26037-arch/physical_computing_project/docs/PHYSICS_V4.md

# V4 물리 검토와 Rev D 수정

기준은 `ab8c454`의 Rev C다. 주 구동계(측면4+D헤드, 6 mm 강재 막대, 24/30 mm 이송)는 유지하고, 운전 알고리즘·스위치 받침·접점 입력과 키 맞춤 공정을 보완했다. 출력물 종류/수량은33종93개로 같다.
**설계·코드 검증과 실물 하중 합격은 다르다. 서보의 끼임 힘을 물리적으로 제한하는 장치는 아직 검증하지 못했으므로 무인 운전이 가능한 완성품이라고 판단하지 않는다.**

## 발견한 문제와 반영한 해결

| 문제 | 근거 | 반영 |
|---|---|---|
| R/L 뒤집기가 중앙층을 보장하지 않음 | 모터는 R/L 바깥층의 핀만 구동한다. 중앙층·코어를 같은 각도로 묶는 연결이 없다. 마찰은 마모·윤활·가속에 따라 변한다 | **자동 뒤집기 폐지**. 상단을 고정한5면 알고리즘으로 섞기/풀이. 저수준 flip도 펄스0 |
| 해제된 접점만으로 두 헤드 후퇴를 판단 | 직렬 NO는 한쪽만 열려도 HIGH. 게다가 결합 스위치 해제는 완전 후퇴를 뜻하지 않음 | **모듈6개×결합/후퇴2개=12개**의 독립 끝 센서. 74HC165×2로3개 MCU핀에서 읽음. 짝의 모든 목표 끝 ON·반대 끝 OFF여야 진행 |
| 스위치 몸체가 이송 경로에 위치 | 기존 전진 스위치는 중간 캐리지와300.523 mm³ 겹쳤다. 단순히24 mm 뒤에 추가한 후퇴 스위치도 서보 크래들/링크와 겹침 | **P13/P29 바깥 받침**으로 모든 몸체를 x41에 배치. 몸체 안쪽 x34.6은 링크 최대x33보다 밖이다. 8 mm 이상 돌출한 긴 레버 끝만 캐리지에 접촉 |
| 순간 서보 끝각 지령의 접근 충격 | MG996R 실제 속도·하중이 미지정이며 이전400ms 표시는 힘/속도 제한이 아니었음 | **1도/4ms 지령**, 전체720ms. JS도 같은 각도 진행·시간 사용. 정적 과부하 제한은 별개 |
| 잠금 사각 유격이 탄성 변형보다 큼 | 6 mm 막대/6.4 소켓은 한 방향3.960°, 강재 막대의0.10N·m 탄성 비틀림은0.092° | 실제 막대와 이형 필름으로 **맞춤층 공정** 추가. 내부8mm 코어 키 틈도 충전. 경화·맞춤·전체 강성 실측은 필수 |
| 예전 간섭 검사로 물리 안정성을 과대 판단 가능 | 끝 자세·이산 BRep는 중간 접촉, 힘, 마찰, 적층 강도·크리프를 증명하지 않음 | 스위치/캐리지/크랭크/링크의13개 실제 중간 자세 검사 추가. 해석 계산과 실물 시험 결과를 별도 기록 |

## 5면 운전은 풀이 능력을 잃지 않는가

흰색 U를 아래로 장착한 orient=1을 유지한다. 논리 U는 물리D 헤드이고, 논리D는 헤드가 없는 상단이다. D회전을 제외한15개 수만 사용한다.
크로스는15수 IDA*와 그 집합의 쌍 거리표, F2L은 기존 U/측면 트리거, OLL/PLL은 D 없는 동등 수열을 사용한다. 기존 공식 중 D가 들어간 경우를 F2L을 보존하는 마지막층 그래프에서 변환했다.
일반6면으로 섞인 상태도 풀 수 있다. 로봇이 직접 만드는 섞기만 D를 제외한다. `M F D R` 같은 수동 명령은 앞부분도 실행하지 않고 전체 거부한다.
LOCK은 장착 중 계속 유지한다. F/FLIP은 실제/가상 모두 오류를 반환하며 모터 펄스를 내지 않는다.

`check_five_face_solver.js` 전수 결과:

- 크로스 **190,080상태**, D 없이 모두 도달, 최장 **10수**. 안전 탐색 한계14 이내.
- 마지막층 **62,208상태** 모두 해결. OLL216방향 상태·PLL288순열 상태, 최대 단계25수.
- 일반6면20수로 섞은 **1,000개 시드** 모두 해결, 최대75수, D회전0.
- 실제 C++와 JS를300시드로 교차 비교해 수열·탐색 노드 수3,300줄 일치.

## 새 센서 부품과 정확한 위치

추가 구매는 스위치6개(총12개), **74HC165 두 개**, 10kΩ12개와100nF2개다. 사진의74HC595는 출력용이므로 대체할 수 없다.
첫 페이지의 B18/B21과 개정 제작 설명서에 반영했다. 기존 직렬 센서 배선으로 새 펌웨어를 사용하면 안 된다.

| 모듈 | 몸체 중심 (국소 mm) | 장공 X / Z |
|---|---|---|
| F/R/B/L/D 결합 | (41,−47.75,137.1) | X37.75/44.25, Z137.1 |
| F/R/B/L/D 완전 후퇴 | (41,−47.75,180.9) | 같은 X, Z180.9 |
| LOCK 결합 | (41,24,194.1) | 같은 X, Z194.1 |
| LOCK 완전 후퇴 | (41,24,243.9) | 같은 X, Z243.9 |

긴 레버는 몸체 안쪽에서8 mm 이상 나와 캐리지 x≈28에 닿아야 한다. 앞/뒤 스위치는 접근 방향을 향하도록 긴 축 X 기준180° 반전한다. 실제 레버의 길이·작동점·오버트래블은 구매 도면과 대조한다. 스위치 몸체를 기계 스토퍼로 사용하지 않는다.
P13은 레일/프로파일 체결 기준을 유지한 채 바깥 탭을 추가했다. P29는 기존 M04 체결 두 점을 유지하고 바깥 플랜지를 추가했다. 새 파일로 출력해야 한다.

가까운74HC165 D0..D5=결합 F/B/R/L/D/LOCK, 먼 칩 D0..D5=후퇴 같은 순서다. 각 입력10kΩ→5V, NO→GND. 가까운 Q7→D12, 먼 Q7→가까운 DS, 두 CP→D13, 두 PL→A0, CE→GND. 먼 DS 및 D6/D7→5V. 칩당100nF. A1은 여유다.
시리얼 `I`는 실제 접점의 `SENS order=FBRLDK en=...... rt=...... frame=1`을 출력한다. 캐시된 장착 상태와 독립적으로12개를 하나씩 시험한다.
Q7을 상승 클록 **전에** 읽는다. 미사용 입력 네 개가 HIGH인지도 확인해 프레임 오류를 거부한다.
전진/후퇴를 명령한 뒤 접점을 확인하고, 매 회전 준비 전후에 전체 끝 상태를 재확인한다. 실패 후에도 캐시된 장착 상태만 믿지 않고 실제 접점을 다시 읽는다.

공개 부품 핀 명칭 근거: [Wokwi 74HC165 문서 원문](https://github.com/wokwi/wokwi-docs/blob/main/docs/parts/wokwi-74hc165.md). GPIO 클록 파형·접점 채터링·실제 배선은 보드에서 추가 확인한다.

## 강성·중력·관성 계산

`check_robot_v4_physics.py`는 mm를 SI로 바꿔 계산하고 `physics_checks.json`에 가정과 결과를 저장한다. 유한요소해석이나 재료 시험을 수행한 결과가 아니다. **0.10N·m는 시험 기준이며 드라이버가 자동으로 보장하는 토크 제한이 아니다.**

| 항목 | 계산 결과 / 의미 |
|---|---|
| 두 핀 균등 분담 | T/(2r)=2.618N/핀 (r19.1mm) |
| 한 핀에 전부 집중 | T/r=5.236N |
| Ø3 강철핀, 노출9.8mm 보수적 외팔보 | 최대 굽힘19.36MPa, 끝변위0.00207mm (E200GPa 가정) |
| 원통 결합2mm의 평균 접촉압력 | 한 핀 집중 시0.873MPa. 모서리 응력·적층 박리·충격은 포함하지 않음 |
| 6mm 강재 막대230mm 비틀림 | J≈0.1406a⁴, G79GPa일 때0.0915°. 알루미늄 G26GPa라면0.278° |
| 180mm 자유 구간의 강재 굽힘 | 끝 모멘트0.10N·m에서0.075mm, 가이드/고정부 변형 제외 |
| 기존 사각 소켓 한 방향 놀이 | asin(6.4/(6√2))−45°=3.960° |
| 맞춤층 총 평면 간극0.02~0.04mm | 소켓 놀이 최대0.383° + 강재 탄성0.092° = **0.475°**. 고정부·내부 키·경화재 변형은 추가됨 |
| Ø3/Ø3.4 핀 소켓 자체 놀이 | 한 방향 약0.600°. 반복 오차0.5°를 이 간극만으로 보장할 수 없음 |

100% 솔리드 CAD 큐브 체적155,612mm³에 PETG1.27g/cm³와 금속부속30g을 가정하면 큐브 질량은약0.228kg, 중력2.23N이다. 실제 충전율/재료/부속 질량을 측정해 대체한다.
기존 스텝 램프의 관성 추정은 한 층에약0.00025N·m다(시작 충격·스텝 리플·모터 회전자 제외). 정상 저속 운전에서는 관성보다 마찰과 간섭이 지배할 가능성이 크다. 따라서 걸림을 속도나 전류 증가로 해결하면 안 된다.

## 맞춤층은 어떻게 적용하는가

B22는 본체를 무조건 접착하라는 지시가 아니다. J02 시험편에서 실제 강재 막대를 원형으로 삼아 틈만 채우는 공정을 먼저 검증한다. 미경화 재료의 재질 호환성, 저수축·경화·압축 특성을 공급자 자료로 확인한다.
막대 네 평면에 이형 필름을 대고 전체 맞은편 치수가 실제 막대보다0.02~0.04mm 큰지 측정한다. 주름·겹침을 하중면에 두지 않는다. 이형 처리하지 않은 막대를 충전재에 넣으면 분리되지 않을 수 있다.
P03의6.4 소켓 벽에만 소량을 넣고 수동으로4mm 삽입해 정렬·완전 경화한다. 바닥/M3자리/가이드를 막지 않는다. 제거 후 미끄럼과30mm 왕복을 확인한다. 내부8.3 포켓/8mm 키도 나사·구면 트랙을 보호하며 틈을 채운다. 일반 센터4개와 움직이는 접촉면은 접착하지 않는다.
사각 형상과 M3 나사가 하중·축방향 이탈을 잡고, 맞춤층이 빈틈을 줄인다. 제조 공정 추가만으로 실제0.5° 미만을 달성했다고 주장하지 않는다. 전체 코어에50mm 레버×2N을 양방향으로 가해 합격을 확인해야 한다. 불합격이면 금속 정밀 키 인서트 등 재설계가 필요하다.

## 남은 물리적 한계: 사점에서의 삽입 힘

슬라이더 위치 z=axis−r cosθ−√(L²−r²sin²θ), 따라서
F≈τ / |dz/dθ|이다. 1N·m 서보를 가정하면 θ5°에서약718N,10°에서361N이 되는 이상 강체 값이다. 실제값은 서보·링크·전원·마찰·변형에 제한되지만, **사점에서 힘이 작아진다는 뜻은 아니다.**
720ms의 완만한 지령, 끝 센서, 타임아웃은 진입 충격과 잘못된 후속 회전을 줄인다. 접점은 힘 센서가 아니므로 핀이 비스듬히 걸렸을 때의 최대 정적 힘은 보장하지 못한다.
검증된 직렬 탄성 링크나 축방향 힘 제한기 없이 무인 운전용으로 확정하지 않는다. 이번 작업에서는 실측 없이 힘 제한 부품을 검증 완료로 꾸미거나 출력물 강도 인증을 만들지 않았다.

그 밖에 A4988 전류/실제 토크, 탈조·축 미끄러짐(엔코더 없음), 벨트 장력·크리프·피로·발열과 실제 레버 수명은 실물 시험 항목이다. 0.20/0.40N·m에서는 한 핀 평균 접촉압력이1.75/3.49MPa로 올라가므로0.10N·m 계산을 그 하중에 그대로 적용하지 않는다.

## 재현과 검증 범위

```sh
node tools/gen_robot_contract.js --check
node tools/check_robot_contract.js
node tools/gen_tables.js
node tools/check_five_face_solver.js
node tools/host_check.js 1 300
node tools/host_mechanism_check.js
node tools/test_sim_v4.js
python tools/check_robot_v4_physics.py
python tools/check_robot_v4.py
python tools/check_robot_v4_kit.py
python tools/check_robot_v4_meshes.py
python tools/check_robot_v4_manual.py
```

- 실제 C++ 기구 비교:648오류 시나리오·4,860명령 +4,096접점 조합(추가 프레임 오류 포함). 한쪽만 후퇴/양 끝 동시 닫힘·오류 복구·금지 수열의 전체 거부·실제 S42→V 실행 확인.
- 웹:1배/4배 총360수, 섞기→풀이, 장착/배출, 오류 복구, 금지D/FLIP. 40,987프레임, 뒤집기0.
- CAD: 본체 이산 검사와 키트의 스위치 몸체/크랭크/링크/캐리지13자세를 함께 검사한다. 실제 레버는 구매 도면 대조 대상이며 유연 접촉을 BRep 강체 간섭으로 승인하지 않는다.
- Arduino UNO R3/R4 WiFi 컴파일 결과는 `SETUP.md`에 기록한다. RAM 여유와 실측 스택 여유를 구분한다.
- Wokwi 시나리오는 생성했지만 현재 세션에는 CLI/토큰·실물 보드가 없어 전기 시뮬레이션과 실제 운전을 실행하지 않았다.
