26037-arch/physical_computing_project/docs/PIPELINE.md

# 개발 파이프라인

> 한 줄 요약: **공식표·거리표는 PC(Node)에서 생성 → 같은 알고리즘을 JS와 C++로 → Arduino CLI 컴파일 → Wokwi에서 보드 출력과 JS 출력을 글자 단위로 교차검증 → Fusion 360 API로 부품 생성·STL → 같은 STL을 JS 3D 시뮬레이터에 임베드.**

```
tools/algs.js (OLL 57 · PLL 21, 사람 표기)      sim/cube.js (큐브 모델, 18수, 표기 변환)
          │                                              │
          └────────────► node tools/gen_tables.js ◄──────┘
                         ├─ 공식 → 겉면 6면 수열 변환(wide/슬라이스/회전 제거)
                         ├─ 역연산으로 OLL/PLL 인식 키 생성, 216/288 전 경우 커버리지 검증
                         └─ 크로스 쌍 BFS 거리표, F2L 트리거 매크로 거리표 생성 (+ F2L 전수 해결 가능성 검사)
                 ┌─────────────────┴──────────────────┐
     firmware/main/tables.h (PROGMEM ≈10.8 KB)  sim/tables.js
                 │                                     │
   firmware/main/{cube,solver,motors}.cpp + main.ino   sim/solver.js (같은 IDA*·같은 순서)
                 │                                     │
                 ├──── node tools/host_check.js ───────┤  (g++ 로 펌웨어 풀이기 PC 빌드 → JS 와 시드별 출력 비교)
   scripts/build.ps1 (arduino-cli, Uno)                node tools/test_solver.js (300회 회귀)
   arduino-cli compile --fqbn arduino:renesas_uno:unor4wifi --output-dir build/r4 firmware/main (실물)
                                                       node tools/gen_wokwi_test.js <seed>
                 │                                     │  → tests/solve_seed<seed>.test.yaml
                 └──────────► scripts/simulate.ps1 -Scenario tests/solve_seed1.test.yaml
                              (V4 Rev D: 최상위 diagram.json / V5: v5/scripts/simulate.ps1 -Scenario tests/… (v5 기준), v5/diagram.json; 기구 줄 flips/spins 도 비교)
                              보드 시리얼 출력 == JS 풀이 출력 ⇒ 통과

tools/robot_v5_params.py (치수 P) ──► tools/check_robot_v5.py (2D 운동학·힘 평형) ──► models/robot_v5/kinematic_checks.json
                                   └──► tools/build_robot_v5.py (CadQuery) ──► models/robot_v5/print/*.stl|step, robot_assembly.step/glb, parameters.json
                                        tools/check_robot_v5_cad.py (3D 간섭) ──► mechanical_checks.json
                                        node tools/embed_models_v5.js ─► v5/sim/models.js (출력 7종 STL + 매개변수)
                                        fusion/scripts/import_robot_v5.py ──(Fusion MCP script)──► models/robot_v5/CubeRobotV5.f3d
                                                                                   │
                                            v5/sim/index.html + v5/sim/app.js (Three.js 3D 시뮬레이터: 시중 큐브 + 20° 컵 + 후드 + 리프터, v5/sim/mechanism.js 동작 목록 재생; 최상위 sim/ 은 V4 Rev D)
  (이력: V1 fusion/scripts/cube_robot_parts.py, V2/V3/V4 tools/build_robot_v*.py, models/robot_v2~v4)
```

## 두 버전
V4 Rev D 는 최상위(`firmware/main`, `sim/`, `tests/`, `scripts/`), V5 는 `v5/` 아래 같은 구조다. 아래 표의 경로 앞에 `v5/` 를 붙이면 V5 명령이 된다 (`node v5/tools/gen_wokwi_test.js 1`, `v5/scripts/simulate.ps1 -Scenario tests/solve_seed1.test.yaml` (시나리오 경로는 v5 기준)).

## 단계별 명령

| 단계 | 명령 | 결과물 |
|---|---|---|
| 1. 표 생성 | `node tools/gen_tables.js` | `firmware/main/tables.h`, `sim/tables.js` (커버리지 검증 포함, 실패 시 종료코드 1) |
| 2. 풀이기 회귀 | `node tools/test_solver.js 300 1` | 300 섞기 전부 풀림 + 수/노드/시간 통계 |
| 2'. 펌웨어 == JS (호스트) | `node tools/host_check.js 1 300` | g++ 로 `cube.cpp`·`solver.cpp` 를 PC 빌드해 300 시드의 단계·수열·노드 수가 JS 와 글자 단위로 같은지 확인 (Wokwi 없이 수 초) |
| 3. 컴파일(시뮬) | `powershell -ExecutionPolicy Bypass -File scripts/build.ps1` | `build/main.ino.hex` (Uno) |
| 3'. 컴파일(실물) | `arduino-cli compile --fqbn arduino:renesas_uno:unor4wifi --output-dir build/r4 firmware/main` | R4 WiFi 바이너리 |
| 4. 교차검증 시나리오 | `node tools/gen_wokwi_test.js 1` | `tests/solve_seed1.test.yaml` |
| 5. 시뮬레이션 | `powershell -ExecutionPolicy Bypass -File scripts/simulate.ps1 -Scenario tests/solve_seed1.test.yaml -TimeoutMs 180000` | `Scenario completed successfully` |
| 5'. 버튼 시나리오 | `... -Scenario tests/buttons.test.yaml -TimeoutMs 180000` | 무작위 시드로 섞고 풀어 `SOLVED ok=1` |
| 5''. V4 기구 절차 | `node tools/gen_mechanism_test.js` → `... -Scenario tests/mechanism_v4.test.yaml -TimeoutMs 150000` | 실제 모드: LOAD 장착 → `M F R U D`(지지 전환·막대·뒤집기, 시나리오가 결합 스위치를 눌러 줌) → 결합 실패 중단 → 배출 |
| 6. 3D 부품 (V4) | `.venv-cad\Scripts\python.exe tools/build_robot_v4.py` → `check_robot_v4.py` → `render_robot_v4.py` (CadQuery 2.7, Python 3.12 venv) | `models/robot_v4/**` STL·STEP·GLB, `parameters.json`, `mechanical_checks.json` |
| 6'. 3D 부품 (V2, 이력) | `python tools/build_robot_v2.py` → `check_robot_v2.py` → `render_robot_v2.py` | `models/robot_v2/**` |
| 6'. 3D 부품 (V1) | Claude Code 에서 `fusion_exec` 로 `fusion/scripts/cube_robot_parts.py` 실행 | `models/center_coupler.stl`, `center_cap.stl`, `motor_mount.stl` |
| 7. STL 임베드 | `node tools/embed_models_v4.js` | `sim/models.js` (V4 출력 부품 STL + `parameters.json` 의 `print_offsets`/`purchased`) |
| 8. 시뮬레이터 | `node tools/serve.js` → http://localhost:8765/sim/ (또는 `sim/index.html` 더블클릭) | 3D 시연 |
| 9. 업로드 | `powershell -ExecutionPolicy Bypass -File scripts/upload.ps1 -Port COMx -Fqbn arduino:renesas_uno:unor4wifi` | 실물 보드 |

## 에이전트 도구 사용

| 도구 | 쓰임 |
|---|---|
| Arduino CLI | Uno / UNO R4 WiFi 두 보드 컴파일, 플래시·RAM 사용량 확인 |
| Wokwi (CLI + MCP) | A4988·스테퍼 1 + 서보 2 회로 시뮬레이션, `write-serial`/`wait-serial`/`set-control` 시나리오로 자동 검증 (풀이 교차검증 + 실제 모드 기구 절차) |
| Fusion 360 (MCP `fusion_exec`) | Python API 로 부품 3종 생성, 치수 검사, STL 내보내기 (`CubeRobotParts` 문서로 저장) |
| Codex 플러그인 | AVR 핫패스 최적화(solver.cpp), 3D 부품 설계 검토(`docs/DESIGN_REVIEW.md`), 시뮬레이터·보고서 리뷰 |

## 자동 생성 파일 (직접 수정하지 않음)

- `firmware/main/tables.h`, `sim/tables.js` ← `tools/gen_tables.js`
- `sim/models.js` ← `tools/embed_models.js` (입력: `models/robot_v2/head/*.stl`, `models/robot_v2/parameters.json`)
- `tests/solve_seed*.test.yaml` ← `tools/gen_wokwi_test.js` (풀이 + 뒤집기/결합 횟수), `tests/mechanism_v4.test.yaml` ← `tools/gen_mechanism_test.js`

핀 배치를 바꾸면 `diagram.json` 과 `firmware/main/motors.h`(STEP/DIR), `mechanism.h`(서보·결합 스위치), `main.ino`(버튼·부저), `docs/HARDWARE_V4.md` 4절을 함께 바꾼다. 기구 절차는 `sim/mechanism.js` 와 `firmware/main/mechanism.cpp` 를 함께 바꾼다.
