26037-arch/physical_computing_project/docs/HARDWARE_V4.md

# 하드웨어 V4 Rev D — 상단 고정 5면 운전·승강 잠금 막대·개별 끝 센서

2026-10-24 · 상태: **CAD 시제품 + 펌웨어·시뮬레이터 구현, 실물 출력·조립·부하 시험 전**.
V3(고정 중앙축·수동 잠금·매 수 `H` 승인)를 대체한다. 이 문서는 펌웨어(`firmware/main/mechanism.*`), 시뮬레이터(`sim/mechanism.js`, `sim/app.js`), CAD(`tools/build_robot_v4.py`)가 공유하는 **치수·좌표·절차의 기준**이다. 세 곳의 숫자가 다르면 이 문서를 고치고 세 곳을 맞춘다.

## 0. 장치 목록 — 기능과 추가한 이유 (현재 기능을 위한 가장 단순한 구성)

큐브 둘레에 **같은 측면 모듈 4개**(F R B L), 아래에 **D 회전 모듈 1개**(측면 모듈과 같되 축이 비어 있고 모터가 옆으로 비킴)와 그 축 속을 지나는 **잠금 막대 1개**. 위는 비어 있다. 이송 모듈6개는 같은 서보 크랭크를 쓰며4개 신호로 제어한다. 각 모듈의 결합/완전 후퇴 끝을 독립 스위치로 확인한다. 흰색 U를 아래로 두고 논리D인 물리 상단은 고정한다.

| 장치 | 수량 | 기능 | 왜 필요한가 (없으면 무엇이 안 되나) |
|---|---|---|---|
| NEMA17 + A4988 (측면 F R B L) | 4 | 면 90°/180° 회전. 정지 중에는 유지 토크로 잡은 층을 고정 | F·B·R·L 수를 돌린다 |
| NEMA17 + A4988 (아래 D, 옆으로 60 mm 비킴, GT2 40T:40T 벨트) | 1 | **아래 면(D) 회전** (사용자 요구: 아래 회전축 유지) | 논리U 층을 아래에서 돌린다. 논리D인 상단은 고정한다. 모터가 축 위에 있으면 잠금 막대가 지나갈 수 없어 옆으로 비키고 벨트 1:1 로 돈다 |
| **중공 회전축** (OD 17 / ID 12.5, 6003 베어링 2) | 1 | D 구동판·핀을 돌리면서 가운데로 잠금 막대를 통과시킨다 | 막대가 아래에서 큐브 중심까지 올라오는 길 |
| 2핀 구동판 + 강철 핀 Ø3 (끝 원뿔 90°) | 5 (측면 **적도 띠 판** 4 + D 판 1) | 엣지 2개의 소켓(90° 카운터싱크 Ø7)에 핀을 꽂아 층을 민다 (측면은 적도 엣지, D 는 DF·DB 엣지). 원뿔 끝과 카운터싱크가 3 mm 까지의 어긋남을 스스로 맞춘다 | 핀으로 층을 돌린다(V2 그대로). 4핀 대신 2핀: D 를 돌릴 때 측면 핀이 D 층 엣지에 박혀 있으면 안 되고, D 구동판 가운데 구멍(Ø22)으로 막대가 지나가야 한다. 측면 판은 **16×50 적도 띠**: D 층 코너가 y축 둘레 반경 38.65 로 쓸고 지나가므로 50×50 판(면에서 5~11 mm)이면 측면 쌍을 결합한 채 D 를 돌릴 수 없다 (2026-10-24 CAD 검사에서 45° 자세 코너당 590 mm³ 겹침 확인) |
| **잠금 막대** (강철 **6×6**, 승강 30 mm) | 1 | 아래에서 중공축을 지나 큐브 **가운데 위치**(U/D 센터 칸 → 센터 판의 사각 소켓)까지 올라와 **코어를 고정** — V3 의 고정 중앙축 역할. 장착 중 올라가 있고, **큐브 배출 때 내려간다** | 측면 한 면을 돌릴 때 큐브 전체가 따라 도는 것을 막는다(V3 가 축으로 해결한 문제). 내려갈 수 있어 장착·배출이 가능하다 |
| 서보 MG996R + 크랭크 + 링크 36 | 6 (신호 4) | 이송 유닛 결합/후퇴. F/B 서보 2개 한 신호, R/L 2개 한 신호, D 1, 막대 1 (크랭크 r12 → 24 mm, 막대는 r15 → 30 mm) | V2/V3 의 수동 M5 나사(24 mm 에 30바퀴)를 자동화. 서보 지령 각도와 별개로 양 끝 센서를 확인한다. 사점 부근 삽입 힘은 커질 수 있으며 별도 실물 시험이 필요하다 |
| 결합/후퇴 마이크로스위치 | 12 (74HC165 두 개) | 각 모듈의 양 끝을 독립 확인 | 핀/막대가 소켓에 안 들어가면 스위치가 안 눌린다 → **회전을 실행하지 않고 중단** |
| MGN12 레일 180 + MGN12H 블록 | 5 | 캐리지 직선 안내 | 24 mm 이송의 흔들림 없는 안내 (V2 그대로). 막대는 출력 가이드 블록으로 안내 |
| 608 ×2 + F8-16M + 커플링 5→8 + Ø8 축 | 4세트 | 측면 스핀들 지지 | V2 그대로 |
| 도넛 큐브 (출력, 코어 1·센터 4·**파인 센터 2**·엣지 12·코너 8) | 1 | U/D 센터는 두께 3 판이 8 mm 안에 있고(도넛 구멍), 판 바깥면에 **6.4 사각 소켓 깊이 5**(막대 끝 아래 **축방향 여유 1 mm**), 판 줄기는 **사각**이라 코어와 함께만 돈다 | 막대가 들어갈 자리와 코어를 잡을 소켓. 나머지는 V2 출력 큐브 그대로 |
| 버튼 1개 (A2) | 1 | **짧게** = START (모델이 풀린 상태면 섞기, 아니면 풀기), **1.2 s 이상** = LOAD 단계(장착/배출) | 핀 18개 중 17개를 모터·서보·스위치·LCD 가 쓴다. 저항 사다리(버튼 3개를 A0 하나에)는 Wokwi 가 아날로그 저항망을 재현하지 못해 검증할 수 없어 버튼 하나로 줄였다 |
| LCD1602 I2C, 부저 | 1, 1 | 단계·상태 표시, 완료/오류 알림 | 기존과 같음 |

**없앤 것과 이유**: 위(U) 헤드 — 위가 열려야 큐브를 넣고 뺄 수 있고, 흰색 U가 아래인 자세를 유지해 아래 D헤드로 논리U를 돌린다. 고정 중앙축·인덱스 휠·잠금핀(V3) — 승강 잠금 막대와 결합 스위치가 대신한다. 승강 벨트·원점 스위치(초안) — 큐브는 손으로 D 핀 위에 올려놓는다. 스텝모터 DIR 핀 5개 — 한 번에 한 모터만 움직이므로 DIR 1개를 공유한다.

## 1. 무엇이 바뀌었나 (V3 → V4)

| V3 | V4 | 이유 |
|---|---|---|
| 회전 헤드 6개 (U 포함) | **측면 헤드 4개 + 아래 D 헤드 1개**, 위는 비어 있음 | 위가 열려야 큐브를 넣고 뺄 수 있다. U 면은 처음부터 아래에 놓고, 상단 D는5면 알고리즘에서 제외한다 |
| 큐브를 관통하는 고정 Ø6 중앙축 (F↔B) | **승강 잠금 막대 6×6** (아래 → 큐브 중심). 장착 중 올라가 코어를 잡고, 배출 때 내려감 | 축의 "큐브 전체 회전 방지" 기능은 유지하면서 장착·배출이 가능 |
| F/B 중공축 + 벨트 | **D 만 중공축 + 벨트** (막대 통과), F/B 는 직결 | 막대가 아래에서만 들어온다 |
| 수동 M5 이송 | 서보 6개·명령 유닛 4개 모두 **서보 크랭크** 이송 | 한 방향 이송 지령720ms + 끝 센서 확인 |
| 수동 잠금핀 | 스텝모터 유지 토크 + 잠금 막대 + 결합 스위치 확인 | 자동 운전; 결합이 확인되지 않으면 회전을 **실행하지 않는다** |
| 4핀 구동판 | **2핀 구동판** (측면: 적도 엣지, **16×50 띠**; D: DF·DB, 50×50) | D 회전 중 측면 핀도 판도 D 층을 막지 않게 — 측면 쌍은 결합한 채 D 를 돌린다 |

## 2. 좌표계와 치수 (CAD = 시뮬레이터)

### 물리 검토 Rev D — 상단 고정 운전 (Rev C 뒤집기 절차보다 우선)

형상·행정·프레임은 Rev C를 유지한다. R/L 헤드가 코어/중앙층을 직접 구동하지
않으므로 마찰에 의존한 자동 뒤집기를 폐지한다. 흰색 U를 아래로 장착한
orient=1을 유지하고 논리 D(물리 상단)를 움직이지 않는 15수로 섞고 푼다.
LOCK은 장착 중 계속 결합하며, F/FLIP과 수동 D 명령은 실행 전에 거부한다.
크로스·OLL/PLL 생성표와 JS/C++ 풀이기를 같은 허용 수 집합으로 갱신한다.
각 모듈의 결합/완전 후퇴 스위치를 분리한다(6×2=12개). 입력은74HC165 두 개로
읽고 D12=DATA, D13=CLOCK, A0=/LOAD를 쓴다. A1은 비워 둔다. 기존 직렬
스위치 배선과 혼용하지 않는다. P13에 후퇴 스위치 장공을 추가하고 P29를
두 스위치용으로 연장한다. 서보 사점 과부하 한계는 물리 검토 문서를 따른다.

### 소프트웨어 공통 계약

Rev C의 주 구동계를 유지하고 P13/P29 스위치 받침을 보완한다. 제어 핀·서보 각도/720 ms 이송·모터 펄스와
초기 미장착 상태·논리/물리 면 매핑은 `config/robot_v4.json` 한 곳에서 관리한다.
`tools/gen_robot_contract.js`는 이 설정과 CAD `parameters.json`으로 C++/JS 계약을
생성한다. 웹 재생 배속은 표시만 바꾸며 실제 보드의 속도 설정을 바꾸지 않는다.
Rev D에서는 뒤집기를 사용하지 않는다. 센서 실패 시 해당
수를 실행하지 않고 완료된 수까지의 큐브 상태를 보존한다. 최신 검증은
`docs/PHYSICS_V4.md`를 따른다. `CONSISTENCY_V4.md`는 Rev C 이력이다.

### 통합 제작 Rev C (이전 Rev A/B보다 우선)

원격 `83ade39`의 측면16×50 띠 판/P30·전용 허브, 6×6 잠금 막대,
6.4 사각 소켓(깊이5), 원뿔 끝 Ø3×16 핀과 Ø7 카운터싱크를 유지한다.
잠금 결합 끝 world y=-22.5, 실제 삽입4/바닥 여유1.0, 가이드6.3/캐리지6.1,
J02는6.2/6.3/6.4, J03 두께9.8이다. D는 기존50×50 P07 한 개를 쓴다.
여기에 Rev B의 공통3점 P14 프로파일 직결, P13 턱/장공/위치 결정 포켓,
P23/P29 뒤쪽 인서트와 짧은 나사를 결합한다. 레일은 z4.5..184.5다.
측면 띠 판은 국소 |x|≤8로 D층 상단(-9.7)과 명목1.7 여유를 둔다.
크랭크/링크/서보축과 행정24/30 mm, 제어 절차는 유지한다.
최종 출력은33종93개, 첫 장 번호63개다. M3 인서트69/M4 인서트14,
F17/F18 수량0, F11 32세트/F25 5세트다. 핀은 90° 원뿔 끝(Ø1,높이1)을
갖는 가공 구매품이며 일반 평끝 핀과 혼용하지 않는다.
U/D 센터의 F03은 M3×10 두 개다. 머리 받침면은 중심에서18.5,
인서트 입구11이므로7.5 mm를 통과한 뒤2.5 mm 물린다. M3×14는 안쪽
막힌 파일럿 끝5.5를 지나므로 사용하지 않는다. 일반 센터는 M3×16을 유지한다.
6 mm 막대의 상대 비틀림 강성은 같은 재질/길이의8 mm 대비(6/8)^4≈0.316이다.
원뿔 입구의 포획 범위는 최종 반복 정밀도나 마찰 상태의 자동 정렬을 보증하지 않는다.
변경별 장단점과 채택 이유는 `docs/BUILD_V4_MERGE_REVIEW.md`를 따른다.

### 조립 단순화 Rev B 이력 (Rev C 변경은 위 절 적용)

Rev A의 큐브·축 배치, 모터/서보 수, 서보 축, 24/30 mm 행정과 링크36은 유지한다.
다음은 조립 기준면과 고정부만 바꾼다. 펌웨어의 행정·서보 각도는 그대로다.

- P14 공통 서보 크래들5개는 2060에 직접 3점 체결한다. 위쪽은
  국소(x,z)=(±20,239), 6T 플랜지에 M5×12 두 개, 아래쪽은(-20,171),
  3T 발+P13 6T를 관통하는 M5×16 한 개다. 모든 나사는 Y 방향이다.
  전산봉20개·간격관20개와 패널의 Ø3.6 구멍20개를 제거한다.
- P14 아래 발의 위치 결정 돌기는 x=-28..-12, y=-51.8..-51,
  z=179..183다. P13에는 폭16.4/높이4.4/깊이1.0 포켓을 둔다.
  위치를 손으로 맞추고 돌기가 들어간 상태에서 3점 체결한다. 돌기는 기준만
  제공하며, 하중은 밀착면과 볼트가 받는다. P25 잠금 서보는 기존 M04 체결 유지.
- P13의 레일 좌우 턱은 안쪽 x=±6.2, 돌출1.5(y=-51..-49.5),
  z10..175이다. 레일 폭12 대비 양쪽0.2, MGN 블록 날개 대비0.5 여유.
  레일 앞끝 z4.5/뒤끝184.5에 맞춰 멈춤 턱을 둔다. 기존 z5..185에서는
  서보 몸체 앞끝184.95와 0.05 겹치므로 레일만0.5 앞당겨0.45 여유를 만든다.
  블록/캐리지/축 위치와 행정은 유지한다. 레일 체결공은 중심
  z15부터25피치7개, 폭3.4/전체길이14의 Z방향 장공으로 바꾼다.
  최초 홀 오프셋10 또는15인 레일은 장공 안에서 맞추며, 그 밖은 구매도면 대조.
- 레일의 M3 체결은2060 중앙 T슬롯(x=0)의 M3 T너트7개/레일로 받는다.
  P13 뒤에 일반 육각너트를 가둬 조립 후 접근할 수 없게 만들지 않는다.
  구매2060은 넓은 면 슬롯 x=-20/0/+20을 모두 갖춰야 한다. 레일을 놓기 전
  중앙 슬롯에 T너트를 배치하고 위에서 체결한다. 나사 길이는 실제 레일의
  카운터보어 받침면~밑면+P13 6T+너트 물림으로 정하며 머리는 레일 안에 둔다.
- P23의 기존 네 X 관통공을 뒤쪽 M4 인서트 OD5.6×L4 자리로 바꾼다.
  M04 뒤에서 M4×12+와셔 네 개로 조립한다(6T 금속판+와셔 약1,
  인서트 유효 물림 약4). P29의 두 공도 M3 OD4.6×L4 인서트로
  바꾸고 M3×12+와셔 두 개를 쓴다. 긴 관통 나사와 반대편 너트를 없앤다.
  인서트 입구는 모두 국소 x=-30, 나사 끝 여유는 실측한다.
  인서트 뒤 나사 끝 도피공은 P23 Ø4.3(막힌 끝 x=-21), P29 Ø3.4(x=-19)다.
  나사 끝이 인서트를 지나도 출력물의 작은 파일럿 홀에 박히지 않게 한다.
  P29 가로 팔의 Y두께는6→8로 늘려 M3 인서트 주변 최소 벽을0.7→1.7로 확보한다.
- M3 인서트 총69, M4 인서트 총14. 출력은 기존과 같은32종93개다.
  프레임 크기와 2060 절단 길이, 핀/소켓/사각 잠금 공차는 유지한다.
- P14/P25와 캡의 X 맞댐 면은18.3, 크래들 끝은18.15로0.15 여유를 둔다.
  크래들 아래와 캡의 P13 공간을 제거하고 레일 끝 주위에 폭12.6/높이8.6
  통과 공간을 둔다. 고정부끼리의 기존 명목 중첩을 제거한다.

이 변경은 길이 맞춤·눈대중 정렬을 줄이는 제작 개선이다. 인서트 뽑힘,
출력물 크리프, 프레임 변형과 반복 뒤집기는 실물 시험으로 확인한다.

### 2026-10-24 제작 보강 Rev A (본 절의 이전 치수보다 우선)

행정 24/30 mm, 서보 축, 링크 36 mm, 큐브·핀 위치는 유지한다. 이송 명령과
펌웨어 상수는 바뀌지 않는다. `docs/BUILD_V4.md`와 새 PDF가 제작 순서를 정한다.

- 레일 지지대-2060 체결: 국소 x=±20, z=25/120의 Ø5.4 네 구멍.
- 서보 마운트: MG996R 몸체를 고정 크래들+분리 캡으로 포획. 몸체 공간은
  x=-24.95..18.3, y=-54..-34, z=184.65..225.95. 구매품 실측을 우선한다.
  관통 M3 구멍은 X 방향 (y,z)=(-30,181)/(-44,231). 4개 M3 봉은 x=-20/12,
  y=-55.5/-32.5에서 프레임까지 이어지고 마운트 뒤 z234부터 길이36/69.5
  간격관이 위치를 정한다. 캡 앞쪽 귀는 후퇴 캐리지 보스를 피한다.
- 크랭크 중심에 Ø16 디스크, 중심 Ø3.2, y=±5의 Ø2.2 두 구멍 추가.
  실제 25T 금속 원형 혼에 M2 두 개로 체결한다. 출력물 구멍을 스플라인으로 쓰지 않는다.
- D 허브의 원통부 OD32, 17.15 보어. M4 인서트 자리의 반경 범위12..17.
  D 하우징의 캐리지 체결 관통공은 x=±24,z=38.5/48.5, Y 방향 Ø3.4.
- 측면 뒤 추력 베어링8×16×5(z54..59)+금속 분할 링8×16×7(z59..66),
  D 뒤 추력 베어링17×30×5(z60..65)+금속 분할 링17×28×8(z65..73).
- 잠금 가이드는 사각8.3 보어/길이22, x=-30까지의 체결 팔과
  X 방향 Ø4.4 네 구멍(y=±9,z180/190)으로 금속 지지판에 고정한다.
- 공통 프레임: 바닥621×621×18, 측판450 높이, 내부 평면x/z=±298.5,
  바닥 위 y=-332. 측면2060 길이268, D2060 길이301.5. 프로파일 앞끝은
  국소z2, 뒤끝270/303.5다(사각 앞끝의 R/D 충돌을 피함).
  금속 잠금 지지판은 D 국소 x=-36..-30,y=-77..47,z=172..298.
  도면·절단 파일은 `models/robot_v4/assembly_kit/`에 있다.
- 잠금 막대는 **6×6**(2.2·2.5절, 이 Rev A 초안의 8×8·결합 끝 −23.8 안을 대체).
  결합 끝 y=−22.5, 후퇴 끝 −52.5, 소켓 6.4×깊이 5 라 바닥·M3 머리까지 축방향
  여유 1.0. 이송 30 과 서보축은 바뀌지 않는다. 중공축 내경은 12.5 로 확대해
  사각 막대의 명목 대각 여유는 (12.5−6√2)/2 = 2.0 이다. 가이드 6.3, 클램프 6.1.
- 측면 구동판은 16×50 적도 띠 `drive_plate_strip`(P30, 4개)이고 D 만 50×50
  `drive_plate_2pin`(P07, 1개)이다. 핀은 끝 90° 원뿔, 소켓은 Ø7 카운터싱크·깊이 6,
  삽입 4.8 (2.2·2.3절). J03 핀 깊이 지그는 9.8 T, J02 사각 시험편은 6.2/6.3/6.4.
- 코어의 U/D 사각 포켓 안쪽 y절대값7..11.05에 Ø4.6 인서트 자리를 추가한다.
  M3×14로 파인 센터를 고정한다. 기존 외측 자리는 사각 포켓이 제거한다.
- D 하우징은 앞/뒤 인서트 자리 Ø4.6 깊이4.1을 추가한다. 총 M3 인서트67,
  M4 인서트10이다. 새 추가 P29·P30과 J01~J03을 합친 출력은33종93개다.

시뮬레이터는 direct/hollow 접미사가 있는 실제 STL을 읽고 새 캡·잠금 가이드와
막대 끝·서보 축을 반영한다. 프레임은 STEP를 기준으로 검토하며 시뮬레이터의
운동 절차나 펌웨어의 서보 각도·행정 상수는 바뀌지 않는다.

명목 기하 검사는 실물 강도·반복 오차를 보증하지 않는다. 특히 마찰에 의존한
뒤집기, 센서가 실제 핀 삽입을 대신 확인하는 가정은 실물 검증 전이다.

월드 좌표: 큐브 중심 원점, **+y 위(U), +x 오른쪽(R), +z 앞(F)**. 단위 mm.
각 모듈은 자기 **국소 좌표 (x, y, z)**로 생성되고, 국소 +z 가 면 바깥 법선, 국소 z=0 이 큐브 면 평면이다 (V2 `head_parts()` 규약 그대로).

### 2.1 면 좌표계 `FACES_V4`

| 면 | 법선 n | 국소 x 방향 (xDir) | 국소 y = n × x | 레일(국소 −y)이 향하는 쪽 |
|---|---|---|---|---|
| F | (0, 0, 1) | (0, 1, 0) 위 | (−1, 0, 0) | **+x** |
| R | (1, 0, 0) | (0, 1, 0) 위 | (0, 0, 1) | **−z** |
| B | (0, 0, −1) | (0, 1, 0) 위 | (1, 0, 0) | **−x** |
| L | (−1, 0, 0) | (0, 1, 0) 위 | (0, 0, −1) | **+z** |
| D | (0, −1, 0) | (1, 0, 0) | (0, 0, 1) | **−z** (비킨 모터는 국소 +x = 월드 +x) |
| 잠금 막대 | (0, −1, 0) | (1, 0, 0) | (0, 0, 1) | D 모듈 아래, 막대 축 = y 축 |

네 측면 헤드는 국소 x 가 월드 +y(위)라서 **핀 2개는 국소 (0, ±19.1)** = 적도 엣지(FR/FL, RF/RB, BR/BL, LF/LB). D 헤드의 핀 (0, ±19.1) 은 월드 z ±19.1 = DF·DB 엣지. 레일 지지판(국소 y −51~−57, x ±30, z 0~190)은 바람개비로 돌아가 서로 만나지 않는다 (F: x 51~57 / z ≥ 28.5, R: z −51~−57 / x ≥ 28.5, B: x −51~−57 / z ≤ −28.5, L: z 51~57 / x ≤ −28.5, D: z −51~−57 / y ≤ −28.5, x ±30 — B 지지판과 x 가 겹치지 않는다). 위(+y)는 큐브 기둥(x, z ±28.5)이 비어 있어 손으로 큐브를 넣고 뺀다.

### 2.2 큐브 (`cube_mm`=57, 조각 18.8, 피치 19.1, 간극 0.30 — V2 그대로)

| 항목 | 값 |
|---|---|
| 엣지 소켓 | Ø3.4 **깊이 6.0**, 입구 **90° 카운터싱크 Ø7.0 (깊이 1.8)** (`socket_countersink_mm`), 노출면 2곳. V2(깊이 4.2, 싱크 Ø4.4×0.6)보다 깊고 넓다: 뒤집기 뒤 잡히지 않은 층의 어긋남을 핀 원뿔이 받아 들어가며 맞춘다 |
| F/R/B/L 센터 | V2 `cube_center` 그대로 (M3 나사·스프링, 자유 회전) |
| **U/D 센터 `center_recessed`** | 캡 대신 **판 두께 3** (면에서 2 mm 안쪽: 면 평면 −28.5 기준 z −26.5~−23.5). 판 바깥면에 **사각 소켓 6.4×6.4 깊이 5** (`lock_socket_mm`, `lock_socket_depth_mm`): 판 3 mm 를 지나 목(Ø8.8) 안으로 2 mm 더 들어간다 (목 측벽 1.2, 소켓 모서리 r 4.53 이 목 r 4.4 를 0.13 넘지만 하중은 평면이 받는다). 소켓 바닥 y = −21.5 아래에 M3 원통머리 자리 **Ø6×3** (y −21.5~−18.5, 목 벽 1.4) 과 관통공 Ø3.4. 줄기는 **사각 8×8** 로 코어의 사각 구멍에 끼워져 코어에 대해 돌지 않는다 (M3 로 체결) |
| **소켓 칸 (도넛 구멍)** | 센터 칸 자리 = 엣지 4개의 측벽으로 둘러싸인 사각 구멍 19.4 × 19.4, 깊이 2 (`recess_depth_mm`) |
| **잠금 막대** | **6 × 6** (`lock_bar_mm`) 강재, 결합 시 끝이 y = **−22.5** (칸 2 + 소켓 4 = 6 삽입, 평면 결합 3 = 소켓 4 − 모따기 1). **소켓 바닥(−21.5)·나사 머리까지 축방향 여유 1.0** (`lock_axial_clearance_mm`) → 크랭크 사점 위치와 출력 공차가 겹쳐도 막대가 큐브를 밀어 올리지 않는다. 엣지 벽까지 여유 (19.4−6)/2 = **6.7** → 측면 회전을 막지 않는다 |
| 코어 | V2 `cube_core` + U/D 사각 구멍 |

U/D 센터가 코어에 고정돼 있어도 층 회전은 가능하다: 엣지·코너의 발은 센터 판 밑 구면 트랙(회전 대칭)을 미끄러진다. 막대가 판 소켓을 잡으면 **코어가 프레임에 고정**되어 측면 회전의 반력을 받는다.

### 2.3 측면 모듈 (F R B L, 4개 동일) — V2 직결 모듈 바탕

| 부품 | 국소 위치 (z 는 면 평면 기준) | 변경 |
|---|---|---|
| `drive_plate_strip` | **적도 띠** 판 16(국소 x)×50(국소 y)×6, z 5~11, 중앙 Ø13 구멍(센터 나사 접근); 패드 보스 2개 8×4 (0, ±14.5) z 0.8~5 + 실리콘 패드 0.8 (적도 엣지 위) | 핀 구멍 **2개** (0, ±19.1). 국소 x = 월드 위이므로 판은 월드 \|y\| ≤ 8 안에 있고, D 층(y ≤ −9.7, 쓸림 반경 38.65)이 **측면 쌍을 결합한 채** 돈다. 볼트 M3 4개 (±3.5, ±9), 머리 자리 Ø5.8 |
| 강철 핀 Ø3×16 ×2 (`pin_length_mm`) | z **−4.8~11.2**, 끝 **90° 원뿔 Ø3→Ø1, 높이 1** (`pin_tip_mm`, `pin_tip_h_mm`) | 삽입 **4.8** (`pin_engagement_mm`): 원뿔 1 + 원통이 카운터싱크 아래 Ø3.4 구멍과 **2.0 mm** 결합, 바닥 여유 1.2. 판이 잡는 길이 6 (z 5~11) |
| `shaft_hub` | 플랜지 **16×32**×5 (z 11~16) + Ø24 (16~28), 히트셋 포켓 Ø4.6 4개 (±3.5, ±9) | 플랜지를 띠 폭으로 줄이고 볼트를 띠 패턴으로 옮김. 플랜지 앞면 z 11(월드 39.5)은 쓸림 반경 38.65 밖이지만 폭도 \|y\| ≤ 8 로 맞춘다 |
| 608 ×2, F8-16M, 하우징, 캡, Ø8 축, 커플링, NEMA17 | V2 그대로 (추력 28~33, 하우징 35~52, 모터 104~144) | 변경 없음 |
| `carriage` | 32~152, MGN12H 블록 | 너트 포켓 대신 **크랭크 링크 핀 보스** (x 22, y −44, z 147) |
| `rail_support` | y −54 (두께 6), z 0~190, 앞쪽 x 양끝 모서리 1.6 mm 모따기 | 뒤 끝에 **서보 마운트** (축 중심 x 22, y −44, **z 195**, 축 방향 국소 x) |
| 서보 크랭크 r **12**, 링크 **36** | θ=0° (−z, 큐브 쪽) → z 147 = **결합(0)**; θ=180° → z 171 = **후퇴 24** (양 끝 사점) | 195−12−36 = 147, 195+12−36 = 171 |
| 끝 스위치 | P13 바깥 돌출부 x41, z137.1/180.9 | 긴 레버 끝만 전진/후퇴 캐리지에 닿음, 몸체는 전체 궤적 밖 |

### 2.4 D 모듈 — V3 중공 모듈 바탕 (`build_robot_v3.module_design(hollow=True)`)

| 부품 | 값 |
|---|---|
| 중공 회전축 | OD **17** / ID **12** (`hollow_id_mm`), 길이 82. 6003 베어링(17×35×10) 2, 추력 베어링 앞뒤 |
| 구동판·핀 | `drive_plate_2pin` 50×50×6 (D 전용 1개, 중앙 Ø22 로 막대 통과, 모서리 패드 4). D 판은 측면 회전 전에 항상 후퇴하므로 띠로 줄일 필요가 없다 |
| 모터 | NEMA17 국소 x = **+60** 으로 비킴, 40T:40T GT2 벨트 1:1, 200-2GT-6 (V3 그대로) |
| 이송·스위치 | 측면과 같은 서보 크랭크 r12 / 링크 36 / 24 mm, 개별 결합/후퇴 스위치2개 |

### 2.5 잠금 막대 유닛 (D 모듈 아래, y 축)

| 부품 | 값 |
|---|---|
| 막대 | 강재 **6×6**, 길이 ≈ 230 (끝 모따기 1). 결합 끝 y = **−22.5**, 후퇴 끝 y = **−52.5** (`lock_stroke_mm` = 30) |
| 안내 | 출력 가이드 블록(사각 구멍 6.3) + 캐리지(클램프 구멍 6.1, 고정 나사), D 모듈 레일 지지판 뒤쪽 프레임에 고정 |
| 서보 크랭크 r **15**, 링크 36 | θ=0° 결합(위), 180° 후퇴(아래), 개별 결합/후퇴 스위치2개 |
| 뒤집기 여유 | 큐브 외곽 반경 28.5·√2 = 40.31 < 52.5 → **12.2** |

### 2.6 여유 계산 (명목)

| 항목 | 값 |
|---|---|
| 후퇴한 F/B(또는 R/L) 핀 끝 | 28.5 + 24 − 4.8 = **47.7** → 뒤집기 여유 7.4 |
| 후퇴한 D 핀 끝 | 47.7 → 7.4 |
| **핀 포착 여유 (면내)** | 카운터싱크 r 3.5 − 핀 끝 r 0.5 = **3.0** → 측면 소켓(y축에서 지렛대 28.5) **±6.0°**, D 소켓(지렛대 19.1) **±9.0°**. 막대 사각 유격 0.4/6 = ±3.8° 는 측면 소켓을 1.9 mm 옮기므로 안에 든다 |
| **막대 끝 ↔ 센터 판 소켓 바닥·M3 머리** | 소켓 깊이 5 − 삽입 4 = **1.0** (축방향; 사점 크랭크라 0 이면 공차가 그대로 밀어 올리는 힘이 된다) |
| 막대 ↔ 엣지 벽 | **6.7** |
| 막대 ↔ 중공축 안 | (12 − 6·√2)/2 = **1.76** (대각; 8×8 이던 때 0.34) |
| **D 층 회전 ↔ 결합된 측면 띠 판** | D 층 윗면 y = −9.7, 띠 판·허브 플랜지 \|y\| ≤ 8 → **1.7** (쓸림 반경 38.65 는 판 안쪽면 33.5 보다 크므로 폭으로만 피한다) |
| D 층 회전 ↔ 측면 허브 Ø24 (z ≥ 16) | 44.5 − 38.65 = 5.85 |

CAD 조정: V2 구면 유지 트랙을 보존하려고 센터 함몰 8→2 mm, 판 범위 −20.5~−17.5→−26.5~−23.5 mm, 막대 결합/후퇴 끝 −17.5/−47.5→−23.5/−53.5 mm로 조정했다. 원안은 엣지·코너 16쌍과 최대 115.178917 mm³ 겹쳤다. V2 목 반경 4.4와 트랙 여유 구면 반경 23.8을 연결하는 함몰 한계는 약 2.11 mm여서 2 mm를 채택하며, 판은 Ø18.8 회전 대칭 외곽, 사각 줄기와 원형 목 사이 전이는 트랙 안쪽에 둔다. R/D 지지판 앞모서리의 13.5 mm³ 겹침은 5개 공통 지지판의 앞쪽 x 양끝 1.6 mm 모따기로 없앤다(이론 접촉 한계 1.5 mm + 여유 0.1 mm). 행정 24/30 mm와 서보 축·크랭크·링크 치수는 유지한다.

2026-10-24 핀 자동 정렬: V2 핀은 끝이 평평하고 소켓 싱크가 Ø4.4×0.6 이라 반경 0.5 mm(측면 ±1.0°)밖에 받지 못했다. 뒤집기 뒤에는 M 슬라이스 지연과 막대 유격(±3.8°)으로 소켓이 1.9 mm 까지 옮겨 있을 수 있어 핀이 들어가지 못한다. 핀 끝을 90° 원뿔(Ø3→Ø1, 높이 1)로, 소켓 입구를 90° 카운터싱크 Ø7(깊이 1.8)로 바꿔 면내 포착 3.0 mm 를 만들고, 원통 결합 2 mm 를 지키려고 소켓을 6.0 깊이로, 삽입을 4.8 로 늘렸다. 후퇴 핀 끝은 47.7 이라 뒤집기 여유는 9.2→7.4 mm 다. 소켓 검사편도 같은 카운터싱크·깊이로 바꿨다.

2026-10-24 막대 축방향 여유: 8×8 막대·8.4 소켓에서는 막대 끝(−23.5)이 소켓 바닥 = M3 머리 윗면에 **여유 0** 으로 닿는 설계였다. 판 두께 3 은 트랙 구면(r 23.8)이 허용하는 최대라 판을 두껍게 할 수 없고, 8.4 소켓(모서리 r 5.94)은 목(r 4.4) 밖이라 소켓을 목 안으로 연장할 수도 없었다. 막대를 **6×6**, 소켓을 **6.4 × 깊이 5** 로 바꿔 소켓이 목 안으로 2 mm 들어가게 하고, 끝을 −22.5 에 세워 바닥(−21.5)과 머리(Ø6 자리, −21.5 아래)에 **1.0 mm** 여유를 둔다. 평면 결합은 2→3 mm, 중공축 대각 여유는 0.34→1.76 mm 로 늘고, 뒤집기 여유는 13.2→12.2 mm 로 준다. 가이드·클램프 구멍은 막대 치수를 따른다.

2026-10-24 추가 조정: 3.2절의 D 수는 측면 쌍(FB 또는 RL)을 결합한 채 `ENGAGE LOCK → ENGAGE D` 만 하는데, 50×50 측면 판은 D 층 코너(쓸림 반경 38.65)와 15~75° 전 구간에서 겹쳤다(45° 에서 코너당 589.96 mm³, 4면 모두). 측면 판을 적도 띠 `drive_plate_strip`(16×50, 패드 2, 볼트 (±3.5, ±9))로, 허브 플랜지를 16×32 로 바꿔 D 층 위 1.7 mm 여유를 만들고, 검사기에 **층 회전 ↔ 모듈** 항목(F·R·D 회전을 펌웨어 자세 그대로)을 추가했다. 측면 핀이 E 슬라이스(적도 엣지)를 계속 잡으므로 D 회전 중 코어 정렬을 막대 유격(8/8.4)에만 맡기지 않는다.

## 3. Rev D 운전 절차 (C++/JS 공통)

초기에는 미장착·모든 유닛 후퇴다. LOAD 한 번으로 D 받침을 결합하고,
흰색 U가 아래인 실제 큐브를 놓은 뒤 LOAD로 LOCK·FB를 결합한다.
orient=1을 유지하며 논리 U→물리D, F→B, B→F, R→R, L→L이다.
논리D는 물리 상단이므로 수동 수열에 있으면 실행 전에 전체 거부한다.
풀이기는 크로스15수 IDA*, F2L 매크로, D 없는 OLL/PLL 표를 사용한다.
일반6면으로 섞인 큐브 상태도 처리하되 로봇 자체 섞기는 D를 제외한다.

```
물리 F/B: 새 FB 결합 확인 → D 후퇴 끝 확인 → RL 후퇴 끝 확인 → LOCK 확인 → 회전
물리 R/L: 새 RL 결합 확인 → D 후퇴 끝 확인 → FB 후퇴 끝 확인 → LOCK 확인 → 회전
물리 D: LOCK 확인 → D 결합 확인 → 회전 (측면 쌍은 유지)
```

각 명령 유닛의 두 헤드는 각각 목표 끝 스위치가 닫히고 반대 끝이 열려야 한다.
회전 준비 전후에 전체 끝 상태를 다시 확인한다. 양쪽 중 한 헤드라도 중간 위치이거나
양 끝 동시 눌림이면 회전하지 않는다. 실패한 결합은 서보를 후퇴시키고, 이후 명령에서도
캐시된 상태만 믿지 않고 접점을 읽는다. 실패한 수는 큐브 모델에 적용하지 않는다.
센서 오류 후 복구 동작도 실제 끝 상태를 확인해야 한다.

LOCK은 장착 운전 동안 유지한다. 배출은 D 결합 확인 → LOCK·FB·RL 후퇴 확인 순서다.
`F/FLIP`은 `ERR flip disabled: core not coupled`로 거부하며 저수준 모터 함수도 펄스를 내지 않는다.
가상 모드 Q1에서도 고정 상단 규칙은 같고 구동/접점 대기만 생략한다.

## 4. 핀 배치 (UNO R3/R4 공통, A1 여유)

| 핀 | 신호 | 비고 |
|---|---|---|
| D2 D3 D4 D5 | STEP F, R, B, L | A4988 ×4 |
| D6 | STEP D | 아래 회전, 벨트1:1 |
| D7 | DIR 공용 | 한 번에 한 모터만 회전 |
| D8 / D9 | SERVO FB / RL | 각각2개 같은 신호 |
| D10 / D11 | SERVO D / LOCK | |
| D12 / D13 / A0 | 74HC165 DATA / CLOCK / PL | 2칩 직렬 연결 |
| A1 | 미사용 | 이전 LOCK 센서 배선 제거 |
| A2 / A3 | 버튼 / 부저 | 버튼 내부 풀업 |
| A4 / A5 | LCD I2C | |

74HC165 가까운 칩 D0..D5는 F/B/R/L/D/LOCK 결합,
먼 칩 D0..D5는 같은 순서의 완전 후퇴 스위치다. 각각10kΩ 외부 풀업과 NO→GND를 쓴다.
먼 Q7→가까운 DS, 가까운 Q7→D12, 두 CP→D13, 두 PL→A0, 두 CE→GND다.
먼 DS와 미사용 D6/D7은5V, 각 칩 VCC-GND에는100nF를 둔다.
P13 두 장공은 x37.75/44.25,z137.1/180.9, P29는 x37.75/44.25,z194.1/243.9다.
모든 몸체 중심 x41이며, 머리/링크 최대x33보다 바깥이다.
긴 레버가 안쪽으로8 mm 이상 나와 캐리지에만 닿아야 한다. 반대 끝 접점은 X축 기준180도 뒤집어 접근 방향을 향한다.

A4988 ENABLE은 LOW로 유지한다. 서보6개는 별도5~6V 전원에서 급전하고 GND를 공통으로 한다.
스위치12개·74HC165 두 개의 새 배선 없이 Rev D 펌웨어를 기존 직렬 회로에 연결하지 않는다.

## 5. 시간 추정 (명목, 실측 아님)

| 동작 | 값 |
|---|---|
| 90° 회전 | 50 스텝, 짧은 램프12→9.5 ms, DIR/STEP·정착250 ms 포함 **787.655 ms** |
| 180° 회전 | 100 스텝, 12→8 ms 램프, 정착 포함 **1210.305 ms** |
| 서보 이송 | 1도/4 ms 지령, 전체720 ms + 센서 확인. 충격 완화이며 힘 제한 아님 |
| 뒤집기 | 사용하지 않음, 펄스0 |
| 로봇 시드1 풀이 | 56수, flips=0, regrips=40 (새5면 섞기 기준) |

## 6. 파일

- `tools/build_robot_v4.py`, `check_robot_v4.py`, `render_robot_v4.py` → `models/robot_v4/` (출력 STL/STEP, `robot_assembly.step`, `parameters.json`, `mechanical_checks.json`)
- `node tools/embed_models_v4.js` 는 `models/robot_v4/parameters.json` 과 `models/robot_v4/print/*.stl` 을 `sim/models.js` 에 넣는다
- `firmware/main/mechanism.h/.cpp` (절차·센서·서보), `motors.h/.cpp` (STEP 5 + DIR 공용, 뒤집기), `main.ino` (버튼 짧게/길게, `L`/`E`/`F`/`T` 명령)
- `sim/mechanism.js` (펌웨어와 같은 절차 → 동작 목록), `sim/app.js` (V4 3D), `tools/gen_mechanism_test.js` (Wokwi 실제 모드 시나리오), `tools/gen_wokwi_test.js` (풀이 교차검증 + 뒤집기·결합 횟수)

## 7. CAD 결과 (build_robot_v4.py)

2026-10-24 · CadQuery 2.7.0으로 생성한 CAD 시제품이다. 출력·조립·하중 시험은 아직 수행하지 않았다. 아래 검사는 STEP 솔리드의 이산 자세 표본 검사이며, 연속 궤적·마찰·변형은 후속 검증 대상이다.

`tools/build_robot_v4.py`는 V2 큐브 유지 트랙·직결 헤드와 V3 중공 모듈의 모터·벨트를 재사용한다. 결과는 [models/robot_v4](../models/robot_v4/)에 저장한다. [조립 STEP](../models/robot_v4/robot_assembly.step)과 [GLB](../models/robot_v4/robot_assembly.glb)는 큐브 장착, F/B·D·막대 결합, R/L 24 mm 후퇴 자세이다. 인덱스 휠·잠금핀·승강 벨트는 포함하지 않는다.

출력 부품은 `build_robot_v4.py` 기준 **29종, 89개(소켓 검사편 1개 포함)**이고, 제작 킷(`build_robot_v4_kit.py`: P29 스위치 받침, J01~J03 지그)을 합치면 **33종 93개**다. 모든 출력용 STEP이 유효한 단일 솔리드임을 생성기 assert와 검사기에서 확인했다. [manufacturing.json](../models/robot_v4/manufacturing.json)에 부품별 수량·체적·크기와 구매품 외형 수량을 기록했다. 주요 구매품은 NEMA17 5개, MG996R 6개, 결합/후퇴 스위치 12개, Ø3×16 핀 10개, MGN12/MGN12H 5세트, 608 8개, 6003 2개, 중공축 1개, 6×6×230 강재 막대 1개이다. 구매품 모델은 외형·맞춤 검토용이다.

2절의 CAD 조정을 적용했다. 센터 함몰은 2 mm, 막대(6×6) 끝은 결합 −22.5 / 후퇴 −52.5 mm이며, 지지판 앞모서리는 1.6 mm 모따기이다. U/D 센터는 Ø18.8 판 외곽과 V2 구면 트랙을 유지하는 원형 목에서 8×8 사각 줄기로 이어진다. 6.4 사각 소켓은 깊이 5 로 목 안까지 들어가고, M3 관통공 Ø3.4와 나사 머리 자리 Ø6×깊이 3은 소켓 바닥(−21.5) 아래에 있어 막대 끝과 1.0 mm 축방향 여유를 둔다. D 하우징은 6003 외경 35에 맞춘 Ø35.15 좌대(z 35~45, 48~58), 축 통과공 Ø18.2와 44 mm 폭의 캡을 사용한다. 막대 서보 축은 D 국소 [22, 24, 255]로 두어 D 이송 서보를 피하며, 막대 캐리지 핀 위치 204/234와 행정 30 mm를 유지한다.

측면 구동판은 2.3절의 **적도 띠 `drive_plate_strip`**(16×50×6, 4개)이고 D 구동판만 50×50 `drive_plate_2pin`(1개)이다. 측면 `shaft_hub`는 플랜지 16×32 와 볼트 (±3.5, ±9) 패턴으로 바뀌었고 D 의 `shaft_hub_hollow`는 V3 허브 그대로다. 띠 판의 패드는 적도 엣지 위 2개(`strip_pad_0/1_direct`, 8×4×0.8), D 판은 모서리 4개다.

[mechanical_checks.json](../models/robot_v4/mechanical_checks.json)의 최종 결과는 **`passed: true`, `failure_count: 0`**, 검사기 종료코드 0이다. 겹침 판정 기준은 **0.02 mm³ 초과**이다.

| 검사 | 표본·수치 | 결과 |
|---|---|---|
| 큐브 조립 | 고유 위치 27개, 조각 쌍 351개 | 겹침 0쌍 |
| 층 회전 | X/Y/Z 양쪽 층, 15° 간격 15~90°, 총 36자세 | 겹침 0쌍 |
| **층 회전 ↔ 모듈** (3.2절 자세 그대로) | F 회전(F/B 결합), R 회전(R/L 결합), D 회전(F/B+D 결합, R/L+D 결합), 막대 결합, 15° 간격 15~75°, 총 20자세. 회전 면의 모듈은 층과 함께 돌므로 제외 | 겹침 0쌍 (50×50 측면 판이던 때는 D 회전 4면 모두 코너당 최대 589.96 mm³) |
| 결합 막대 ↔ 큐브 전체 | U/D 센터 소켓 포함 | 겹침 0쌍 |
| 막대 ↔ D 엣지 | 구면 발을 포함한 실제 최소 거리 2.963476 mm; 외측 칸 벽 기준 명목 6.7 mm | 양의 여유 |
| 막대 ↔ 중공축 | D 이송 0/24 mm, 최소 거리 각각 1.757359 / 1.757359 mm (명목 대각 1.757) | 겹침 0쌍 |
| **핀 포착 (면내)** | 명목 3.0 mm. 큐브를 x 로 옮기고 핀 끝을 면 아래 0.1 mm 에 둔 표본 — F: 2.6 mm → 겹침 0쌍 / 3.3 mm → 겹침 2쌍; D: 2.6 mm → 겹침 0쌍 / 3.3 mm → 겹침 2쌍 | 여유 확인 (카운터싱크 안에서만 들어간다) |
| **막대 끝 ↔ 소켓 바닥 (축방향)** | 명목 1.0 mm. 막대를 0.95 mm 더 올리면 겹침 0.0 mm³, 1.05 mm 올리면 겹침 0.817453 mm³ (소켓 바닥 아래 M3 원통머리 Ø5.5×3 외형 포함 — 평면 끝 4×4 의 실제 멈춤면) | 여유 확인 (바닥 위치 일치) |
| 이전 뒤집기 형상 검사(운전 불가) | X축 0~180°, 15° 간격 13자세; F/B·D·막대 후퇴 | 겹침 0쌍 |
| 모듈 간·모듈 ↔ 큐브 | FB 결합 / RL 결합 / 모두 후퇴 3자세 | 겹침 0쌍 |
| 고정 지지부 | 레일 지지판 5개 상호, 막대 유닛 결합/후퇴 | 겹침 0쌍 |
| 크랭크 끝 위치 | θ 0°/180°: 헤드 147/171, 막대 204/234 mm | 최대 오차 0 mm (허용 0.01) |

층 회전에서 사각 줄기로 코어에 결합한 U/D 센터는 고정하고 엣지·코너를 회전시킨다. 모듈 자세 검사는 결합 FB/RL과 함께 D도 결합한 지지 전환 자세를 포함한다. 이전 뒤집기 형상 검사도 보존했지만, 코어 구동을 보장하지 못하므로 Rev D에서는 이 동작을 실행하지 않는다. 키트 검사에는 새 스위치 몸체와 실제 크랭크/링크/캐리지13자세를 포함한90개 그룹이 추가된다.

다음 표는 [parameters.json](../models/robot_v4/parameters.json)의 **전체 `print_offsets`**와 출력 수량이다. 값은 mm이며 소수점 5자리까지 표시했다. 큐브 부품은 V2 큐브 템플릿 좌표, 헤드 부품은 면 국소 좌표, 막대 유닛은 D 국소 좌표이다. STL은 회전 없이 XY 중심·바닥 z=0으로 평행 이동했으므로, `[x중심, y중심, z최소]`를 더하면 원래 조립 좌표가 된다. STEP은 원래 좌표를 유지한다.

| 출력 부품 | 수량 | print_offsets [x중심, y중심, z최소] |
|---|---:|---|
| cube_core | 1 | [0, 0, -17.04553] |
| cube_center | 4 | [0, 0, -28.5] |
| cube_edge | 12 | [0, 16.6, -28.5] |
| cube_corner | 8 | [16.6, 16.6, -28.5] |
| socket_coupon | 1 | [0, 0, 0] |
| center_recessed | 2 | [0, 0, -26.5] |
| shaft_hub | 4 | [0, 0, 11] |
| bearing_housing_direct | 4 | [0, -7.5, 35] |
| carriage_direct | 4 | [0, -12.5, 32] |
| rail_support | 5 | [10.5, -53.25, -0] |
| bearing_front_cap_direct | 4 | [0, 0, 33] |
| bearing_rear_cap_direct | 4 | [0, 0, 52] |
| drive_plate_strip | 4 | [0, 0, 0.8] |
| drive_plate_2pin | 1 | [0, 0, 0.8] |
| servo_mount | 5 | [0, -41.5, 166] |
| servo_clamp | 5 | [20.3, -41.5, 177] |
| crank | 5 | [26, -44, 180] |
| link | 5 | [31, -44, 143] |
| shaft_hub_hollow | 1 | [0, 0, 11] |
| bearing_housing_hollow | 1 | [0, -5, 35] |
| carriage_hollow | 1 | [28, -12.5, 32] |
| bearing_front_cap_hollow | 1 | [0, 0, 33] |
| bearing_rear_cap_hollow | 1 | [0, 0, 58] |
| lock_guide | 1 | [-8, 0, 174] |
| lock_carriage | 1 | [10, 10, 199] |
| lock_servo_mount | 1 | [-5.925, 26.5, 237] |
| lock_servo_clamp | 1 | [20.3, 26.5, 237] |
| lock_crank | 1 | [26, 24, 237] |
| lock_link | 1 | [31, 24, 200] |

조립도와 잠금 막대 단면은 실제 STEP 솔리드를 matplotlib로 렌더링했다. 단면도는 큐브와 D 축 일부를 잘라 사각 소켓에 들어간 막대를 보여 준다.

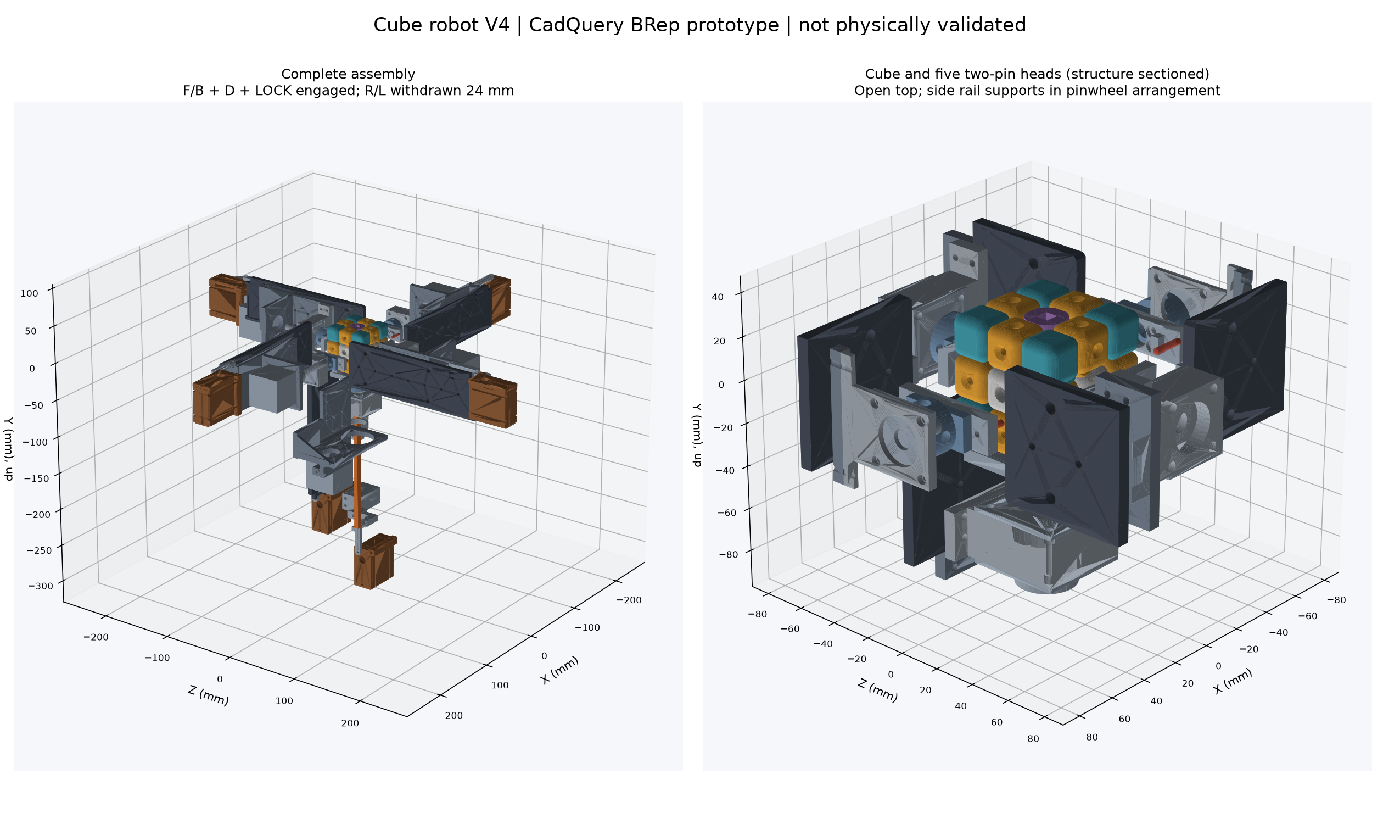
[picture p7: docs/images/robot_v4_assembly.png]
V4 전체 조립과 큐브 주변 확대


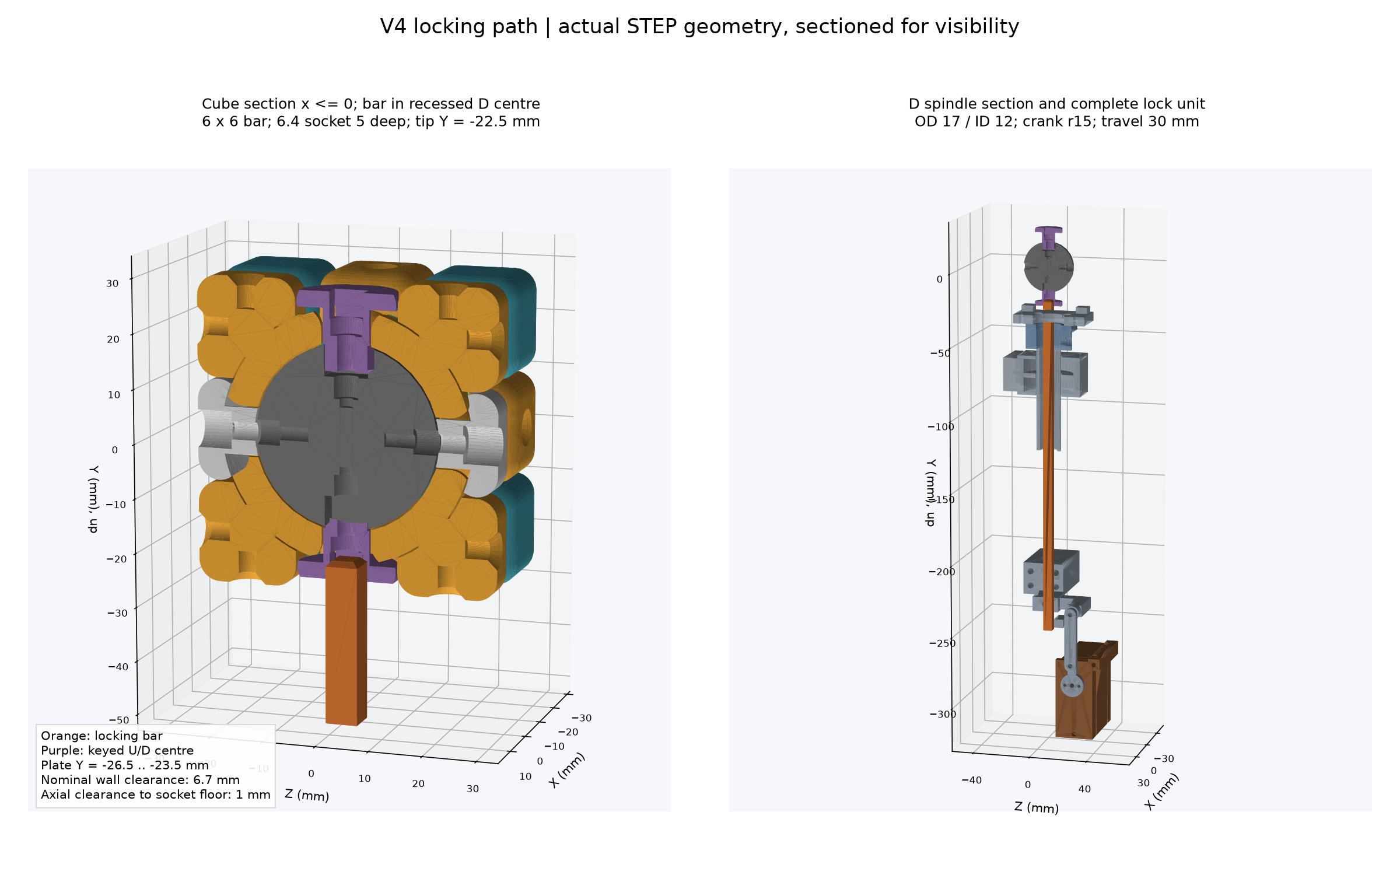
[picture p8: docs/images/robot_v4_lock_bar.png]
V4 센터 소켓과 잠금 막대 단면


재생성 명령(PowerShell, 저장소 루트):

```powershell
& .\.venv-cad\Scripts\python.exe tools/build_robot_v4.py --stl-tolerance 0.1 --stl-angular 0.3
& .\.venv-cad\Scripts\python.exe tools/check_robot_v4.py
& .\.venv-cad\Scripts\python.exe tools/render_robot_v4.py
node tools/embed_models_v4.js
```

의존성은 `tools/requirements-robot-v4.txt`에 기록했다. 기본 build(0.05 mm / 0.12)도 실행한 뒤, 임베드 용량 제한에 맞춰 위 0.1 mm / 0.3으로 재생성했다. `tools/embed_models_v4.js`는 전체 STL이 6 MB를 넘으면 이 허용오차로 자동 재생성·재검사하고, 그래도 크면 지시된 헤드 부품만 넣는다. 이번 결과는 **29종 전체를 포함**, `sim/models.js` **3,116,222바이트(약 3.12 MB)**이며 헤드 전용 축소는 사용하지 않았다. `app.js` 는 측면 헤드에 `drive_plate_strip`, D 헤드에 `drive_plate_2pin` 을 쓴다. 기존 `tools/embed_models.js`는 변경하지 않았다.
