26037-arch/physical_computing_project/docs/images/robot_v3_hollow_head.png

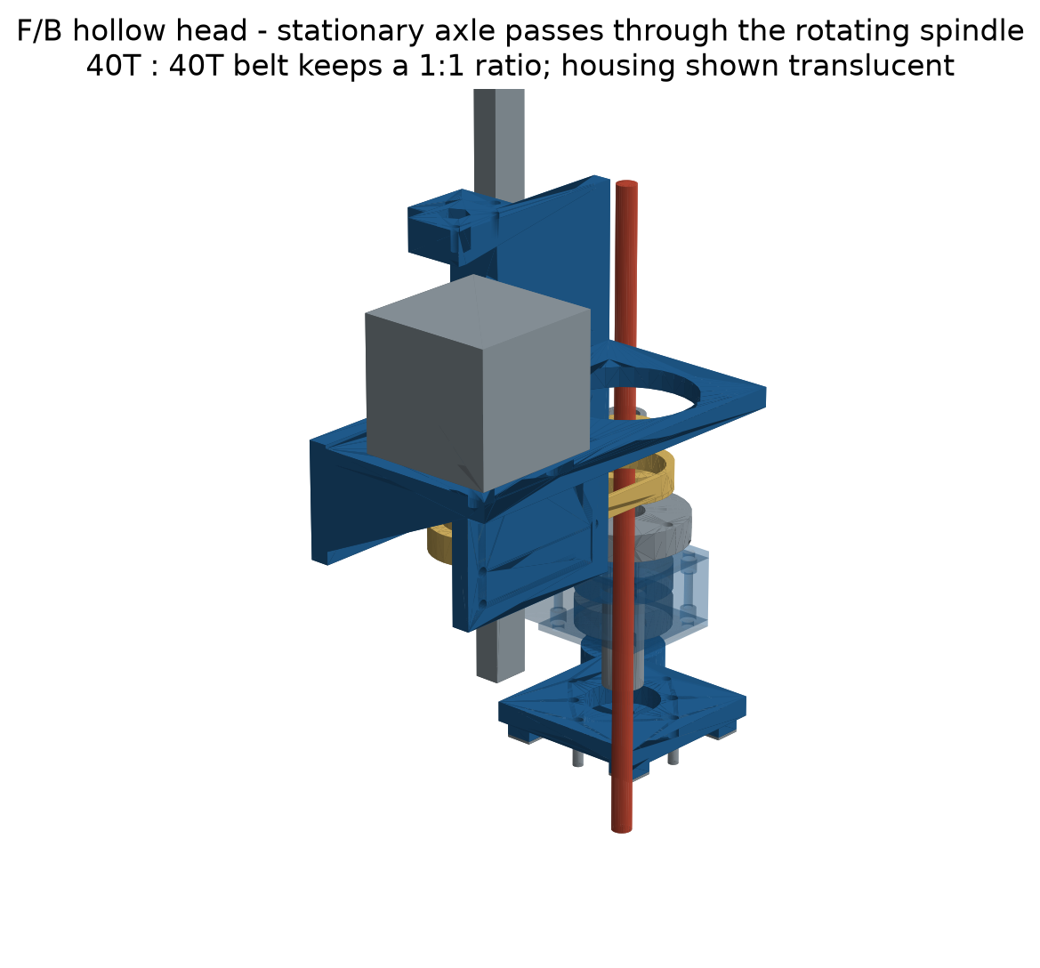
docs/images/robot_v3_hollow_head.png
