26037-arch/physical_computing_project/docs/images/sim_executing.jpg

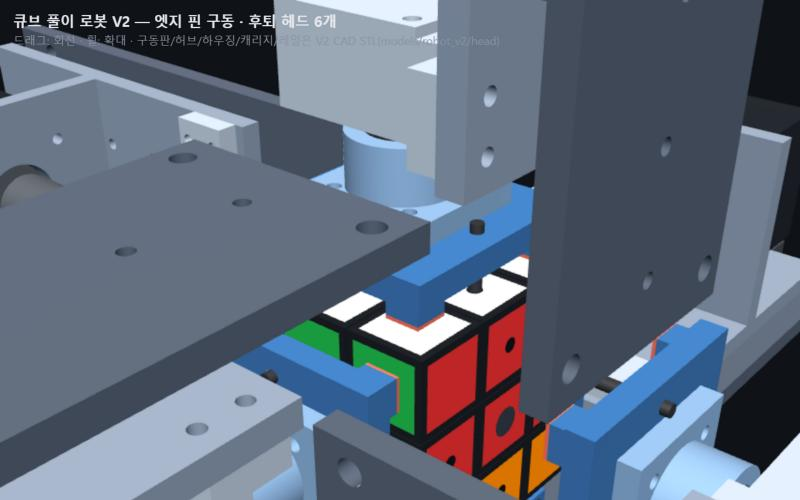
docs/images/sim_executing.jpg
