26037-arch/physical_computing_project/docs/images/sim_robot.jpg

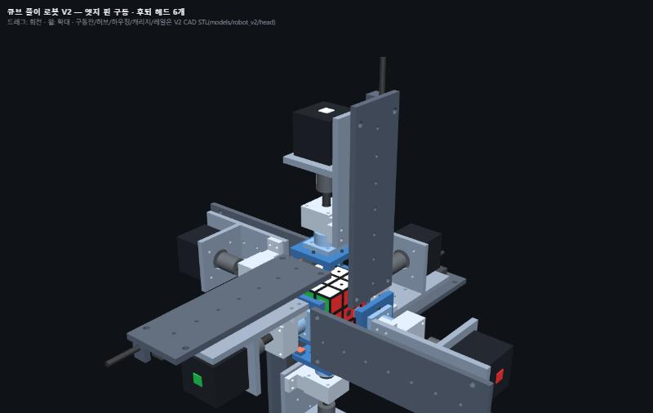
docs/images/sim_robot.jpg
