26037-arch/physical_computing_project/models/robot_v4/assembly_kit/parts_BOM.csv

ID | 품명 | 수량 | 조달 | 파일/설명
P01 | 큐브 코어 | 1 | 3D 출력 | cube_core.stl
P02 | 일반 센터 | 4 | 3D 출력 | cube_center.stl
P03 | U/D 파인 센터 | 2 | 3D 출력 | center_recessed.stl
P04 | 엣지 | 12 | 3D 출력 | cube_edge.stl
P05 | 코너 | 8 | 3D 출력 | cube_corner.stl
P06 | 핀 공차 시험편 | 1 | 3D 출력 | socket_coupon.stl
P07 | D 2핀 구동판 50×50 | 1 | 3D 출력 | drive_plate_2pin.stl
P08 | 측면 허브 | 4 | 3D 출력 | shaft_hub.stl
P09 | 측면 베어링 집 | 4 | 3D 출력 | bearing_housing_direct.stl
P10 | 측면 앞 캡 | 4 | 3D 출력 | bearing_front_cap_direct.stl
P11 | 측면 뒤 캡 | 4 | 3D 출력 | bearing_rear_cap_direct.stl
P12 | 측면 캐리지 | 4 | 3D 출력 | carriage_direct.stl
P13 | 공통 레일 지지대 | 5 | 3D 출력 | rail_support.stl
P14 | 공통 서보 크래들 | 5 | 3D 출력 | servo_mount.stl
P15 | 공통 서보 고정 캡 | 5 | 3D 출력 | servo_clamp.stl
P16 | r12 크랭크 | 5 | 3D 출력 | crank.stl
P17 | 36 mm 링크 | 5 | 3D 출력 | link.stl
P18 | D 중공 허브 | 1 | 3D 출력 | shaft_hub_hollow.stl
P19 | D 베어링 집 | 1 | 3D 출력 | bearing_housing_hollow.stl
P20 | D 앞 캡 | 1 | 3D 출력 | bearing_front_cap_hollow.stl
P21 | D 뒤 캡 | 1 | 3D 출력 | bearing_rear_cap_hollow.stl
P22 | D 캐리지 | 1 | 3D 출력 | carriage_hollow.stl
P23 | 막대 가이드 | 1 | 3D 출력 | lock_guide.stl
P24 | 막대 캐리지 | 1 | 3D 출력 | lock_carriage.stl
P25 | 막대 서보 크래들 | 1 | 3D 출력 | lock_servo_mount.stl
P26 | 막대 서보 고정 캡 | 1 | 3D 출력 | lock_servo_clamp.stl
P27 | r15 크랭크 | 1 | 3D 출력 | lock_crank.stl
P28 | 막대 36 mm 링크 | 1 | 3D 출력 | lock_link.stl
P29 | 막대 스위치 받침 | 1 | 3D 출력 | lock_switch_bracket.stl
P30 | 측면 적도 띠 구동판 16×50 | 4 | 3D 출력 | drive_plate_strip.stl
J01 | 57 mm 정렬 블록 | 1 | 3D 출력 | alignment_cube.stl
J02 | 사각축 공차 시험편 | 1 | 3D 출력 | square_fit_coupon.stl
J03 | 9.8 mm 핀 깊이 지그 | 1 | 3D 출력 | pin_depth_gauge.stl
B01 | NEMA17 1.8° 모터 | 5 | 구매 | 몸체42.3×42.3×40 이하, 축Ø5/돌출20, 홀 피치31. 5개 동일 규격.
B02 | MG996R 서보 + 금속 25T 원형 혼 | 6 | 구매 | 몸체42.9×19.7×40.7 외형 기준. 실측·180° 실제 이동 확인. 사진의 소형 서보로 대체하지 않음.
B03 | A4988 모듈 + 방열판 | 5 | 구매 | 사진의 스텝모터 드라이버와 별개. VMOT 12V, VDD5V, 모터 정격 전류에 맞는 제품.
B04 | Arduino UNO R3 또는 R4 WiFi | 1 | 구매 | 사진에서 보드 자체의 포함 여부를 확인할 수 없어 구매로 분류. 이미 보유하면 재사용.
B05 | MGN12 180 + MGN12H 블록 | 5세트 | 구매 | 블록20×20 M3 장착 홀, 설치 총높이13. 첫 홀 오프셋10 또는15/피치25를 도면과 대조; P13 장공으로 수용.
B06 | 강철 다월핀 Ø3×16, 끝 90° 원뿔 | 10 | 구매 | 2개/헤드. 실제 지름을 먼저 측정. 앞 돌출9.8(원뿔 끝 Ø1 포함), 판 두께6, 뒤 돌출0.2. 90° 원뿔(Ø3→Ø1, 높이1) 가공 완료품10개를 동일 규격으로 구매한다. 없으면 업체에 가공을 의뢰하고 지그 없는 손 연삭으로 끝 길이를 맞추지 않는다.
B07 | 정밀 강재축 Ø8×67 | 4 | 구매 | 베어링 맞춤부 h6 권장. 허브·커플링 세트스크류 접점 평면 가공, 베어링 자리는 가공하지 않음.
B08 | 중공 정밀축 OD17 / ID12.5 ×82 | 1 | 구매 | OD17 h6, 내경12.5(+0.05/0) 시작 요구. 동심도·곧음≤0.05 목표. 제작업체 도면 확인.
B09 | 강재 사각 막대6×6×230 | 1 | 구매 | 실측6.00±0.03 목표, 휨≤0.10/230 목표. 선단1 mm 모따기. 결합 끝 y=-22.5로 고정(소켓 바닥 -21.5까지 축방향 여유1.0).
B10 | 608 베어링 8×22×7 | 8 | 구매 | 측면 2개/헤드. 실드/실링 제품의 실제 회전 저항 확인.
B11 | 6003 베어링17×35×10 | 2 | 구매 | D 전용. 6001과 혼용하지 않음.
B12 | F8-16M 추력 베어링8×16×5 | 8 | 구매 | 측면 앞/뒤 1개씩. 축방향 반력용이며 608을 과도하게 예압하지 않음.
B13 | D 추력 유닛17×30×총5 | 2세트 | 구매 | AXK1730 2T + AS1730 1T 2장 + 1T 정밀 시임의 적층 예. 실제 공급 도면·총두께를 확인. 51103 9T는 그대로 맞지 않음.
B14 | 분할 축 고정 링 Ø8 / OD≤16 / 7T | 4 | 구매 | 금속 클램프 링, 축방향 조절 가능. 세트스크류 단독 링보다 분할형 권장.
B15 | 분할 축 고정 링 Ø17 / OD≤28 / 8T | 1 | 구매 | D 뒤 추력 베어링-풀리 사이. 지정 두께 초과품은 재설계 필요.
B16 | 5→8 클램프 커플링 Ø≤19×25 | 4 | 구매 | 양쪽 삽입 길이 및 축끝 사이 1 mm 여유 확인.
B17 | GT2 40T 풀리2 + 200-2GT-6 벨트1 | 1세트 | 구매 | 모터 보어5, 종동 보어17. 풀리OD≤28, 전체길이≤18, 허브OD≤20. 종동17 보어는 가공품 가능.
B18 | 레버 마이크로스위치 | 12 | 구매 | 몸체12.8×6.5×5.8, 홀 피치6.5, 안쪽으로8 mm 이상 나오는 긴 레버. COM-NO 사용, 장공으로 작동 위치 조절. 스위치의 실제 레버는 CAD 외형에 없음.
B19 | 12V 모터 전원 + 6V 서보 전원 | 각1 | 구매 | 초기 후보12V 10A/6V 10A. 모터·서보 정격과 동시 피크 전류/발열 측정 후 확정. 인증된 외장 DC 전원 사용.
B21 | 74HC165 입력 회로 | 2칩 | 구매 | 5V 74HC165 두 개, 10kΩ 풀업12개, 100nF 바이패스2개, 만능기판. 사진의 74HC595는 출력용으로 대체 불가.
B22 | 키 맞춤용 저수축 충전 에폭시·이형 필름 | 1세트 | 구매 | 실제 강재 막대를 원형으로 삼는 맞춤층. 10~20 µm 이형 필름, 재료 호환성·수축·경화 조건을 제조사 자료와 시험편으로 확인. 미경화 충전이나 접착력만으로 고정하지 않음.
B20 | 나사·너트·인서트·전원 부속 | 1묶음 | 구매 | 별도 체결표 F01~F25 참조. Rev B에서 F17/F18은 삭제. 핀·스프링·실리콘 패드·스위치 배선도 누락하지 않음.
K01 | LCD1602 + I2C 모듈 | 1 | 사진 키트 | 사진의 LCD1602 with IIC. 전압5V·주소를 확인.
K02 | TACT 버튼 | 1 | 사진 키트 | 사진의 택트 스위치. 눌림으로 연결되는 접점을 테스터로 확인.
K03 | 부저 | 1 | 사진 키트 | 사진의 부저. 능동/수동과 전류를 확인; 핀 정격을 넘으면 트랜지스터 구동 필요.
K04 | 점퍼선 | 필요량 | 사진 키트 | 사진의 점퍼와 F-M 케이블. 신호선에 사용; 모터·서보 주전원 배선은 별도 구매.
M01 | 합판 패널 | 5 | 구매 후 가공 | 바닥621×621×18, F/B 597×450×12, R/L 621×450×12. 각2개, DXF 1:1.
M02 | 2060 알루미늄 프로파일 | 5 | 구매 후 가공 | 측면268 mm 4개 + D301.5 mm 1개. 앞끝 국소z=2, 뒤끝270/303.5. 단면 슬롯·코어 도면 확인.
M03 | 금속 L앵글40×40×40, 3T | 16 | 구매 후 가공 | 수직 모서리8 + 바닥8. 홀 중심은 면당20, Ø4.5. 각 앵글은 두 면 체결.
M04 | 알루미늄 잠금 지지판6T | 1 | 구매 후 가공 | 124×126×6, DXF. D2060 측면 슬롯에 M5 두 개로 체결. 가이드·서보·스위치 받침을 여기에 고정.
