26037-arch/physical_computing_project/models/robot_v5/robot_assembly.step

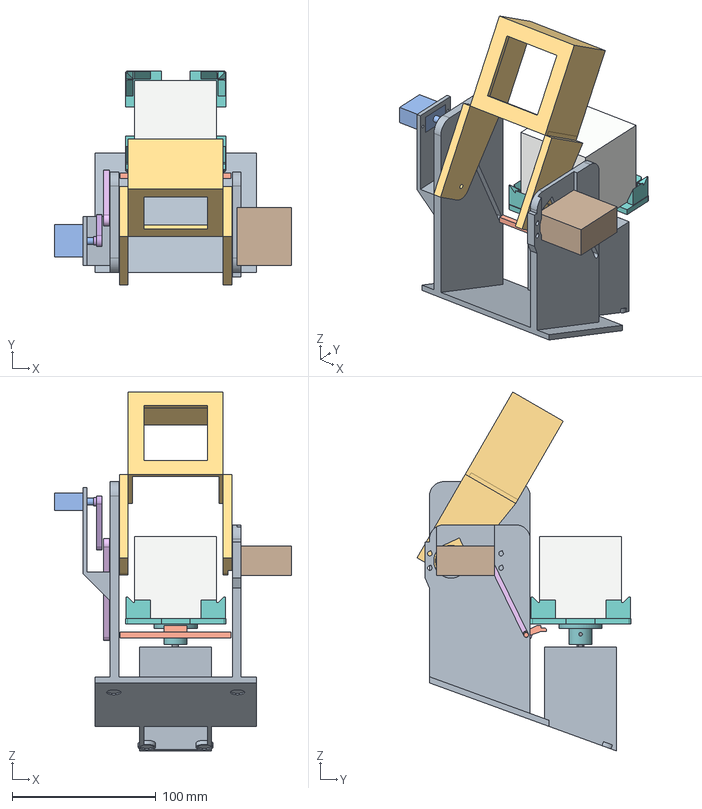
[picture p16: CAD file, 2026-10-24]
models/robot_v5/robot_assembly.step
164.7 x 148.6 x 249.4 mm
base
cube_holder
hub
hood
lifter
crank
link
nema17
mg996r
sg90
