26037-arch/physical_computing_project/models/robot_v5/robot_assembly_close.step

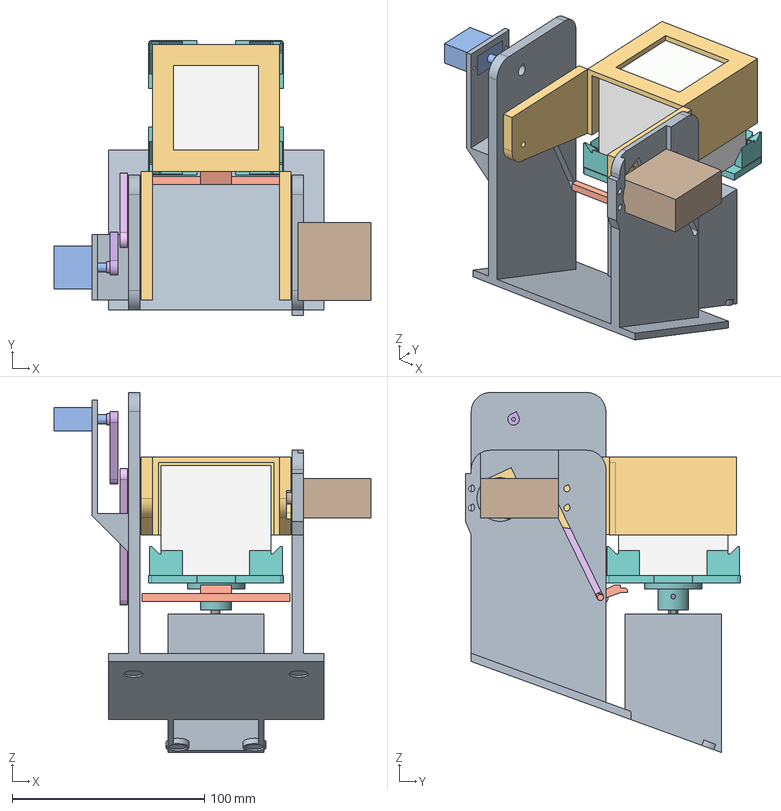
[picture p17: CAD file, 2026-10-24]
models/robot_v5/robot_assembly_close.step
164.7 x 143.0 x 187.1 mm
base
cube_holder
hub
hood
lifter
crank
link
nema17
mg996r
sg90
