26037-arch/physical_computing_project/models/robot_v5/robot_assembly_flip.step

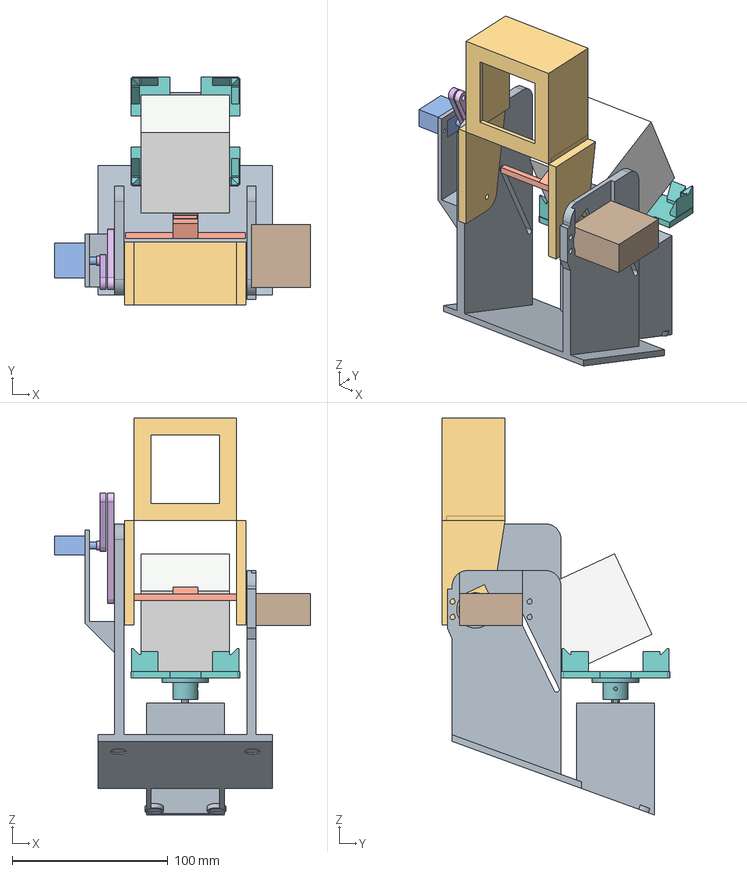
[picture p18: CAD file, 2026-10-24]
models/robot_v5/robot_assembly_flip.step
164.7 x 146.5 x 255.1 mm
base
cube_holder
hub
hood
lifter
crank
link
nema17
mg996r
sg90
