26037-arch/physical_computing_project/models/center_coupler.stl

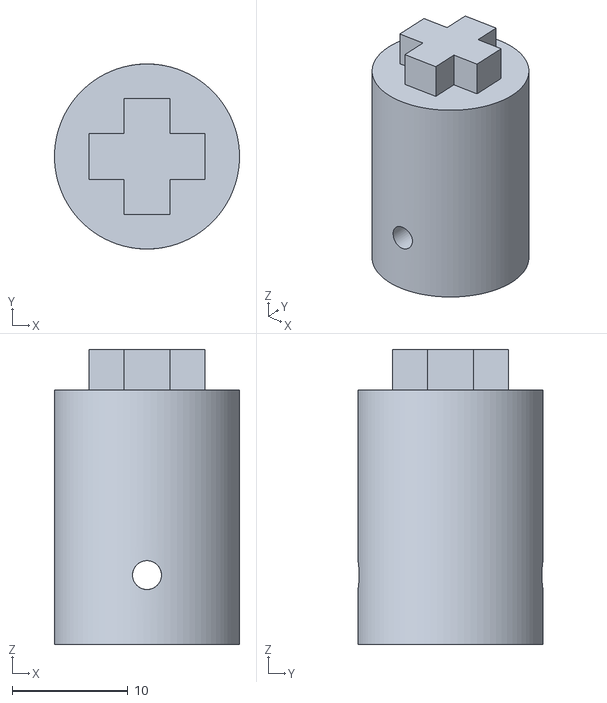
[picture p19: CAD file, 2026-10-23]
models/center_coupler.stl
16.0 x 16.0 x 25.5
