26037-arch/physical_computing_project/models/robot_v5/print/cube_holder.step

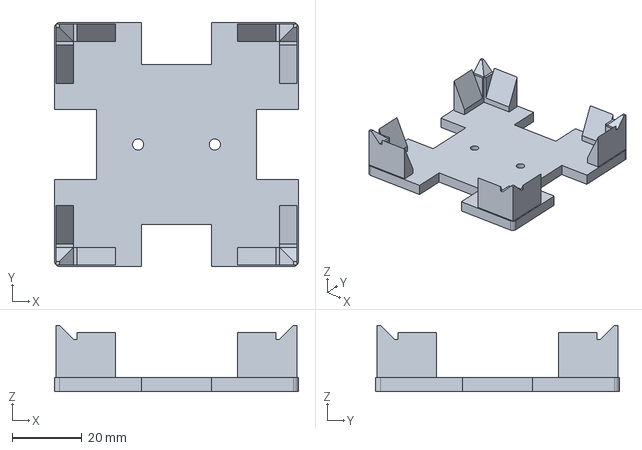
[picture p20: CAD file, 2026-10-24]
models/robot_v5/print/cube_holder.step
70.0 x 70.0 x 19.0 mm
