26037-arch/physical_computing_project/models/motor_mount.stl

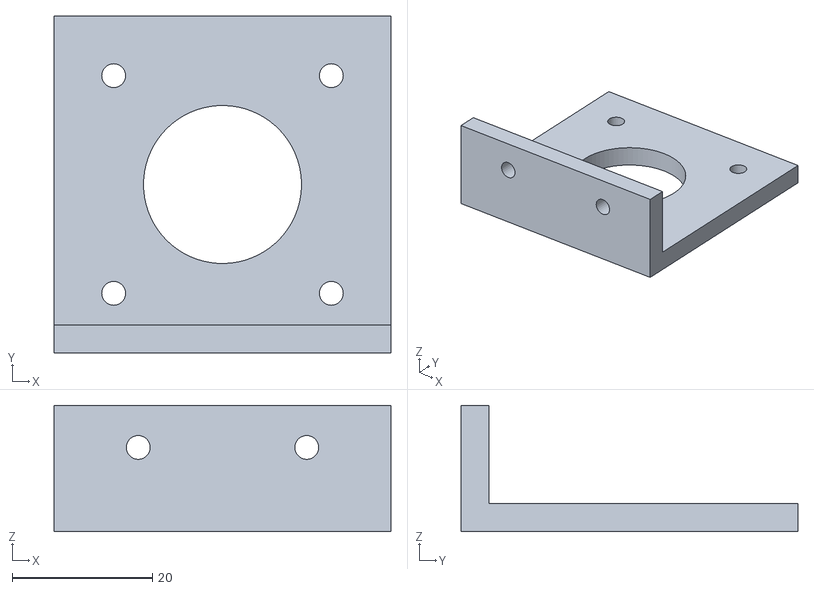
[picture p21: CAD file, 2026-10-23]
models/motor_mount.stl
48.0 x 48.0 x 18.0
