26037-arch/physical_computing_project/models/robot_v5/print/base.step

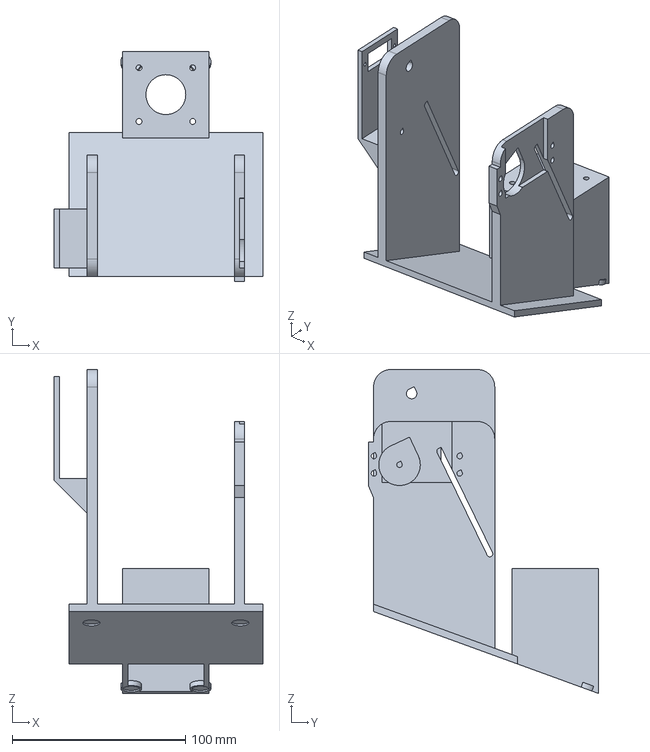
[picture p22: CAD file, 2026-10-24]
models/robot_v5/print/base.step
120.5 x 133.0 x 187.1 mm
