26037-arch/physical_computing_project/models/center_cap.stl

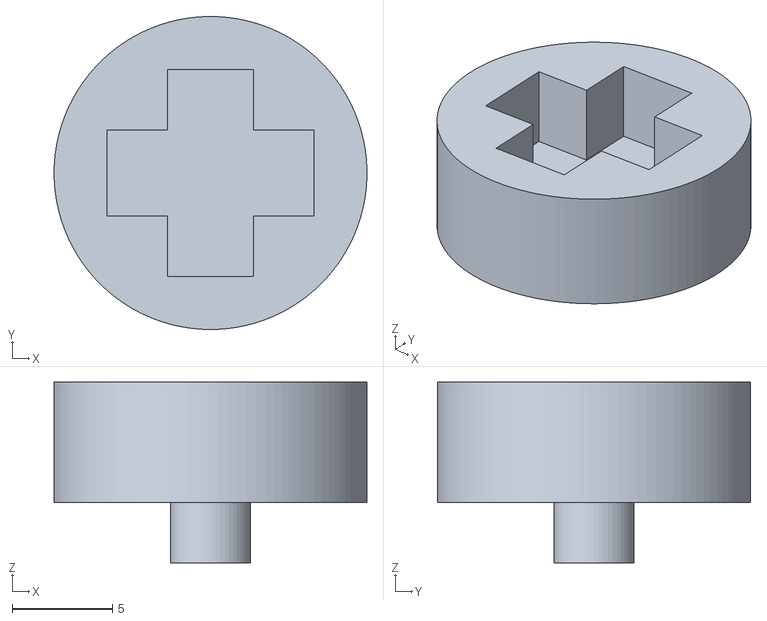
[picture p23: CAD file, 2026-10-23]
models/center_cap.stl
15.6 x 15.6 x 9.00
