26037-arch/physical_computing_project/models/robot_v5/print/lifter.step

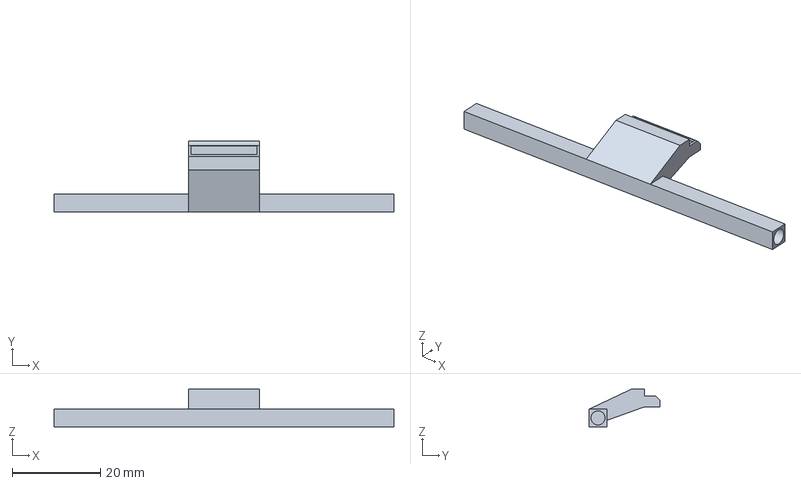
[picture p24: CAD file, 2026-10-24]
models/robot_v5/print/lifter.step
77.0 x 16.0 x 8.50 mm
