26037-arch/physical_computing_project/models/robot_v5/print/link.step

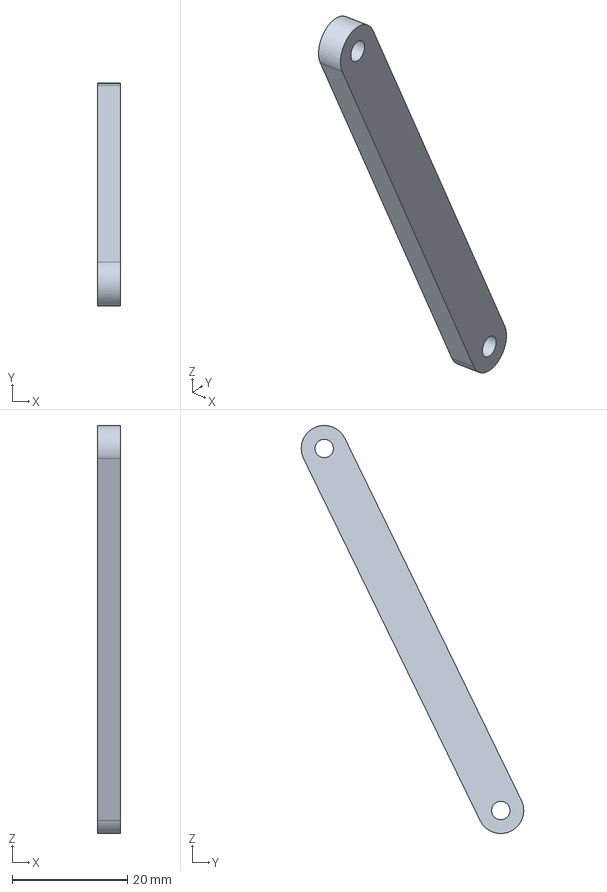
[picture p25: CAD file, 2026-10-24]
models/robot_v5/print/link.step
4.00 x 38.7 x 70.9 mm
