26037-arch/physical_computing_project/models/robot_v5/print/hub.step

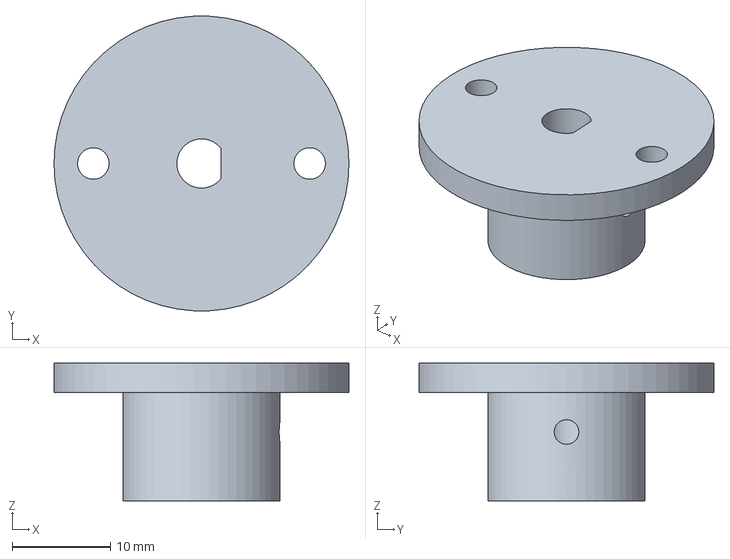
[picture p26: CAD file, 2026-10-24]
models/robot_v5/print/hub.step
30.0 x 30.0 x 14.0 mm
