26037-arch/physical_computing_project/models/robot_v5/print/hood.step

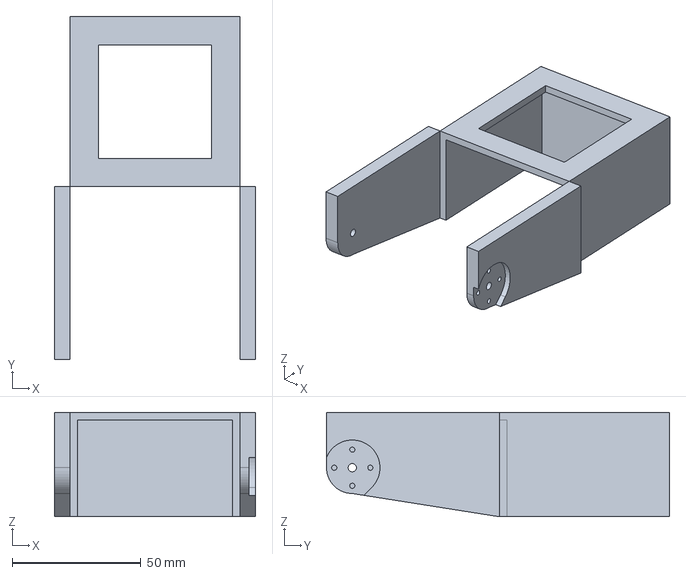
[picture p27: CAD file, 2026-10-24]
models/robot_v5/print/hood.step
78.0 x 133.0 x 40.5 mm
