26037-arch/physical_computing_project/models/robot_v5/print/crank.step

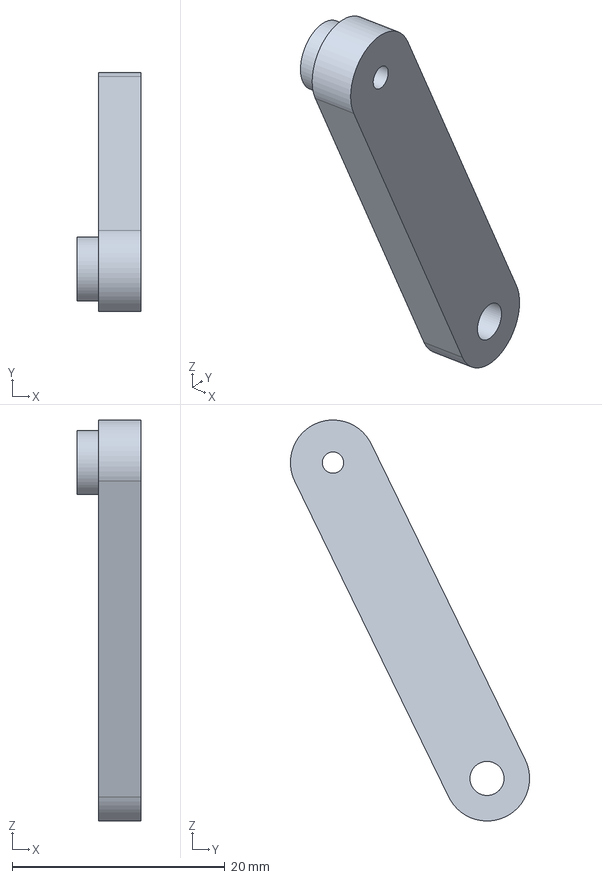
[picture p28: CAD file, 2026-10-24]
models/robot_v5/print/crank.step
6.00 x 22.5 x 37.7 mm
