26037-arch/physical_computing_project/models/robot_v4/robot_assembly.step

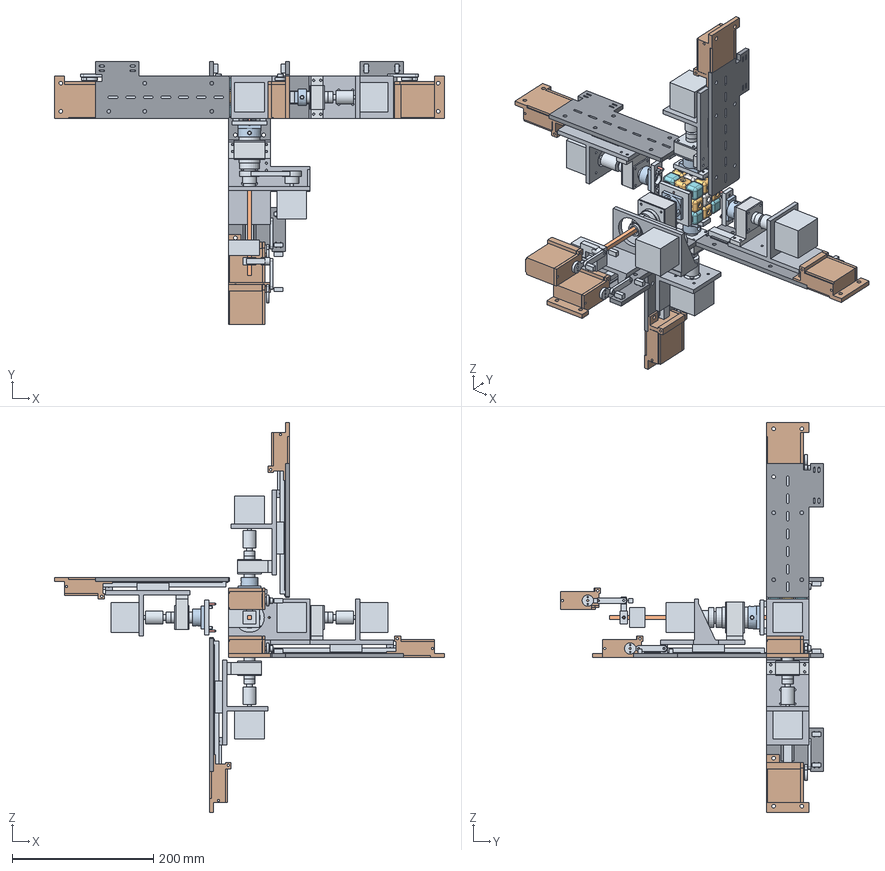
[picture p31: CAD file, 2026-10-24, an earlier design]
models/robot_v4/robot_assembly.step
553.0 x 373.5 x 553.0 mm
cube__core
cube__corner_00
cube__corner_01
cube__corner_02
cube__corner_03
cube__corner_04
cube__corner_05
cube__corner_06
cube__corner_07
cube__edge_00
cube__edge_01
cube__edge_02
cube__edge_03
cube__edge_04
cube__edge_05
cube__edge_06
cube__edge_07
cube__edge_08
cube__edge_09
cube__edge_10
cube__edge_11
cube__center_00
cube__center_01
cube__center_02
cube__center_03
cube__center_04
cube__center_05
F__shaft_hub
F__bearing_housing
F__carriage
F__rail_support
F__bearing_front_cap
F__bearing_rear_cap
F__drive_plate_strip
F__servo_mount
F__servo_clamp
F__crank
F__link
F__spindle_8mm
F__bearing_608_0
F__bearing_608_1
F__thrust_F8_16M
F__coupling_5x8
F__motor_NEMA17
F__motor_shaft
F__rail_MGN12
F__block_MGN12H
F__pin_0
F__pin_1
F__strip_pad_0
F__strip_pad_1
F__servo_MG996R
F__servo_output
F__engage_switch
F__retract_switch
F__rear_thrust_F8_16M
F__shaft_collar_8
R__shaft_hub
R__bearing_housing
R__carriage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
