26037-arch/physical_computing_project/models/robot_v2/robot_assembly.step

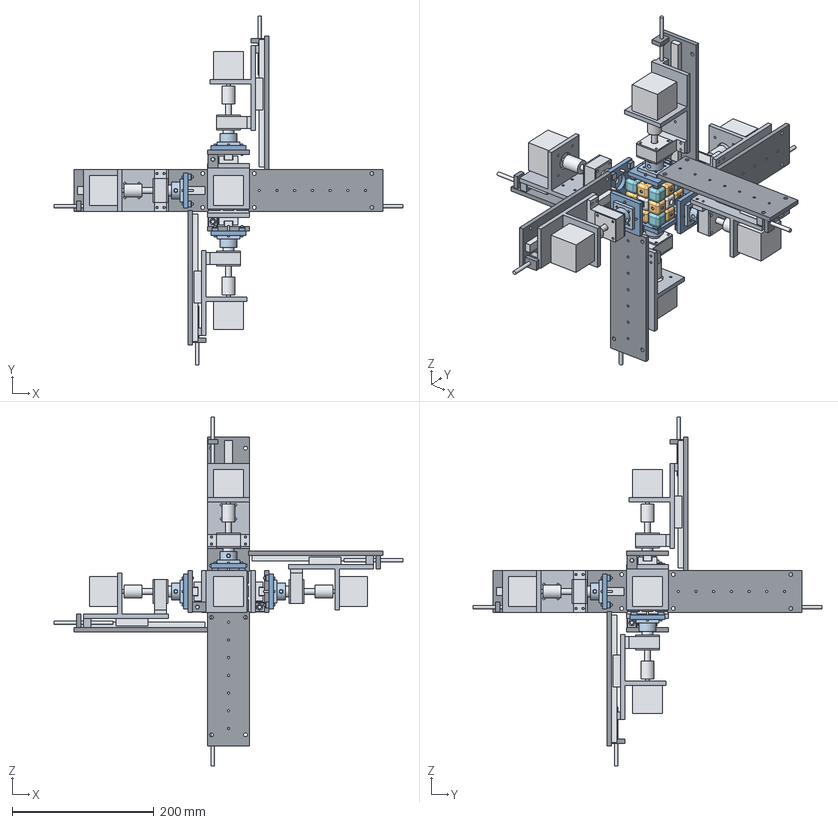
[picture p32: CAD file, 2026-10-23, an earlier design]
models/robot_v2/robot_assembly.step
493.0 x 493.0 x 493.0 mm
core
corner_00
corner_01
corner_02
corner_03
corner_04
corner_05
corner_06
corner_07
edge_00
edge_01
edge_02
edge_03
edge_04
edge_05
edge_06
edge_07
edge_08
edge_09
edge_10
edge_11
center_00
center_01
center_02
center_03
center_04
center_05
drive_plate x 6
shaft_hub x 6
bearing_housing x 6
carriage x 6
rail_support x 6
bearing_front_cap x 6
bearing_rear_cap x 6
spindle_8mm x 6
pin_0 x 6
pin_1 x 6
pin_2 x 6
pin_3 x 6
axial_pad_0 x 6
axial_pad_1 x 6
axial_pad_2 x 6
axial_pad_3 x 6
bearing_608_0 x 6
bearing_608_1 x 6
thrust_F8_16M x 6
coupling_5x8 x 6
motor_NEMA17 x 6
motor_shaft x 6
rail_MGN12 x 6
block_MGN12H x 6
feed_screw_M5 x 6
