26037-arch/physical_computing_project/models/robot_v2/cube/cube_corner.step

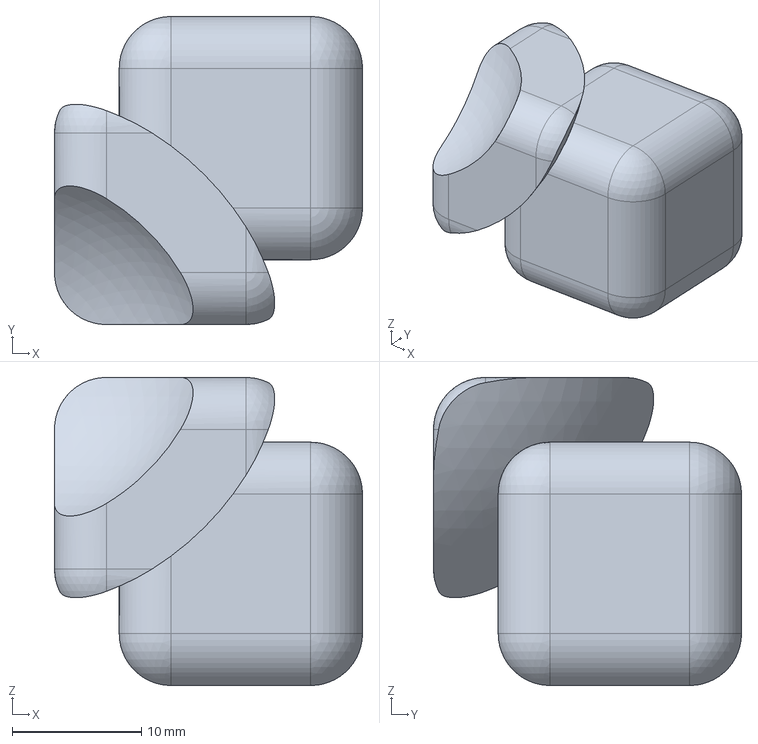
[picture p33: CAD file, 2026-10-23, an earlier design]
models/robot_v2/cube/cube_corner.step
23.8 x 23.8 x 23.8 mm
