26037-arch/physical_computing_project/(list of files, cad)

Other CAD files:
models/CubeRobotParts.f3d
models/robot_v2/cube/cube_center.step
models/robot_v2/cube/cube_center.stl
models/robot_v2/cube/cube_core.step
models/robot_v2/cube/cube_core.stl
models/robot_v2/cube/cube_corner.stl
models/robot_v2/cube/cube_edge.step
models/robot_v2/cube/cube_edge.stl
models/robot_v2/cube/socket_coupon.step
models/robot_v2/cube/socket_coupon.stl
models/robot_v2/head/bearing_front_cap.step
models/robot_v2/head/bearing_front_cap.stl
models/robot_v2/head/bearing_housing.step
models/robot_v2/head/bearing_housing.stl
models/robot_v2/head/bearing_rear_cap.step
models/robot_v2/head/bearing_rear_cap.stl
models/robot_v2/head/carriage.step
models/robot_v2/head/carriage.stl
models/robot_v2/head/drive_plate.step
models/robot_v2/head/drive_plate.stl
models/robot_v2/head/rail_support.step
models/robot_v2/head/rail_support.stl
models/robot_v2/head/shaft_hub.step
models/robot_v2/head/shaft_hub.stl
models/robot_v2/one_face_module.step
models/robot_v2/printable_cube.step
models/robot_v3/cube_with_fixed_axle.step
models/robot_v3/module_direct.step
models/robot_v3/module_hollow.step
models/robot_v3/print/axle_coupon.step
models/robot_v3/print/axle_coupon.stl
models/robot_v3/print/bearing_front_cap_direct.step
models/robot_v3/print/bearing_front_cap_direct.stl
models/robot_v3/print/bearing_front_cap_hollow.step
models/robot_v3/print/bearing_front_cap_hollow.stl
models/robot_v3/print/bearing_housing_direct.step
models/robot_v3/print/bearing_housing_direct.stl
models/robot_v3/print/bearing_housing_hollow.step
models/robot_v3/print/bearing_housing_hollow.stl
models/robot_v3/print/bearing_rear_cap_direct.step
models/robot_v3/print/bearing_rear_cap_direct.stl
models/robot_v3/print/bearing_rear_cap_hollow.step
models/robot_v3/print/bearing_rear_cap_hollow.stl
models/robot_v3/print/carriage_direct.step
models/robot_v3/print/carriage_direct.stl
models/robot_v3/print/carriage_hollow.step
models/robot_v3/print/carriage_hollow.stl
models/robot_v3/print/center_axle.step
models/robot_v3/print/center_axle.stl
models/robot_v3/print/center_standard.step
models/robot_v3/print/center_standard.stl
models/robot_v3/print/core_left.step
models/robot_v3/print/core_left.stl
models/robot_v3/print/core_right.step
models/robot_v3/print/core_right.stl
models/robot_v3/print/cube_corner.step
models/robot_v3/print/cube_corner.stl
models/robot_v3/print/cube_edge.step
models/robot_v3/print/cube_edge.stl
models/robot_v3/print/drive_plate.step
models/robot_v3/print/drive_plate.stl
models/robot_v3/print/index_pin_bracket_direct.step
models/robot_v3/print/index_pin_bracket_direct.stl
models/robot_v3/print/index_pin_bracket_hollow.step
models/robot_v3/print/index_pin_bracket_hollow.stl
models/robot_v3/print/nut_cover.step
models/robot_v3/print/nut_cover.stl
models/robot_v3/print/rail_support.step
models/robot_v3/print/rail_support.stl
models/robot_v3/print/shaft_hub_direct.step
models/robot_v3/print/shaft_hub_direct.stl
models/robot_v3/print/shaft_hub_hollow.step
models/robot_v3/print/shaft_hub_hollow.stl
models/robot_v3/print/socket_coupon.step
models/robot_v3/print/socket_coupon.stl
models/robot_v3/purchase_and_cut/SHF6_envelope_B.step
models/robot_v3/purchase_and_cut/SHF6_envelope_F.step
models/robot_v3/purchase_and_cut/SHF8_envelope_B.step
models/robot_v3/purchase_and_cut/SHF8_envelope_F.step
models/robot_v3/purchase_and_cut/core_flat_shim_0_1.step
models/robot_v3/purchase_and_cut/corner_bracket_0_-1_-1_-180.step
models/robot_v3/purchase_and_cut/corner_bracket_0_-1_-1_180.step
models/robot_v3/purchase_and_cut/corner_bracket_0_-1_1_-180.step
models/robot_v3/purchase_and_cut/corner_bracket_0_-1_1_180.step
models/robot_v3/purchase_and_cut/corner_bracket_0_1_-1_-180.step
models/robot_v3/purchase_and_cut/corner_bracket_0_1_-1_180.step
models/robot_v3/purchase_and_cut/corner_bracket_0_1_1_-180.step
models/robot_v3/purchase_and_cut/corner_bracket_0_1_1_180.step
models/robot_v3/purchase_and_cut/corner_bracket_1_-1_-1_-180.step
models/robot_v3/purchase_and_cut/corner_bracket_1_-1_-1_180.step
models/robot_v3/purchase_and_cut/corner_bracket_1_-1_1_-180.step
models/robot_v3/purchase_and_cut/corner_bracket_1_-1_1_180.step
models/robot_v3/purchase_and_cut/corner_bracket_1_1_-1_-180.step
models/robot_v3/purchase_and_cut/corner_bracket_1_1_-1_180.step
models/robot_v3/purchase_and_cut/corner_bracket_1_1_1_-180.step
models/robot_v3/purchase_and_cut/corner_bracket_1_1_1_180.step
models/robot_v3/purchase_and_cut/corner_bracket_2_-1_-1_-180.step
models/robot_v3/purchase_and_cut/corner_bracket_2_-1_-1_180.step
models/robot_v3/purchase_and_cut/corner_bracket_2_-1_1_-180.step
models/robot_v3/purchase_and_cut/corner_bracket_2_-1_1_180.step
models/robot_v3/purchase_and_cut/corner_bracket_2_1_-1_-180.step
models/robot_v3/purchase_and_cut/corner_bracket_2_1_-1_180.step
models/robot_v3/purchase_and_cut/corner_bracket_2_1_1_-180.step
models/robot_v3/purchase_and_cut/corner_bracket_2_1_1_180.step
models/robot_v3/purchase_and_cut/fixed_axle_D6_L620.step
models/robot_v3/purchase_and_cut/fixed_axle_D8_L620.step
models/robot_v3/purchase_and_cut/index_wheel_bore12.step
models/robot_v3/purchase_and_cut/index_wheel_bore8.step
models/robot_v3/purchase_and_cut/panel_B.dxf
models/robot_v3/purchase_and_cut/panel_B.step
models/robot_v3/purchase_and_cut/panel_D.dxf
models/robot_v3/purchase_and_cut/panel_D.step
models/robot_v3/purchase_and_cut/panel_F.dxf
models/robot_v3/purchase_and_cut/panel_F.step
models/robot_v3/purchase_and_cut/panel_L.dxf
models/robot_v3/purchase_and_cut/panel_L.step
models/robot_v3/purchase_and_cut/panel_R.dxf
models/robot_v3/purchase_and_cut/panel_R.step
models/robot_v3/purchase_and_cut/panel_U.dxf
models/robot_v3/purchase_and_cut/panel_U.step
models/robot_v3/purchase_and_cut/profile_B.step
models/robot_v3/purchase_and_cut/profile_D.step
models/robot_v3/purchase_and_cut/profile_F.step
models/robot_v3/purchase_and_cut/profile_L.step
models/robot_v3/purchase_and_cut/profile_R.step
models/robot_v3/purchase_and_cut/profile_U.step
models/robot_v3/purchase_and_cut/profile_end_plate.dxf
models/robot_v3/purchase_and_cut/profile_end_plate_B.step
models/robot_v3/purchase_and_cut/profile_end_plate_D.step
models/robot_v3/purchase_and_cut/profile_end_plate_F.step
models/robot_v3/purchase_and_cut/profile_end_plate_L.step
models/robot_v3/purchase_and_cut/profile_end_plate_R.step
models/robot_v3/purchase_and_cut/profile_end_plate_U.step
models/robot_v3/purchase_and_cut/shaft_bridge.dxf
models/robot_v3/purchase_and_cut/shaft_bridge_B.step
models/robot_v3/purchase_and_cut/shaft_bridge_F.step
models/robot_v4/assembly_kit/cut/base_angle_B_-200.step
models/robot_v4/assembly_kit/cut/base_angle_B_200.step
models/robot_v4/assembly_kit/cut/base_angle_F_-200.step
models/robot_v4/assembly_kit/cut/base_angle_F_200.step
models/robot_v4/assembly_kit/cut/base_angle_L_-200.step
models/robot_v4/assembly_kit/cut/base_angle_L_200.step
models/robot_v4/assembly_kit/cut/base_angle_R_-200.step
models/robot_v4/assembly_kit/cut/base_angle_R_200.step
models/robot_v4/assembly_kit/cut/corner_-1_-1_-250.step
models/robot_v4/assembly_kit/cut/corner_-1_-1_60.step
models/robot_v4/assembly_kit/cut/corner_-1_1_-250.step
models/robot_v4/assembly_kit/cut/corner_-1_1_60.step
models/robot_v4/assembly_kit/cut/corner_1_-1_-250.step
models/robot_v4/assembly_kit/cut/corner_1_-1_60.step
models/robot_v4/assembly_kit/cut/corner_1_1_-250.step
models/robot_v4/assembly_kit/cut/corner_1_1_60.step
models/robot_v4/assembly_kit/cut/lock_spine.dxf
models/robot_v4/assembly_kit/cut/lock_spine.step
models/robot_v4/assembly_kit/cut/panel_B.dxf
models/robot_v4/assembly_kit/cut/panel_B.step
models/robot_v4/assembly_kit/cut/panel_F.dxf
models/robot_v4/assembly_kit/cut/panel_F.step
models/robot_v4/assembly_kit/cut/panel_L.dxf
models/robot_v4/assembly_kit/cut/panel_L.step
models/robot_v4/assembly_kit/cut/panel_R.dxf
models/robot_v4/assembly_kit/cut/panel_R.step
models/robot_v4/assembly_kit/cut/panel_base.dxf
models/robot_v4/assembly_kit/cut/panel_base.step
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
