26037-arch/physical_computing_project/docs/BUILD_V4_MERGE_REVIEW.md

# V4 커밋 비교와 Rev C 병합 판단

현재 제작 기준은 **Rev C**다. 원격 `83ade39`의 구동부 수정과
`a7f8bcd`의 조립 단순화를 함께 적용한다. 두 부모의 기능을 유지하고 CAD,
시뮬레이터, 부품표, 조립 PDF와 배포 ZIP을 같은 기준으로 다시 생성한다.

## 비교한 커밋

| 커밋 | 장점 | 한계·이번 처리 |
|---|---|---|
| `b37de3e` V4 Draft | 측면4헤드+D중공헤드+승강 잠금, 위로 큐브 장착, 서보 크랭크24/30 mm | 제작 프레임·체결 세부가 부족하다. 운동 구조의 원형으로 유지한다. |
| `e8af35a` / `5136470` | F2L 트리거 매크로 탐색과 CAD/시뮬레이터 좌표 정리 | 기계 조립 문제를 해결하는 변경은 아니다. 최신 풀이기와 기구 제어를 그대로 유지한다. |
| `29bf89c` / `d8c21f4` Rev A | 공통 프레임, 금속 앵글·지지판, 서보 크래들, 축 양방향 지지, 번호별 제작 PDF | 전산봉20본/간격관20본의 길이 맞춤이 필요하다. 기존 검사는 회전 층과 결합된 주변 헤드 사이 검사가 부족했다. |
| `4f5b1be` / `83ade39` 원격 최신 | 측면 띠 판·좁은 허브로 D층 회전 공간 확보,6 mm 막대·깊은 소켓, 원뿔 핀/카운터싱크, 실제 운전 자세의 층 회전 검사 추가 | 작은 막대의 강성·사각 유격, 핀 가공 규격의 부담이 생긴다. 조립 고정부는 전산봉 방식을 사용한다. |
| `a7f8bcd` Rev B | 공통3점 프로파일 직결, 레일 턱/장공, 위치 결정 돌기, 짧은 인서트 나사. 길이 맞춤40본과 패널 홀20개 제거 | 기존50×50 측면 판/8 mm 막대를 계승한다. 주변 헤드와 D층 회전의 동시 간섭은 기존 검사 범위에서 빠져 있었다. |
| Rev C 통합판 | 최신 구동부와 Rev B 고정부를 결합한다. 서보축·행정·제어 절차와 프레임 크기를 유지한다. | 실물 강도·마찰·반복 정밀도는 별도 시험이 필요하다. 이전8 mm 부품과 혼용하지 않는다. |

`claude/keen-edison-r8wmi4`의 끝은 `e8af35a`이며 원격 master의 조상이다.
그 브랜치에만 있는 새 커밋은 없어 별도 중복 병합하지 않는다.

## 구조별 장단점과 채택 이유

| 항목 | 이점 | 비용·주의점 | 판단 |
|---|---|---|---|
| 측면 P30 16×50 띠 판과 전용 허브 | D층을 돌릴 때 결합된 측면 판을 피한다. 띠 높이±8과 D층 상단−9.7 사이 명목 여유1.7 mm | 패드가 측면당4→2개로 줄고 판이 좁아져 접촉압력·국부 휨을 확인해야 한다. | 채택. D 전용 P07 50×50은 유지한다. |
| 6×6 막대/6.4 소켓 | 소켓 깊이5, 실제 삽입4, 바닥·M3머리 여유1 mm. 중공축 안 대각 여유0.59→2.01 mm | 같은 재질·길이에서 비틀림 강성은8 mm 막대의31.6%, 같은 토크의 탄성 비틀림은약3.16배다. 사각 결합의 한 방향 명목 각도 여유도약2.94→3.96°로 증가한다. | 공간 확보를 위해 채택. 강성이나 정밀도가 개선된 것으로 표현하지 않는다. |
| 원뿔 끝 핀+Ø7 입구 | 진입 초기 기하 포획 범위가 면내3 mm다. 작게 어긋난 위치에서 입구를 찾기 쉽게 한다. | Ø3→Ø1/높이1의 가공 핀10개가 필요하다. 원통 결합부가2 mm이고 마찰·코어 구속 때문에 자동 정렬이 보장되지는 않는다. | 가공 완료 구매품을 우선한다. 지그 없는 수공 연삭을 조립 단계에 넣지 않는다. |
| P14 프로파일3점 직결 | 전산봉20/간격관20의 절단·평행도 맞춤 제거. 해당 연결 낱개 수120→45. 공통 받침5개 사용 | 넓은 면 슬롯−20/0/+20을 갖춘2060과 맞는 T너트가 필요하다. PETG 크리프·체결면 들뜸을 실물 확인해야 한다. | Rev B 유지. 핀·서보축 위치를 바꾸지 않는다. |
| P13 턱·장공·포켓 | 레일을 기준 턱에 놓고 받침 돌기를 포켓에 넣어 위치를 잡는다. 첫 홀 오프셋10/15 차이를 장공으로 수용한다. | 출력 버·수축이 턱/포켓을 막을 수 있다. 억지 끼움 대신 실제 간극을 확인한다. | Rev B 유지. 레일만0.5 mm 앞당겨 몸체와0.45 명목 여유 확보. |
| 중앙 슬롯 M3 T너트 | 레일을 위에서 조이며 뒤쪽 일반 너트를 잡을 필요가 없다. | 끝삽입 너트는 프로파일 끝을 패널로 막기 전에 넣어야 한다. | Rev B 유지. PDF에 삽입 순서를 기록한다. |
| P23/P29 인서트+짧은 나사 | M4×60/M3×80과 반대편 너트를 없애고 금속판 뒤에서 조립한다. | 인서트 열삽입·뽑힘 품질이 중요하다. P29 팔은8T로 보강한다. | Rev B 유지. 도피공으로 나사 끝의 플라스틱 간섭을 피한다. |

각도 유격은 `a(cosθ+sinθ)=소켓 폭`의 명목 계산이다. 원뿔 입구의 포획 폭은
진입 가능성이고, 최종 각도 반복 오차와 같은 값이 아니다. <0.5°는 실측 목표다.

## 병합 시 유지한 경계

- 구동부는 원격의 P30/좁은 허브·6 mm 막대·원뿔 핀을 쓴다. P07은D에만1개,
  P30은측면에4개다. 소켓 깊이6, 핀 삽입4.8, J03 두께9.8을 함께 적용한다.
- 코어와 U/D 센터 사이의8×8 키는 잠금 막대와 다른 부위다. 그 키를6 mm로
  줄이지 않는다. 막대 가이드6.3, 막대 캐리지6.1, J02 6.2/6.3/6.4는 새 막대용이다.
- 깊어진 머리 자리에 맞춰 U/D 센터 나사는 M3×10을 채택한다.
  머리 받침면18.5에서 인서트 입구11까지7.5를 지나2.5 mm 물린다.
  기존 M3×14는 막힌 파일럿 끝5.5를 지나므로 사용하지 않는다. 회전 반력은
  8×8 키가 받고 나사는 센터를 축방향으로 유지한다. 일반 센터 M3×16은 그대로다.
- 서보 받침과 레일 지지대는 Rev B의 실제 맞댐 면·키·M5 세 체결점을 유지한다.
  측면과 D가 같은 P14를 쓰며 잠금 서보 P25는 M04 체결을 유지한다.
- 풀이기/기구 제어 JS와 C++ 및 행정 상수는 원격 최신과 동일하다. 화면에서는
  최신 구동부를 유지하고 Rev B 출력 오프셋과 레일 위치만 결합한다.
- STEP/STL·내장 모델·PNG·PDF·CSV·ZIP은 소스 충돌 선택으로 끝내지 않고
  통합 CAD에서 다시 생성한다. 같은 파일명의 이전 판을 섞지 않는다.

## 제작 파일과 검증

현재 부품은33종93개(시험편/지그 포함), 첫 장 번호61개다. P01~P28 및P30은
본체89개, P29는1개, J01~J03은3개다. M3 인서트69/M4 인서트14이며
F17/F18은수량0, F11은32세트, F25는5세트다. 패드 수는 측면8개+D4개=12개다.

전체 검사에서는 기존 큐브36회전·뒤집기13자세·모듈3자세에 더해
F/R/D층 회전20자세를 결합된 주변 헤드와 비교한다. 새 원뿔 핀 포획 샘플과
잠금 막대/실제 M3머리 외형의 축방향 여유도 검사한다. 고정부는47개 검사 그룹에
맞댐 면·M5머리/와셔·MGN 블록·인서트 뒤 나사 끝과 U/D 센터 나사를 포함한다.

`models/robot_v4/assembly_kit/merge_comparison_checks.json`에는 구형50×50 측면
판과 새 띠 판을 같은 D층 코너45° 자세에 대입한 비교를 기록한다. 이 표본에서
구형 판은589.96 mm³가 겹쳤고 통합판은0이었다. 이는 한 자세의 비교이며
전체 동작에 대한 보증은 아니다. 전체 결과는
`mechanical_checks.json`, `kit_checks.json`, `mesh_checks.json`, `pdf_checks.json`을
확인한다. 배포 ZIP은 SHA256 목록으로 실제 포함 파일의 일치를 검증한다.

최종 검사 결과: 본체 실패0(큐브36/뒤집기13/주변 헤드와 층 회전20/핀 포획4/
모듈3자세), 고정부47그룹 실패0, 출력33종93개 메시 통과다. U/D M3×10은
양쪽 모두 간섭0이며, 기존 M3×14는 코어와각10.308 mm³가 겹쳐 배제했다.
시뮬레이터에 내장한29개 STL과 파라미터는 최종 CAD와 바이트가 일치한다.
PDF는41쪽·첫 장61개 번호이며 글꼴/텍스트 경계와 부품표를 함께 검사한다.

실물 시험은 아직 하지 않았다. 한 모듈부터 출력해 무부하 이송20회, 핀/막대
재진입, 같은 토크에서 코어의 각변위,6면 회전, 왕복 뒤집기20회를 순서대로
시험한다. 뒤집기에서 가운데 층이 마찰로 따라오는 가정은 계속 남아 있다.
실물에서 미끄러짐·층 지연·인서트 들뜸이 생기면 자동 풀이 운전을 승인하지 않는다.

## 기준 커밋 링크

- [원격 통합83ade39](https://github.com/26037-arch/physical_computing_project/commit/83ade39d35a54d3a644a2fec932033650a53e135)
- [구동부 변경4f5b1be](https://github.com/26037-arch/physical_computing_project/commit/4f5b1be)
- [조립 단순화a7f8bcd](https://github.com/26037-arch/physical_computing_project/commit/a7f8bcda80fd8b64063d54728814765ee6178da7)
- [이전 통합d8c21f4](https://github.com/26037-arch/physical_computing_project/commit/d8c21f49c8be001da35f6dc10457c168cfa5b99a)
