26037-arch/physical_computing_project/docs/BUILD_V5.md

# V5 하루 제작 설명서 — 기울어진 컵 + 후드 + 리프터 큐브 로봇

기준: `docs/HARDWARE_V5.md`(치수·절차 계약), `models/robot_v5/`(STL·STEP·검사 결과), 2026-10-24.
이 문서는 **아침에 출력을 걸고 저녁에 시연 리허설까지** 가는 순서다. 상세 치수는 설명서에 베끼지 않고 CAD 파일을 기준으로 한다.

## 0. 준비물

### 키트에서 꺼내는 것
| 번호 | 품목 | 수량 | 비고 |
|---|---|---|---|
| K01 | Arduino UNO (R3 또는 R4 WiFi) | 1 | 펌웨어는 둘 다 컴파일된다 (R3 는 플래시 96 %) |
| K02 | LCD1602 + I2C 모듈 | 1 | 주소 0x27 |
| K03 | 택트 스위치 | 1 | 버튼 하나로 섞기/풀기(짧게)·장착(길게) |
| K04 | 부저 | 1 | |
| K05 | **SG90(또는 MG90S) 9 g 서보** | 1 | 리프터. 토크 요구 0.33 kg·cm |
| K06 | 점퍼선, 브레드보드 | — | 신호선만. 모터·서보 전원은 브레드보드를 거치지 않는다 |
| K07 | **시중 3×3 큐브 56~57.5 mm** | 1 | 윤활된 스피드큐브가 좋다 (층 회전 토크 ≤ 0.3 N·m) |

### 사는 것 (3종)
| 번호 | 품목 | 수량 | 규격 |
|---|---|---|---|
| B01 | NEMA17 스텝모터 | 1 | 42×42×40 이하, 축 Ø5 D컷, 1.8°, 0.4 N·m 급 (1.5 A) |
| B02 | A4988 드라이버 + 방열판 | 1 | VMOT 12 V, Vref 0.6 A 로 설정 |
| B03 | MG996R 서보 + 원형 금속/플라스틱 혼(Ø21, 25T) | 1 | 후드. 180° 이동 확인 |
| B04 | 12 V 2 A 어댑터 + DC 잭, 5 V 2 A USB 어댑터 | 각 1 | 모터 / 서보 전원 (보드는 USB) |
| B05 | 100 µF 전해 커패시터 | 1 | A4988 VMOT–GND |

### 나사·소모품 (나사 21개 + 고무발·패드)
| 용도 | 규격 | 수량 |
|---|---|---|
| 모터 → 베이스 윗판 | M3×8 | 4 |
| 허브 → 홀더 판 밑 | M3×8 (히트셋 인서트 2 또는 셀프탭) | 2 |
| 홀더 멈춤나사 | M3×6 (무두 또는 접시) | 1 |
| MG996R → 오른쪽 타워 | M3×16 + 너트 | 4 |
| 혼 → 후드 허브 | M2×8 (서보 동봉) | 4 |
| 후드 피벗 (왼쪽) | M3×25 + 너트 | 1 |
| 리프터 슬롯 핀 | M3×20 + 너트 (몸통만 슬롯을 지남) | 2 |
| 링크 → 크랭크 | M3×12 + 너트 | 1 |
| SG90 → 왼쪽 타워 | M2×8 (동봉) | 2 |
| 고무발 | Ø10 접착식 | 4 |
| 선반 패드 | 실리콘 시트 0.5 mm (또는 자전거 튜브 조각) 16×4 | 1 |

공구: 육각 2/2.5 mm, 십자 드라이버, 캘리퍼스, 니퍼, 납땜(선택), 멀티미터.

## 1. 아침 — 출력 (프린터 1대 기준 8~12 h, 2대면 반나절)

| 파일 (`models/robot_v5/print/`) | 수량 | 베드에 놓는 면 | 설정 |
|---|---|---|---|
| `base.stl` | 1 | 뒤 데크 바닥(월드 수평면) | PETG/PLA, 0.2 mm, 벽 3줄, 충전 20 %, 서포트 없음 |
| `hood.stl` | 1 | 지붕 (뒤집어서) | 팔은 수직으로 선다 |
| `cube_holder.stl` | 1 | 판 아랫면 (기둥이 위) | 기둥 모따기는 오버행 45° 이내 |
| `hub.stl` | 1 | 플랜지 면 | D 구멍은 그대로 출력 |
| `lifter.stl` | 1 | 크로스바 쪽 평면 | |
| `crank.stl`, `link.stl` | 각 1 | 넓은 면 | |

출력 순서: `cube_holder`·`hub` → `lifter`·`crank`·`link` → `hood` → `base`. 홀더가 먼저 나오면 큐브를 끼워 **기둥 여유(1.0 mm)**와 큐브 손회전을 바로 확인한다.
질량 합계와 예상 시간은 `models/robot_v5/manufacturing.json`(HARDWARE_V5.md 8절)을 따른다.

## 2. 출력 중 — 배선과 펌웨어 (1 h)

```
UNO D2 ─ A4988 STEP        UNO D8 ─ MG996R 신호 (후드)
UNO D7 ─ A4988 DIR         UNO D9 ─ SG90 신호 (리프터)
UNO D6 ─ A4988 ENABLE      UNO A2 ─ 버튼 ─ GND (내부 풀업)
A4988 RESET ─ SLEEP        UNO A3 ─ 부저 ─ GND
A4988 VDD ─ 5 V, GND ─ GND UNO A4/A5 ─ LCD SDA/SCL, LCD VCC 5 V
A4988 VMOT ─ 12 V (+100 µF) 서보 V+ ─ 5 V USB 어댑터 (+), GND 공통
A4988 1A/1B/2A/2B ─ NEMA17 한 코일씩 (저항 2 옴 안팎인 두 선이 한 코일)
```
1. 모터 없이 먼저 보드만 USB 로 연결 → `powershell -ExecutionPolicy Bypass -File v5/scripts/build.ps1` → `v5/scripts/upload.ps1 -Port COMx`.
2. 시리얼 115200: `Q 1` → `S 1` → `V` 가 `SOLVED ok=1` 로 끝나면 풀이기는 정상 (가상 모드).
3. A4988 Vref: 전원을 넣고 모터 없이 전위차계 중심에서 GND 까지 **0.48 V**(= 0.6 A × 0.8, A4988 Rs 0.1 옴 기준) 로 맞춘다.
4. 모터 연결 후 `Q 0` → `Y 1`: 컵 모터가 위에서 봐서 시계로 90° 돌면 정상, 반대면 `motors.h` 의 `CW_LEVEL` 을 뒤집는다. (아직 장착 전이라 `ERR not loaded` 가 나오면 `L` 두 번으로 가상 장착하거나 `Q 1`.)
5. 서보 두 개는 연결하자마자 후드 75°, 리프터 0° 로 간다. **혼을 끼우기 전**에 이 자세를 기준으로 혼 각을 맞춘다 (후드: 혼이 힌지 아래쪽 15° 방향, 리프터: 크랭크가 슬롯 아래 사점).

## 3. 조립 (30 분)

1. **모터 → 베이스**: 베이스 윗판 Ø23 구멍에 모터 보스를 넣고 M3×8 ×4. 케이블은 뒤 데크 쪽으로.
2. **허브 → 홀더 → 축**: 허브 플랜지를 홀더 판 밑 중앙에 M3×8 ×2 로 붙인다(노치 방향과 무관). 허브 D 구멍을 축 D컷에 맞춰 끝까지 끼운다(판 아랫면 z −4 가 모터 앞면 위 21 mm). 멈춤나사 M3×6 을 D 평면에 조인다. 홀더의 **노치 하나가 정확히 뒤(타워 쪽)를 향하게** 축을 돌려 두고, 그 상태에서 전원을 켠다(스텝모터는 전원이 켜진 뒤 그 자리를 기준으로 90° 단위로만 돈다).
3. **후드 서보**: MG996R 을 오른쪽 타워 바깥 포켓에 M3×16 ×4. 서보 출력축이 타워 Ø8 구멍 중앙(힌지)에 온다.
4. **후드 걸기**: 후드는 뒷벽이 없는 ㄷ자(앞벽 + 옆벽 2 + 지붕 테두리)다. 원형 혼을 후드 오른쪽 허브 포켓에 M2 ×4 로 먼저 체결 → 후드를 타워 사이로 넣어 혼을 서보 스플라인에 끼운다 (서보가 75° 인 상태에서 후드가 60° 열린 자세가 되도록 스플라인 위치를 고른다) → 왼쪽은 M3×25 를 타워 밖에서 허브까지 넣고 너트.
5. **리프터**: 리프터를 타워 사이 아래에서 넣어 크로스바(폭 77, 타워 안쪽에 딱 들어감) 양끝 구멍과 타워 슬롯을 맞추고 M3×20 ×2 를 밖에서 끼워 너트(느슨하게, 슬라이더가 손으로 가볍게 오르내려야 한다). 선반 윗면에 실리콘 패드를 붙인다.
6. **리프터 서보**: SG90 을 왼쪽 타워 바깥 위쪽 포켓(힌지 위·뒤, 국소 (−83, 81))에 M2 ×2. 크랭크를 혼에 끼우고(서보 0° = 크랭크가 슬롯 쪽 사점, 슬라이더 최하), 링크(70)를 크랭크 끝과 왼쪽 슬롯 볼트에 M3×12 로 연결. 서보 180° 에서 슬라이더가 최상(66 mm)에 닿는다.
7. 고무발 4개. 전체를 책상에 놓으면 홀더 바닥이 뒤로 20° 기운다.

## 4. 조정 (1 h) — 시리얼 명령으로 숫자를 찾고 `mechanism.h` 기본값에 적는다

| 순서 | 명령 | 맞추는 것 | 합격 |
|---|---|---|---|
| 1 | `L` | 후드 LOAD(135°): 후드가 뒤로 젖혀 위가 비는가 | 큐브를 위에서 넣을 수 있다. 큐브를 **풀린 상태로, 흰색 아래·초록 앞**으로 넣는다 |
| 2 | `L` | 후드 OPEN(75°): 큐브·기둥에 닿지 않는가 | 큐브를 손으로 돌려도 후드에 안 닿는다 |
| 3 | `H 15 75 135` | CLOSE(15°): 벽이 위 두 층을 감싸고 아래 층(판 위 19 mm)·기둥(15)엔 안 닿는가 | 닿으면 CLOSE 각을 2° 씩 올린다 (후드가 덜 내려옴) |
| 4 | `M D` / `M D'` / `M D2` | 층이 90° 에 정렬되는가 | 덜 돌면 `O 3`, 지나치면 `O 1` (오버슈트 스텝) |
| 5 | `Y 1`, `Y 3` | 큐브 전체가 따라 도는가(위 두 층이 뒤처지지 않는가) | 뒤처지면 `motors.h` `MIN_US` 를 올린다(느리게) |
| 6 | `F` | 뒤집기: 앞 모서리가 판 위를 미끄러져 뒤 기둥에 닿고 65° 에서 넘어져 자리에 떨어지는가 | 안 넘어가면 `K 180` 그대로 두고 선반 패드 마찰을 올린다(튜브 고무). 넘어진 뒤 자리를 벗어나면 홀더 노치 방향·기울기(책상 수평)를 확인 |
| 7 | `M R U R' U'` ×6 | 6번 반복해 원상태로 돌아오는가 | 돌아오면 층 정렬·뒤집기가 모두 믿을 만하다 |

## 5. 시연 리허설

`R`(모델 리셋, 큐브는 풀린 상태로 장착) → 버튼 짧게(섞기 20수, 약 1 분) → 버튼 짧게(풀기: 계산 수 초 + 실행 약 3 분) → LCD `SOLVED!`.
5회 연속 성공하면 끝. 실패 유형과 대처: 층 어긋남 → 4단계 오버슈트, 뒤집기 실패 → 6단계, 큐브가 기둥에 걸려 스핀 안 됨 → 큐브 윤활·기둥 안쪽 사포.

## 6. 관중에게 보이는 것
큐브는 책상 위 약 75 mm, 앞·좌·우 면 전부와 후드 구멍으로 윗면이 보인다. 타워·서보·배선은 뒤쪽. 시연대는 관중이 **앞에서 약간 위**를 보도록 놓고, LCD 는 베이스 앞에 세운다. 시뮬레이터(`node tools/serve.js` → `http://localhost:8765/v5/sim/`)를 옆 화면에 띄우면 같은 명령·같은 로그가 3D 로 함께 움직인다.

## 7. 안전
12 V 는 A4988 VMOT 에만. 서보 전원은 보드 5 V 핀이 아니라 USB 어댑터에서. 전원을 끄면 컵이 자유롭게 돌 수 있으니 켜기 전에 노치 방향(2 단계)을 다시 확인한다. 큐브가 넘어가는 동안 손을 넣지 않는다.
