26037-arch/physical_computing_project/docs/images/v5_manual/page_02.png

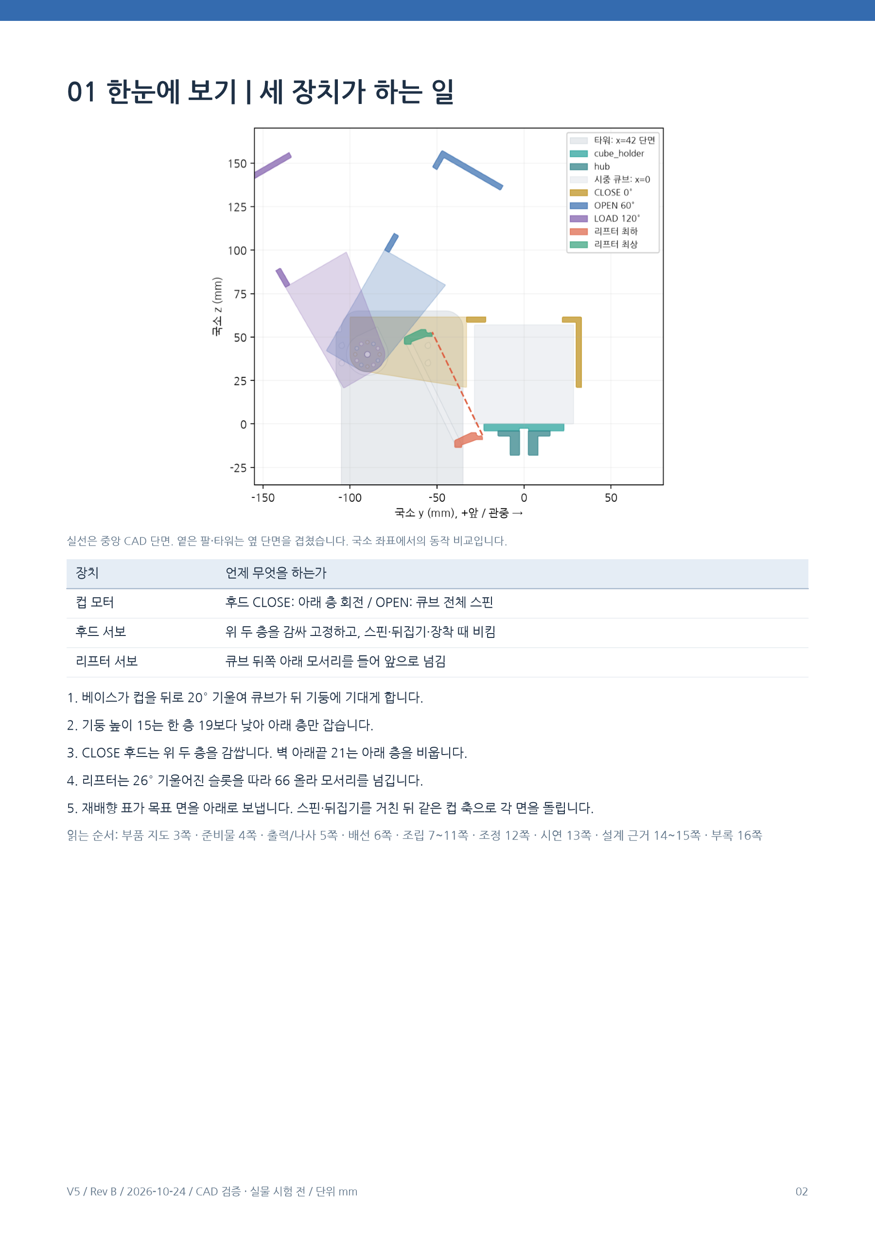
docs/images/v5_manual/page_02.png
