26037-arch/physical_computing_project/docs/images/v5_manual/page_05.png

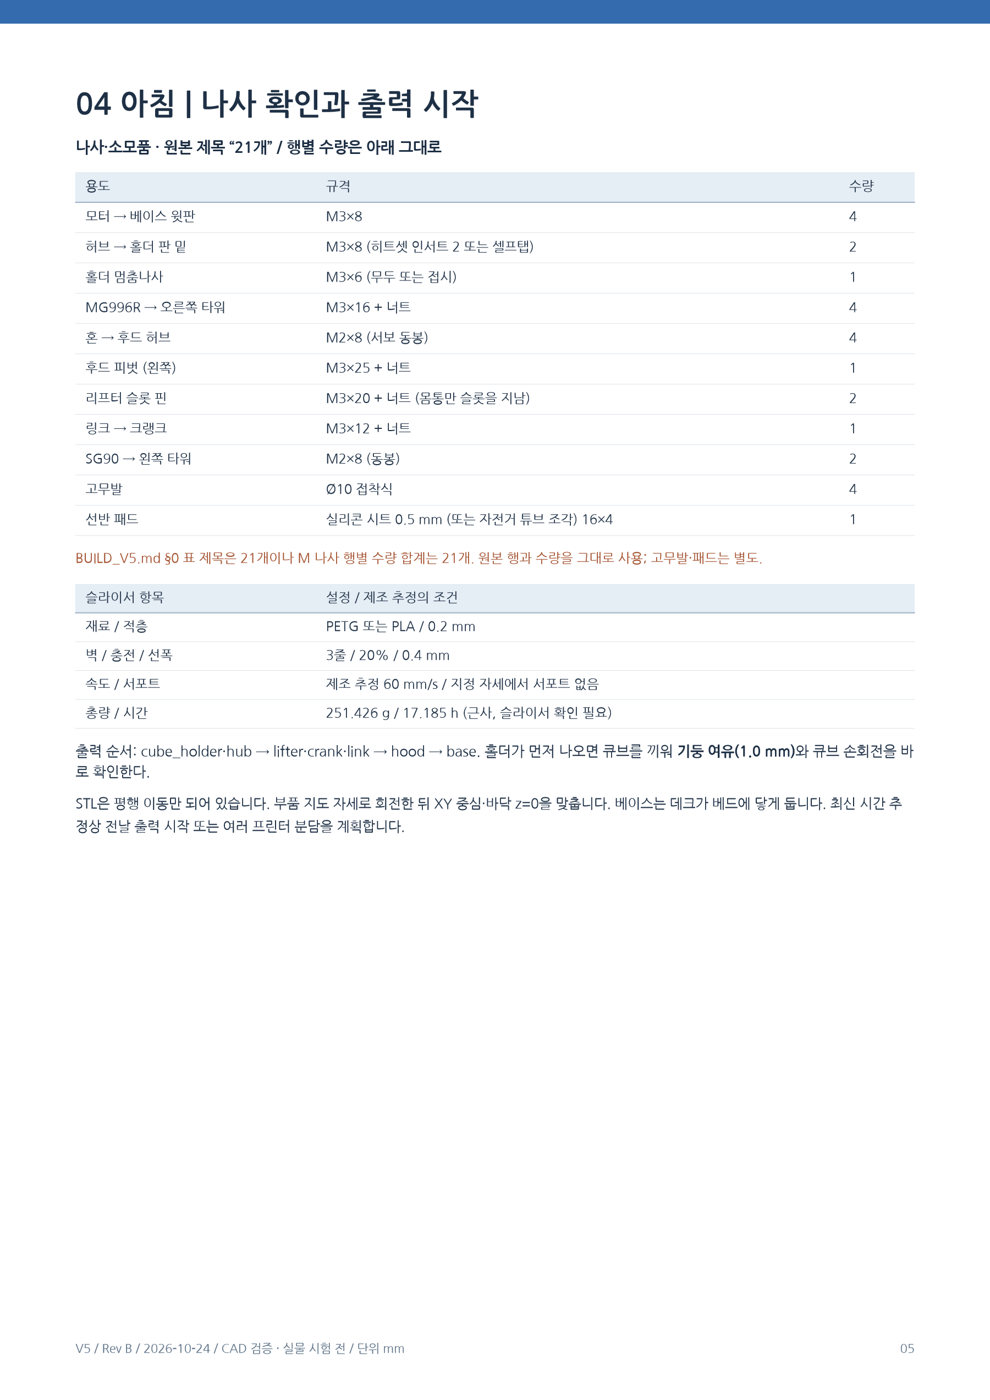
docs/images/v5_manual/page_05.png
