26037-arch/physical_computing_project/docs/images/v5_manual/page_10.png

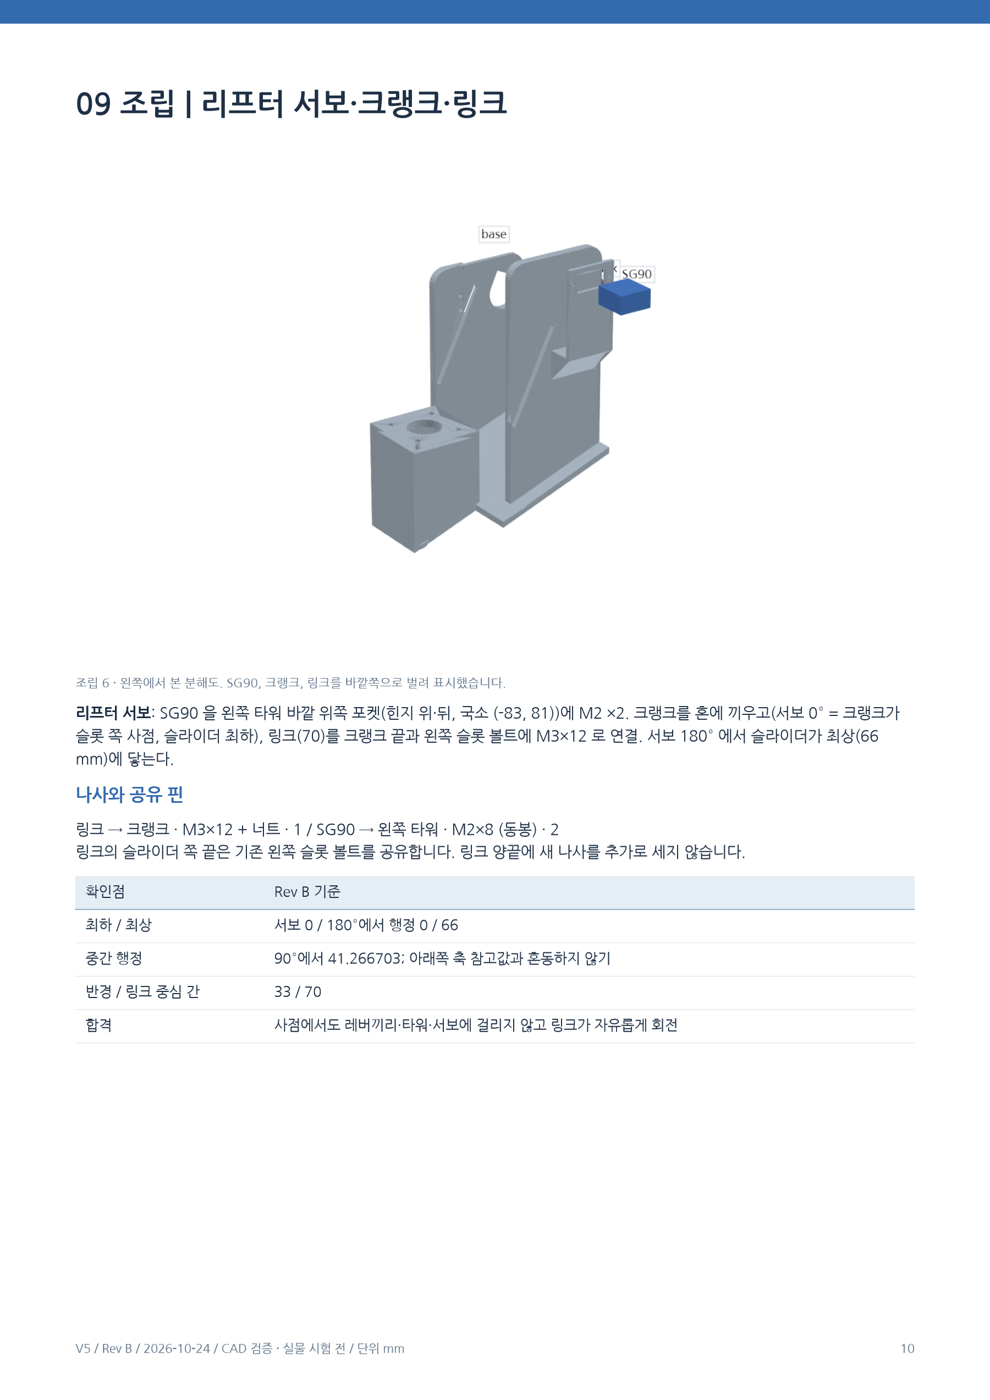
docs/images/v5_manual/page_10.png
