26037-arch/physical_computing_project/docs/images/v5_manual/pages_contact_sheet.png

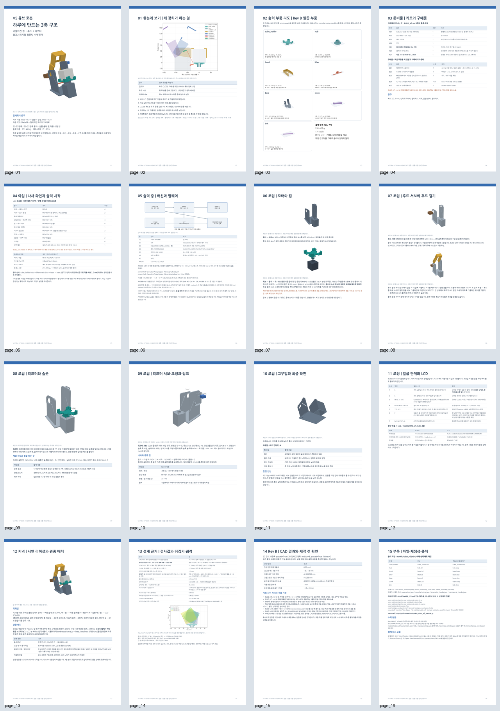
docs/images/v5_manual/pages_contact_sheet.png
