26037-arch/physical_computing_project/docs/images/v5_manual/print_cube_holder.png

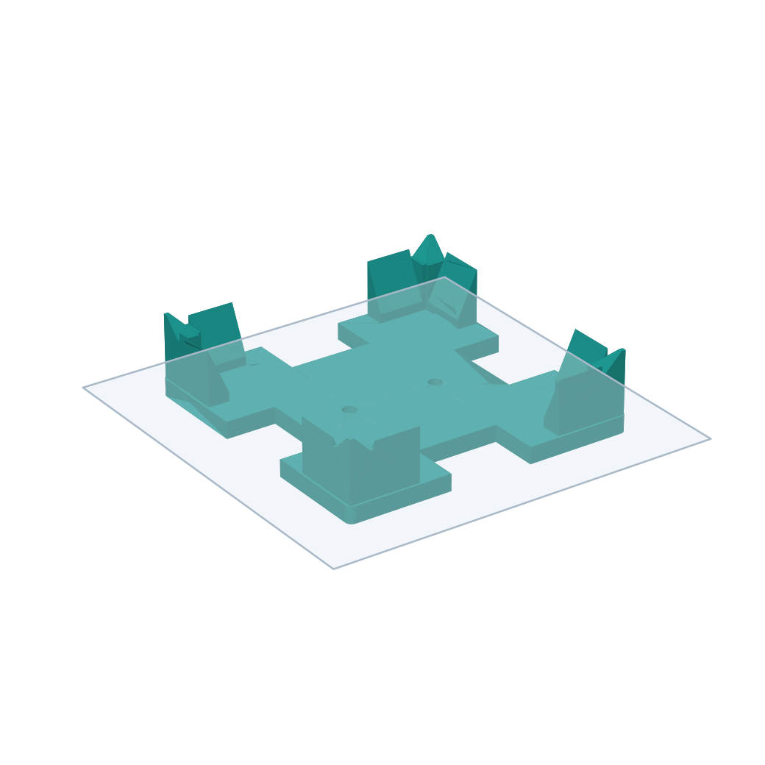
docs/images/v5_manual/print_cube_holder.png
