26037-arch/physical_computing_project/docs/images/v5_manual/print_hub.png

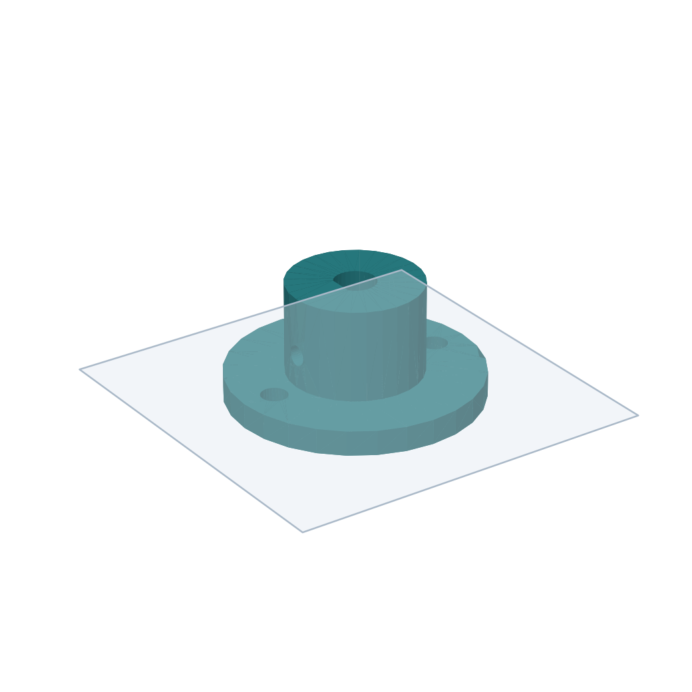
docs/images/v5_manual/print_hub.png
