26037-arch/physical_computing_project/firmware/main/solver.cpp

#include "solver.h"

static const uint8_t MAX_DEPTH = 14;       // 크로스 안전 한계 (상단 고정 15수 크로스, 전수 BFS로 한계 검증)
static const uint8_t F2L_MAX_BOUND = 20;   // F2L 한 쌍 안전 한계 (생성기 전수 검사: 최장 11수)
static const uint8_t N_MACROS = 27;
static const char SLOT_NAMES[4][3] = {"FR", "FL", "BL", "BR"};

// 코너 상태(위치*3+방향)의 위치. AVR에서 매번 /3, %3을 계산하지 않는다.
static const uint8_t CORNER_POS[24] PROGMEM = {
  0,0,0, 1,1,1, 2,2,2, 3,3,3, 4,4,4, 5,5,5, 6,6,6, 7,7,7
};

// 조각 상태 전이 T_M(p, o) = (q, o + o^M(q)),  q = (σ^M)^-1(p)  — EDGE_TO[m][p] = q, EDGE_DO[m][p] = o^M(q).
// 등변성 π_x(s·M) = T_M(π_x(s)) 덕분에 전체 상태 없이 조각 상태만으로 정확히 같은 값을 얻는다 (docs/MATH.md 3절).
// 같은 수로 여러 조각을 갱신하므로 이동표의 행 주소는 한 번만 구한다.
static inline __attribute__((always_inline)) uint8_t eStep(uint8_t s, const uint8_t* to, const uint8_t* delta) {
  uint8_t p = s >> 1;
  return (pgm_read_byte(to + p) << 1) | ((s + pgm_read_byte(delta + p)) & 1);
}
static inline __attribute__((always_inline)) uint8_t cStep(uint8_t s, const uint8_t* to, const uint8_t* delta) {
  uint8_t p = pgm_read_byte(CORNER_POS + s);
  uint8_t ori = s - p * 3 + pgm_read_byte(delta + p);  // 0..4
  if (ori >= 3) ori -= 3;
  return pgm_read_byte(to + p) * 3 + ori;
}

// key_OLL(s) = (Σ_{i<4} oc(i)·3^(3-i)) · 2^4 + Σ_{i<4} oe(i)·2^(3-i)  ∈ [0, 1295]  — U층 코너·엣지 방향만.
//   방향은 위치와 무관한 아핀 함수로 변하므로 (o'(i) = o(σ^A(i)) + o^A(i)) 방향만으로 OLL 경우가 결정된다.
//   유효 OLL 상태 수 = 27 (Σoc≡0) × 8 (Σoe≡0) = 216, U 회전으로 묶으면 57 경우 + 풀린 1.
static uint16_t ollKey(const Cube& c) {
  return ((((c.co[0] * 3 + c.co[1]) * 3 + c.co[2]) * 3 + c.co[3]) << 4) | (c.eo[0] << 3) | (c.eo[1] << 2) | (c.eo[2] << 1) | c.eo[3];
}
// key_PLL(s) = Σ_{i<4} σc(i)·2^(14-2i) + Σ_{i<4} σe(i)·2^(6-2i)  ∈ [0, 2^16)  — U층 위치만 (방향은 이미 0).
//   유효 PLL 상태 수 = 24 × 24 / 2 (부호 일치) = 288, 사전·사후 U 조정으로 묶으면 21 경우 + 풀린 1.
static uint16_t pllKey(const Cube& c) {
  return ((uint16_t)c.cp[0] << 14) | ((uint16_t)c.cp[1] << 12) | ((uint16_t)c.cp[2] << 10) | ((uint16_t)c.cp[3] << 8) | (c.ep[0] << 6) | (c.ep[1] << 4) | (c.ep[2] << 2) | c.ep[3];
}

// ======================= Cross =======================
// h_cross(s) = max over 6 쌍 {a,b} ⊂ {DR,DF,DL,DB} of d_{a,b}(π_a(s), π_b(s)).
//   각 d_{a,b} 는 두 엣지의 사영 그래프(24×24) 에서의 BFS 거리 → 허용적, 최댓값도 허용적 (docs/MATH.md 4절).
//   쌍 표는 한 조각 표보다 강하다: d_{a,b} ≥ max(d_a, d_b) 이고 서로 길을 막는 경우를 반영 (표 최댓값 5).
//   limit 초과 값은 바로 반환해도 "max > limit" 판정은 같다 (조기 탈출).
inline __attribute__((always_inline)) uint8_t Solver::hCross(const uint8_t* es, uint8_t limit) const {
  uint8_t h = 0;
  const uint8_t* table = &CROSS_PAIR[0][0];
  for (uint8_t i = 0; i < 6; i++) {
    uint8_t d = pgm_read_byte(table + es[crossA[i]] * 24 + es[crossB[i]]);
    if (d > limit) return d;
    if (d > h) h = d;
    table += 576;
  }
  return h;
}

// 자식 n' 의 IDA* 조건  g+1+h(n') ≤ bound  ⇔  h(n') ≤ bound-g-1 =: limit.
// h 는 거리표들의 최댓값이므로 거리표 중 하나라도 limit 를 넘으면 최댓값도 넘는다 → 조기 탈출.
inline __attribute__((always_inline)) bool Solver::childFits(const uint8_t* es, uint8_t* es2, uint8_t m, uint8_t limit, uint8_t& h) const {
  const uint8_t* et = EDGE_TO[m];
  const uint8_t* ed = EDGE_DO[m];
  for (uint8_t i = 0; i < 4; i++) es2[i] = eStep(es[i], et, ed);
  h = hCross(es2, limit);
  return h <= limit;
}

// IDA*: f = g + h ≤ bound 인 노드만 내려간다 (remaining = bound - g).
//   중복 수열 제거 — 같은 면 연속 금지 (X^a X^b = X^(a+b) 로 한 수), 반대면은 가환 (U D = D U) 이라
//   면 번호가 작은 쪽을 먼저 오는 순서만 허용 (U D 허용, D U 금지). 분기 18 → 평균 ≈ 13.3.
//   h 가 허용적이므로 bound 를 h(s0) 부터 1씩 올리며 처음 찾는 해는 허용 수 집합 안에서 최단이다.
// 진입 시 휴리스틱 검사는 끝난 상태. 탈락할 자식에 대한 재귀 호출을 생략한다.
bool Solver::searchCross(const uint8_t* es, uint8_t g, uint8_t remaining, int8_t lastFace) {
  uint8_t es2[4];
  uint8_t limit = remaining - 1;
  for (int8_t f = 0; f < 6; f++) {
    if (f == FACE_D || f == lastFace) continue;
    if (lastFace >= 3 && f == lastFace - 3) continue;
    // f*3, f*3+1, f*3+2 순서이므로 원래 m=0..17 순서와 같다.
    uint8_t end = f * 3 + 3;
    for (uint8_t m = end - 3; m < end; m++) {
      nodes++;  // 생성한 자식마다 한 번, 반드시 그 자식의 휴리스틱 검사 전
      uint8_t h;
      if (!childFits(es, es2, m, limit, h)) continue;
      path[g] = m;
      if (h == 0) { pathLen = g + 1; return true; }
      if (searchCross(es2, g + 1, limit, f)) return true;
    }
  }
  return false;
}

bool Solver::idaCross(const uint8_t* es, uint8_t maxBound) {
  // 이번 IDA* 동안 변하지 않는 쌍 번호를 미리 읽는다.
  for (uint8_t i = 0; i < 6; i++) {
    crossA[i] = pgm_read_byte(&CROSS_PAIRS[i][0]) - 4;
    crossB[i] = pgm_read_byte(&CROSS_PAIRS[i][1]) - 4;
  }
  uint8_t h = hCross(es, 255);
  if (h == 0) { pathLen = 0; return true; }
  for (uint8_t bound = h; bound <= maxBound; bound++)
    if (searchCross(es, 0, bound, -1)) return true;
  return false;
}

// ======================= F2L =======================
// 매크로 번호 i → 겉면 수열. 0..2 = U U2 U' (비용 1), 3 + (slot*2+fam)*3 + k = X U^(k+1) X^-1 (비용 3),
//   X = F2L_TRIG[slot][fam] (fam 0: a U^k a', fam 1: b' U^k b).  sim/solver.js 의 MACROS 와 같은 번호·같은 수열.
uint8_t Solver::macroMoves(uint8_t i, uint8_t* out) {
  if (i < 3) { out[0] = FACE_U * 3 + i; return 1; }
  uint8_t t = i - 3;
  uint8_t X = pgm_read_byte(&F2L_TRIG[t / 6][(t / 3) & 1]);
  out[0] = X;
  out[1] = FACE_U * 3 + t % 3;
  out[2] = (X / 3) * 3 + 2 - X % 3;  // X 의 역수
  return 3;
}
uint8_t Solver::macroKind(uint8_t i) { return i < 3 ? 0xFF : (i - 3) / 3; }

// 매크로 IDA*: 상태 = 쌍 (cs, es) 2바이트, h = F2L_PAIR[slot] (매크로 그래프의 최단 겉면 수, 255 = 도달 불가).
//   allowedMask 비트 q = 슬롯 q 의 트리거 허용(미완성 슬롯). 완성 슬롯의 트리거를 금지하면 표 값은 하한이 된다.
//   같은 종류 연속 금지: U U = 한 수, (X U^a X')(X U^b X') = X U^(a+b) X'.  g 는 겉면 수, depth 는 매크로 수.
bool Solver::searchF2L(uint8_t cs, uint8_t es, uint8_t g, uint8_t depth, uint8_t bound, int8_t last, const uint8_t* table, uint8_t allowedMask) {
  uint8_t h = pgm_read_byte(table + cs * 24 + es);
  if (h == 255 || g + h > bound) return false;
  if (h == 0) { mpathLen = depth; return true; }
  uint8_t mv[3];
  for (uint8_t i = 0; i < N_MACROS; i++) {
    if (i >= 3 && !(allowedMask & (1 << ((i - 3) / 6)))) continue;
    if (last >= 0 && macroKind(last) == macroKind(i)) continue;
    nodes++;  // 전개한 매크로마다 한 번 (sim/solver.js 와 같은 셈)
    uint8_t n = macroMoves(i, mv);
    uint8_t c2 = cs, e2 = es;
    for (uint8_t j = 0; j < n; j++) {
      c2 = cStep(c2, CORNER_TO[mv[j]], CORNER_DO[mv[j]]);
      e2 = eStep(e2, EDGE_TO[mv[j]], EDGE_DO[mv[j]]);
    }
    mpath[depth] = i;
    if (searchF2L(c2, e2, g + n, depth + 1, bound, i, table, allowedMask)) return true;
  }
  return false;
}

// ======================= OLL / PLL =======================
// s·r·A 가 방향 0  ⇔  key_OLL(s·r) = key_OLL(I·A^-1).  r ∈ {id, U, U2, U'} 순서로 첫 매치 (sim/solver.js 와 동일 순서).
bool Solver::lookupOLL(const Cube& c, uint8_t* out, uint8_t& n, char* name) {
  for (uint8_t r = 0; r < 4; r++) {
    Cube t = c;
    if (r) t.move(FACE_U * 3 + r - 1);
    uint16_t key = ollKey(t);
    n = 0;
    if (r) out[n++] = FACE_U * 3 + r - 1;
    if (key == 0) { strcpy(name, "OLL skip"); return true; }
    for (uint8_t i = 0; i < OLL_COUNT; i++) {
      if (pgm_read_word(&OLL_KEY[i]) != key) continue;
      uint16_t a = pgm_read_word(&OLL_OFF[i]), b = pgm_read_word(&OLL_OFF[i + 1]);
      for (uint16_t k = a; k < b; k++) out[n++] = pgm_read_byte(&OLL_MOVES[k]);
      sprintf(name, "OLL %u", pgm_read_byte(&OLL_NUM[i]));
      return true;
    }
  }
  return false;
}

// s·r·A·u = I  ⇔  s·r = u^-1·A^-1.  표의 각 항목은 (A, u) 와 key_PLL(I·u^-1·A^-1); 매치되면 풀이 = r, A, u.
bool Solver::lookupPLL(const Cube& c, uint8_t* out, uint8_t& n, char* name) {
  Cube solved;
  uint16_t solvedKey = pllKey(solved);
  for (uint8_t r = 0; r < 4; r++) {
    Cube t = c;
    if (r) t.move(FACE_U * 3 + r - 1);
    uint16_t key = pllKey(t);
    n = 0;
    if (r) out[n++] = FACE_U * 3 + r - 1;
    if (key == solvedKey) { strcpy(name, "PLL skip"); return true; }
    for (uint8_t i = 0; i < PLL_COUNT; i++) {
      if (pgm_read_word(&PLL_KEY[i]) != key) continue;
      uint16_t a = pgm_read_word(&PLL_OFF[i]), b = pgm_read_word(&PLL_OFF[i + 1]);
      for (uint16_t k = a; k < b; k++) out[n++] = pgm_read_byte(&PLL_MOVES[k]);
      uint8_t auf = pgm_read_byte(&PLL_AUF[i]);
      if (auf) out[n++] = FACE_U * 3 + auf - 1;
      strcpy(name, "PLL ");
      strcpy_P(name + 4, PLL_NAMES[pgm_read_byte(&PLL_NAME_IDX[i])]);
      return true;
    }
  }
  return false;
}

// ======================= 전체 =======================
bool Solver::solve(const Cube& start, uint8_t* out, uint8_t& outLen, StageCallback cb) {
  Cube c = start;
  outLen = 0; nodes = 0;
  uint8_t stage[STAGE_MAX], stageLen;
  char name[12];

  // 1. Cross — 크로스 엣지 DR DF DL DB 의 상태만 추적
  uint32_t t0 = millis(), n0 = nodes;
  uint8_t es[4];
  for (uint8_t i = 0; i < 4; i++) es[i] = c.edgeState(4 + i);
  if (!idaCross(es, MAX_DEPTH)) return false;
  memcpy(stage, path, pathLen); stageLen = pathLen;
  c.apply(stage, stageLen); memcpy(out + outLen, stage, stageLen); outLen += stageLen;
  if (cb) cb("CROSS", stage, stageLen, nodes - n0, millis() - t0);

  // 2. F2L — 쌍마다 가장 쉬운 슬롯부터 (그리디)
  uint8_t allowedMask = 0x0F;  // 미완성 슬롯 비트
  for (uint8_t k = 0; k < 4; k++) {
    t0 = millis(); n0 = nodes;
    // 후보 슬롯: 거리표 값 오름차순, 같으면 번호 순 (삽입 정렬)
    uint8_t cand[4], candD[4], candC[4], candE[4], nc = 0;
    for (uint8_t s = 0; s < 4; s++) {
      if (!(allowedMask & (1 << s))) continue;
      uint8_t cs = c.cornerState(4 + s), e = c.edgeState(8 + s);
      uint8_t d = pgm_read_byte(&F2L_PAIR[s][cs * 24 + e]), j = nc;
      while (j > 0 && candD[j - 1] > d) { cand[j] = cand[j - 1]; candD[j] = candD[j - 1]; candC[j] = candC[j - 1]; candE[j] = candE[j - 1]; j--; }
      cand[j] = s; candD[j] = d; candC[j] = cs; candE[j] = e; nc++;
    }
    // 한계 B 를 가장 작은 표 값부터 1씩 올리며 B 안에 풀리는 첫 후보를 택한다
    int8_t chosen = -1;
    for (uint8_t B = candD[0]; B <= F2L_MAX_BOUND && chosen < 0; B++) {
      for (uint8_t i = 0; i < nc; i++) {
        if (candD[i] > B) continue;
        if (searchF2L(candC[i], candE[i], 0, 0, B, -1, F2L_PAIR[cand[i]], allowedMask)) { chosen = cand[i]; break; }
      }
    }
    if (chosen < 0) return false;
    stageLen = 0;
    for (uint8_t i = 0; i < mpathLen; i++) stageLen += macroMoves(mpath[i], stage + stageLen);
    stageLen = simplifySeq(stage, stageLen);  // 트리거 경계의 같은 면 연속(R' R 등)을 합친다
    c.apply(stage, stageLen); memcpy(out + outLen, stage, stageLen); outLen += stageLen;
    allowedMask &= ~(1 << chosen);
    strcpy(name, "F2L "); strcat(name, SLOT_NAMES[chosen]);
    if (cb) cb(name, stage, stageLen, nodes - n0, millis() - t0);
  }

  // 3. OLL
  t0 = millis(); n0 = nodes;
  if (!lookupOLL(c, stage, stageLen, name)) return false;
  c.apply(stage, stageLen); memcpy(out + outLen, stage, stageLen); outLen += stageLen;
  if (cb) cb(name, stage, stageLen, 0, millis() - t0);

  // 4. PLL
  t0 = millis();
  if (!lookupPLL(c, stage, stageLen, name)) return false;
  c.apply(stage, stageLen); memcpy(out + outLen, stage, stageLen); outLen += stageLen;
  if (cb) cb(name, stage, stageLen, 0, millis() - t0);

  if (!c.isSolved()) return false;
  outLen = simplifySeq(out, outLen);
  return true;
}
