26037-arch/physical_computing_project/firmware/main/tables.h

// 자동 생성 파일 — 수정하지 말 것. 생성: node tools/gen_tables.js (2026-10-23)
// 큐브 치환표, IDA* 가지치기 거리표, OLL/PLL 인식 키와 공식 수열. 모두 PROGMEM(플래시)에 둔다.
//
// [수학적 정의 — docs/MATH.md]
//  MOVE_*[m]        : 수 M_m = (σ^M, o^M).  적용: σ'(i) = σ(σ^M(i)), o'(i) = o(σ^M(i)) + o^M(i)
//  EDGE_TO/DO[m][p] : 조각 상태 전이 T_M(p,o) = (q, o + o^M(q)), q = (σ^M)^-1(p)   (코너도 동일)
//  CROSS_PAIR[..]   : 조각 집합 P 의 사영 그래프에서 목표까지 BFS 거리 d_P(u). 실제 L수 해의 사영 경로도 길이 L
//                     이므로 d_P(π_P(s)) ≤ d*(s) — 허용적 휴리스틱 (D 제외 15수 기준).
//  F2L_PAIR[s][..]  : 슬롯 s 의 코너·엣지 쌍이 매크로 수(U^k 비용 1, 트리거 X U^k X' 비용 3)로 풀리기까지의 최단 겉면 수.
//                     트리거는 크로스·다른 슬롯을 보존하므로 F2L 탐색은 쌍 2바이트만 추적한다. 255 = 도달 불가(크로스 자리).
//  F2L_TRIG[s][fam] : 슬롯 s 트리거의 첫 수 X (fam 0: a U^k a', fam 1: b' U^k b). 마지막 수는 X 의 역수.
//  OLL_KEY[i]       : key_OLL(I·A_i^-1) — 공식 A_i 의 역연산을 풀린 큐브에 적용한 상태의 방향 키.
//                     s·r·A 가 방향 0 ⇔ key_OLL(s·r) = OLL_KEY  (방향은 위치와 무관한 아핀 함수로 변하므로)
//  PLL_KEY[i]       : key_PLL(I·u^-1·A^-1), PLL_AUF[i] = u.   s·r·A·u = I ⇔ s·r = u^-1·A^-1
//  공식 수열은 wide/슬라이스/회전을 겉면 6면 수로 변환한 것: ρ X = X^ρ ρ 로 회전을 오른쪽으로 밀어 S = S'·ρ_net,
//                     풀린 상태는 회전 불변이므로 s·S = I ⇔ s·S' = I.  (sim/cube.js expandAlg)
//  생성 시 OLL 216 상태·PLL 288 상태 전부에 대해 "조회됨 ∧ 적용 후 목표 달성" 을, F2L 은 완성 슬롯 조합 8가지 × 쌍 상태 전부가
//  허용 매크로만으로 풀리는지를 검사한다.
#pragma once
#include <stdint.h>
#include <avr/pgmspace.h>  // AVR: 플래시 접근, UNO R4(Renesas): 호환 매크로

static const uint8_t MOVE_CP[18][8] PROGMEM = {
  3,0,1,2,4,5,6,7,
  2,3,0,1,4,5,6,7,
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
0,5,2,5,2,5,0,5,0,4,0,3,0,5,2,5,2,5,0,5};
static const uint8_t PLL_AUF[87] PROGMEM = {0,1,2,3,0,1,2,3,0,1,2,3,0,1,2,3,0,1,2,3,0,1,2,3,0,1,2,3,0,1,2,3,0,1,2,3,0,1,2,3,0,1,2,3,0,1,2,3,0,1,2,3,0,1,2,3,0,1,2,3,0,1,2,3,0,1,2,3,0,1,2,3,0,1,2,3,0,1,2,3,0,1,2,3,1,2,3};
static const uint8_t PLL_NAME_IDX[87] PROGMEM = {0,0,0,0,1,1,1,1,2,2,2,2,3,3,3,3,4,4,4,4,5,5,5,5,6,6,6,6,7,7,7,7,8,8,8,8,9,9,9,9,10,10,10,10,11,11,11,11,12,12,12,12,13,13,13,13,14,14,14,14,15,15,15,15,16,16,16,16,17,17,17,17,18,18,18,18,19,19,19,19,20,20,20,20,21,21,21};
#define PLL_NAME_COUNT 22
static const char PLL_NAMES[22][10] PROGMEM = {"Aa","Ab","E","F","Ga","Gb","Gc","Gd","H","Ja","Jb","Na","Nb","Ra","Rb","T","Ua","Ub","V","Y","Z","AUF"};
