26037-arch/physical_computing_project/(commit log)

2026-10-23 Set up physical computing project toolchain
    Arduino CLI build/upload scripts, Wokwi simulation config with a sample
    button/LED circuit and scenario test, Fusion 360 bridge add-in + MCP
    server, and MCP/plugin config for Claude Code and Codex.
2026-10-23 Debounce button with millis() and catch release bounce in test
    The fixed delay(30) after a press missed the bounce on release, so
    releasing the button toggled the LED a second time. Track the raw
    reading and only accept a state change after it has been stable for
    DEBOUNCE_MS.
    The scenario test now holds the button 150ms before releasing (the old
    test released during delay(30), hiding the bug) and checks D13 with
    expect-pin after each release.
    [main.ino]
2026-10-23 Build cube-solving robot: firmware, Wokwi circuit, Fusion parts, JS simulator, report
    Firmware (firmware/main): cubie model, CFOP solver (cross/F2L IDA* with
    piece tracking and offline BFS distance tables, OLL/PLL lookup keys
    generated from inverse algorithms), A4988 x6 stepper control with
    trapezoidal ramp, LCD/buttons/buzzer and serial protocol (S/V/M/P/R/Q).
    Compiles for arduino:avr:uno and arduino:renesas_uno:unor4wifi.
    Tools: gen_tables.js (tables.h + sim/tables.js with full OLL 216 / PLL 288
    coverage check), test_solver.js (300-scramble regression),
    gen_wokwi_test.js (cross-check scenarios), embed_models.js, serve.js.
    Wokwi: diagram.json with 6 A4988 + NEMA17, LCD1602 I2C, 2 buttons,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
    [CubeRobotParts.f3d, center_cap.stl, center_coupler.stl, motor_mount.stl]
2026-10-23 Document the solver math and reflect it in firmware comments
    Add docs/MATH.md: cube state as permutation + orientation vectors,
    move application as group multiplication, single-piece projection and
    its equivariance, admissibility/consistency of the max-of-pair-table
    heuristic, IDA* duplicate pruning and the parent-side child test, the
    F2L extract-then-insert strategy, derivation of the OLL/PLL lookup keys
    from inverse algorithms (with 216/288 case counts), conjugation-based
    conversion of wide/slice/rotation moves, PRNG determinism and complexity.
    Carry the same formulas into firmware/main (cube.h, cube.cpp, solver.h,
    solver.cpp) and the generated tables.h header as comments at the code
    they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
2026-10-23 Build cube robot with printable pin-drive hardware and evaluation guides
    Include the CFOP Arduino firmware, Wokwi circuit and scenarios, Fusion V1
    parts, and Three.js simulator from the existing commit.
    Add a printable 57 mm cube with edge drive sockets and retracting four-pin
    face modules, bearing-supported spindles, and manual feed carriages. Include
    CAD generation and checking scripts, STEP/STL/GLB exports, a design bundle,
    source attribution, and a local Fusion MCP import workflow.
    Document performance assessment, demonstration steps, code explanations,
    and the distinction between V1 hardware and the V2 prototype.
    Validation: 300 solver scrambles passed; seed-1 browser demonstration
    c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
    [CubeRobotParts.f3d, bearing_front_cap.step, bearing_front_cap.stl, bearing_housing.step, bearing_housing.stl, bearing_rear_cap.step, bearing_rear_cap.stl, carriage.step]
2026-10-23 Update the simulator to the V2 pin-drive hardware
    Replace the V1 center-cap scene in sim/app.js with the V2 mechanism from
    tools/build_robot_v2.py: a 57 mm printable cube with edge drive sockets and
    six pin-drive head modules placed with the CAD head_parts() offsets and
    FACES frames. Animate the axis handoff (engage the new pair, then retract
    the old pair 24 mm) and count axis changes; only the turning face's spindle
    rotates. Add head-state chips, a feed-time slider, part visibility toggles,
    and a cube close-up view.
    embed_models.js now embeds the seven V2 head STLs plus parameters.json into
    sim/models.js. serve.js gains a dev screenshot endpoint and stricter path
    containment.
    Codex review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
    [app.js]
2026-10-23 fix Hardware system
    [SHF6_envelope_B.step, SHF6_envelope_F.step, SHF8_envelope_B.step, SHF8_envelope_F.step, axle_coupon.step, axle_coupon.stl, bearing_front_cap_direct.step, bearing_front_cap_direct.stl]
2026-10-23 robot_v4 Draft
    [bearing_front_cap_direct.step, bearing_front_cap_direct.stl, bearing_front_cap_hollow.step, bearing_front_cap_hollow.stl, bearing_housing_direct.step, bearing_housing_direct.stl, bearing_housing_hollow.step, bearing_housing_hollow.stl]
2026-10-23 robot_v4: sync sim and docs with CAD
2026-10-23 Sync sim defaults and firmware naming with HARDWARE_V4 contract
    - sim/app.js: fallback dimensions/offsets now match HARDWARE_V4 section 2/7
    (recess 2 mm, lock tip -23.5, print offsets); lock unit draws its own
    servo envelope (lock_servo_MG996R) and engage switch instead of the D
    module's; hollow spindle length from parameters
    - firmware: MOT_KEY -> MOT_D with V4 comments; serial F refuses when not
    loaded in real mode (same rule as the simulator)
    - docs/index.html: V4 wording (no 6-head, 8 mm recess, key references)
    Verified: build.ps1 OK; Wokwi mechanism_v4, buttons, solve_seed1 pass.
2026-10-23 F2L 을 사람 CFOP 의 트리거 매크로 탐색으로 바꿔 탐색 노드 10만 → 110
    F2L 을 D 제외 15수 전면 IDA* 대신 사람의 직관 F2L 처럼 U 회전 + 트리거
    X U^k X' (슬롯마다 R U^k R', F' U^k F 꼴 2종류) 매크로 27개로만 탐색한다.
    트리거는 정의상 크로스·다른 슬롯을 보존하므로 탐색 상태는 끼우는 쌍 2바이트(384 상태)
    뿐이고, F2L_PAIR 거리표는 그 매크로 그래프의 최단 겉면 수(대부분 정확)다.
    쌍 선택은 거리표 값이 작은 슬롯부터, 한계를 1씩 올리며 후보를 번갈아 본다.
    - tools/gen_tables.js: 트리거 매크로 거리표 생성, F2L_TRIG 출력, 트리거 보존성·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
2026-10-23 Add V4 manufacturing reinforcements and detailed Korean build manual
    [alignment_cube.step, alignment_cube.stl, base_angle_B_-200.step, base_angle_B_200.step, base_angle_F_-200.step, base_angle_F_200.step, base_angle_L_-200.step, base_angle_L_200.step]
2026-10-23 robot_v4: 측면 띠 판, 6 mm 잠금 막대, 원뿔 핀으로 물리 간섭·여유 문제 해결
    - 측면 구동판을 16×50 적도 띠(drive_plate_strip ×4)로, 측면 허브 플랜지를 16×32로 바꿔
    D 층 회전(쓸림 반경 38.65)이 결합된 측면 쌍과 겹치지 않게 함 (이전 50×50 판은 45° 에서
    코너당 590 mm³ 겹침). D 판만 50×50 drive_plate_2pin 유지.
    - 잠금 막대 8×8 → 6×6, 센터 소켓 6.4×깊이 5, 결합 끝 −22.5/후퇴 −52.5: 소켓 바닥·M3 머리까지
    축방향 여유 1.0 mm (이전 0, 사점 크랭크). 중공축 대각 여유 0.34 → 1.76, M3 자리 Ø6.
    - 핀 끝 90° 원뿔(Ø3→Ø1) + 엣지 소켓 90° 카운터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
    [bearing_front_cap_direct.step, bearing_front_cap_hollow.step, bearing_housing_direct.step, bearing_housing_hollow.step, bearing_rear_cap_direct.step, bearing_rear_cap_hollow.step, carriage_direct.step, carriage_hollow.step]
2026-10-23 Simplify V4 assembly with extrusion-mounted servo cradles
    [alignment_cube.step, base_angle_B_-200.step, base_angle_B_200.step, base_angle_F_-200.step, base_angle_F_200.step, base_angle_L_-200.step, base_angle_L_200.step, base_angle_R_-200.step]
2026-10-23 fix(v4): unify simulator and Arduino control contract
    [Arduino.h, app.js, cube.cpp, main.cpp, main.ino, mechanism.cpp, mechanism.h]
2026-10-24 fix(v4): address mechanical risks and refresh fabrication reports
    [fastener_BOM.csv, lock_switch_bracket.step, lock_switch_bracket.stl, parts_BOM.csv, rail_support.step, rail_support.stl, robot_assembly.step, robot_build_assembly.step]
2026-10-24 V5: 하루에 만드는 3축 큐브 로봇 (기울어진 컵 + ㄷ자 후드 + 리프터) — 설계·검사·펌웨어·CAD·시뮬레이터·PDF
    V4(측면 핀 헤드 4 + 중공 D 헤드 + 잠금 막대, 구동기 11·출력 93)를 시중 57 mm 큐브 +
    NEMA17 1(컵) + MG996R(후드) + SG90(리프터)의 V5 Rev B 로 바꾼다. 출력 7종·나사 21개.
    - docs/HARDWARE_V5.md 계약(좌표·치수·절차·핀·검사값·CAD 8절·Fusion 8.5절), BUILD_V5.md 하루 제작,
    CAD/SIM/MANUAL 브리프(Codex 분업), REPORT 변경표 11·검증표, AGENTS/PIPELINE 갱신
    - tools/robot_v5_params.py + check_robot_v5.py: 2D 운동학·준정적 힘 평형 33항목 통과
    (전복 65.1°, 착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
    [CubeRobotV5.f3d, base.step, base.stl, crank.step, crank.stl, cube_holder.step, cube_holder.stl, hood.step]
2026-10-24 V5 를 v5/ 하위 트리로 분리 (V4 Rev D 와 공존 준비)
    v5/firmware/main, v5/sim, v5/tests, v5/diagram.json, v5/wokwi.toml, v5/scripts, v5/tools/gen_*.js 를
    최상위 V5 사본에서 복사하고 embed_models_v5.js·문서·설명서 생성기의 경로를 v5/ 로 바꾼다.
    최상위 firmware/sim/tests 는 다음 병합에서 origin/master 의 V4 Rev D 로 돌아간다.
